Focerqc/testing-BMS-designs/docs/slave-18s-design-basis.md

# ADBMS1818 18S slave: design basis

Status: **schematic complete for a first bench board, PCB roughly grouped with the connector
row and holes placed, 2026-11-06.**
Every part is on the root sheet with Value, Footprint, LCSC and MPN filled in, grouped by
function, and connected with net labels (see "Schematic nets"). kicad-cli ERC: 0 errors, 0
warnings. Hot-plug protection, test points and mounting holes were added on 2026-11-06 (see
"Protection and test points"). Net classes and HV clearance rules are in the project (see
"Net classes and clearance rules"). Placement, outline and routing are not done. The JLC BOM
is `slave-18s/bom.csv`.

## Scope

- One ADBMS1818 monitoring up to 18 series Li-ion cells (4.2 V max each, 75.6 V stack).
- isoSPI daisy chain: port A in, port B out (ISOMD tied to VREG).
- Passive balancing through the internal S-pin switches.
- Thermistor inputs on GPIOs.
- No power switching and no charge control. Those live in the master, a bought ENNOID
  Master-XLITE-ISC (decision 2026-11-06, see `docs/master-ennoid-xlite.md`). No XT30s on
  the slave.

## Variants: 18S Guard and 18S Lean (split 2026-11-06)

| | **18S Guard** (`slave-18s/`) | **18S Lean** (`slave-18s-lean/`) |
|---|---|---|
| Use | Hot-plug harnesses, unknown packs, bench work | Known pack, harness plugged in once; closer to the Ennoid-style slaves |
| Tap fuses F100–F118, supply fuses F119/F120 | yes | no: trace fuses were deferred, so no fuse protection is designed in (clarified 2026-11-11). F120's place is taken by the net tie NT1 (CELL0 to V−, since 2026-11-06) |
| Zener clamps D101–D118 | yes | no |
| V+ TVS D301 | yes | no: with no F119 ahead of it, a shorted TVS would short the whole stack |
| C-pin filter caps C101–C118 | yes | no (Racc's board has none; the 10 ohm resistors stay) |
| Balance resistors R201–R218 | 33 Ω, 2512, 1 W | **120 Ω, 1206, 0.25 W** (since 2026-11-10, try 3; 33 Ω 2010 in tries 1–2) |
| Series resistors R100–R118 (10 Ω) | 1206 | **0402** (since 2026-11-11, try 4; 0603 in try 3) |
| Board outline | 120 × 70 mm | **70 × 32 mm** (since 2026-11-11, try 4) |
| isoSPI transformers T501/T601 | Pulse HM2113ZNL | Bourns SM91502AL (since 2026-11-08, shrink trial) |
| isoSPI PH alternates J6/J7 (DNP) | yes | no (since 2026-11-09, shrink trial): GH plugs J3/J4 only |
| Test points TP1–TP14 | 10 loops + 4 bare pads | none (since 2026-11-10, try 3) |
| Mounting holes H1–H4 | M3 (3.2 mm) | M2 (2.2 mm) (since 2026-11-10, try 3) |
| Collector resistor R302 | 100 Ω, 0805 | **1 kΩ, 2512, 1 W** (since 2026-11-10; deviation 14) |
| Copper layers | 2 | 4 (since 2026-11-10, try 3c) |
| Everything else | identical | identical |

- **Guard is the source.** `slave-18s-lean/*.kicad_sch` is generated by
  `_tools/kicad_sch/make_lean.py` and must not be edited by hand. After any Guard schematic edit:
  `make_lean.py` -> `kicad-cli sch upgrade --force` -> `check_slave18s.py --variant lean`.
- **Lean nets:** the connector pins land on CELLn directly (no TAPn nets), and VBAT_F is CELL18.
  **CELL0 stays its own net** (J1.1 and R100, the C0 sense). It meets V− only at the net tie
  **NT1** (`Device:NetTie_2`, footprint `NetTie:NetTie-2_SMD_Pad0.5mm`, not in the BOM), which
  `make_lean.py` puts where F120 was. On the PCB, NT1 goes right next to J1.1, and DRC then flags
  any other copper joining CELL0 and V− as a short. That keeps supply current (≤ 35 mA) off the
  C0 sense trace, where it would show up as cell 1 error (about 1.4 mV for 20 mm of 0.25 mm
  1 oz copper). This is the same split Guard makes at J1.1 with F100 and F120.
  (Changed 2026-11-06; before that, CELL0 was merged into V−, and DRC couldn't check the sense
  trace.)
- **Lean PCB:** started as a copy of the Guard board. It needs F8 (Update PCB) in KiCad to drop
  the 58 removed footprints and add NT1 (93 footprints), then its own placement. The libraries
  and 3D model are shared from `../slave-18s/`. After F8, run `make_rules.py --variant lean` to
  replace the `.kicad_dru` copied from Guard. Placement and routing plan:
  `docs/slave-18s-lean-layout-plan.md`.
- **Lean shrink trial (2026-11-08).** Lean is being shrunk toward one ~70 × 35 mm slave of the
  long-term XR slot (156.5 × 37 × 10 mm, two slaves on a carrier). First pass: 70 mm wide, 50 mm
  tall for room to try things. The 120 × 70 board is kept on branch `savepoint/lean-120x70`.
  `make_lean.py` swaps two part types for Lean only (its `SWAP` table; Guard keeps the originals):
  - **R201–R218: 2512 → 2010 (UNI-ROYAL 201007F330JT4E, 33 Ω 1 % 0.75 W, LCSC C421858).**
    Reason: the 18-channel row has to fit 70 mm. Stood vertical, a 2010 is 2.5 mm wide (pads
    2.65 mm), so the channel pitch drops from 4.2 to **3.3 mm** (one 0.25 mm trace with 0.2 mm
    each side between neighbouring pads) and the row from 77 to about 62 mm. Loading: 0.26 W of
    0.75 W (35 %, was 26 % of 1 W) at 33 Ω and 4.2 V. All 18 at once is still about 4.7 W in
    the resistors, now in a 62 × 6 mm strip, so alternate odd/even balancing matters more.
    A 1210 has the same width (same pitch) but only 0.5 W.
  - **T501/T601: Pulse HM2113ZNL → Bourns SM91502AL (SM91502ALE, LCSC C915690).** Reason: half
    the area (courtyard 10.2 × 8.2 mm vs 16.8 × 9.6 mm), 5.72 mm tall. Bourns datasheet (rev.
    07/25): one channel **with common mode choke**, 1CT:1CT, OCL 150–450 µH, leakage 0.5 µH max
    (ADI limits: > 60 µH, < 2.5 µH), hi-pot 4300 VDC, **1000 VDC working** (adjacent 18S modules
    sit about 76 V apart), −40 to +125 °C, AEC-Q200, made for isoSPI. Same pin functions as the
    HM2113ZNL (chip 1–2CT–3, line 6–5CT–4 through the choke), so the symbol and nets are
    unchanged. Footprint `slave18s:Bourns_SM91502AL` drawn from the datasheet's recommended
    layout (pads 0.76 × 1.27 mm, 2.54 mm pitch, rows 7.11/9.65 mm). Bourns marks it "not
    recommended for new designs" with **SM91502ALA** as the replacement; JLC stocks only the
    ALE today (1051 pcs, about $5). Rejected: 4.5 × 3.2 mm LAN transformers (TDK ALT4532 class,
    TAI-TECH TXF453229NF), which state 1.5 kV hi-pot but no working voltage, the same gap that
    ruled out HX1188FNL (about 60 V working, Table 74).
  - Placement is generated by `_tools/kicad_sch/lean_place.py` from a few knobs, so each try is
    one command. Try 1 (2026-11-08): everything fits at 70 × 50 except isoSPI port A (T501, J3,
    J6, R501/R502, C501/C502), which is parked beside the board.
  - **J6/J7 removed from Lean (2026-11-09).** `make_lean.py` drops the DNP PH alternates;
    Guard keeps them. Reason: both isoSPI ports only fit the 70 mm board without them. Lean's
    isoSPI cable is GH only (the ENNOID master uses GH anyway). Lean is now 91 footprints.
  - **TP1–TP10: Keystone 5015 loops → bare 1.5 mm pads, and every test point on the back
    (2026-11-09).** `make_lean.py` swaps TP1–TP10 to the same `TestPoint_Pad_D1.5mm` as TP11–TP14
    (no part, not in the BOM, no LCSC/MPN), so Lean has no test-point parts to order. Reason: the
    loops were never asked for (VESC-style BMS boards use bare pads), and the loops plus their
    ≥ 5 mm hook-clip spacing took about 23 × 6 mm of front copper on a board that has to shrink to
    35 mm. All 14 pads sit on B.Cu, so the front keeps its room for the circuit. Cost: probing is
    from the underside with a tip or spring pin, the back needs standoffs (TP11–TP14 carry
    25–75 V), and the pour on the back has small cut-outs round each pad. This is a deviation from
    the single-sided rule, limited to bare pads (no assembly step, no height): `check_pcb_parity.py`
    expects Lean's `TP<n>` on B.Cu and everything else on F.Cu. `lean_place.py` runs
    `flip_back.py --test-points` after placing. isoSPI pads TP7–TP10 hang a short stub on the chip
    side lines when routed; keep it under the pad (via-in-pad is not needed at 1.5 mm) or leave
    them off the final board. Guard keeps the loops on the front.
  - **Try 2 (2026-11-09): everything is on the 70 × 50 board, nothing parked.** Each port is one
    strip right of U1, left to right: R/C column (4 × 0603), transformer (chip side toward U1),
    GH plug at the right edge, courtyards 0.3 mm apart. Port B (T601, J4) on top, 1 mm under the
    R1 row; port A (T501, J3) 0.3 mm under it, ending just above H2. 0 courtyard overlaps, no
    clearance errors with the rules loaded (the 2 mm isoSPI barrier holds, also between the two
    ports), parity PASS. **Cost:** each transformer's courtyard is about 3.7 mm from U1's, and
    the datasheet (p. 86) wants U1 at least 1–2 cm from the transformers. Not solved at this
    width; open item on the placement checklist.
  - **Height:** 35 mm is not reachable with plugs on the top edge. Top to bottom, the cell plugs
    (5.6 mm), tap room (5), the two resistor rows (11.4), fan-in (6) and U1 (13.5) come to about
    41.5 mm before the supply and NTC parts. Without the plugs it is about 31 mm.
  - **Try 2 measured (2026-11-10): the parts are too big for 70 × 35.** Front courtyards add up
    to 1,764 mm²: 50 % of 70 × 50 and 72 % of 70 × 35 (2,450 mm²) before any trace. Largest
    groups: balance resistors 377, isoSPI ports 303, cell plugs 257, series resistors 208,
    M3 holes 196, U1 182 mm².
  - **Try 3 decisions (2026-11-10, by the user, with Racc's answers).** The schematic side is
    done (`make_lean.py`, 77 footprints); the board needs F8 and a new placement.
    - **Balance resistors: 120 Ω in 1206 (UNI-ROYAL 1206W4F1200T5E, LCSC C17909, Basic).** The
      user: low balance current is fine. About 31 mA and 0.12 W per cell, 48 % of the 0.25 W
      rating; all 18 at once is about 2.3 W on the board instead of 6.7 W. This is the value on
      Racc's 12S board. Not 0805: a standard 0805 is rated 0.125 W, no margin (Racc's are 0805
      and he calls that a slight sizing mistake). The 1206 leaves room to go down to about
      82–100 Ω later on the same footprint.
    - **Series resistors: 10 Ω in 0603 (UNI-ROYAL 0603WAF100JT5E, LCSC C22859, Basic).** They
      carry the balance current: about 10 mW at 31 mA, 10 % of the 0.1 W rating. Guard keeps
      1206 (79 mW at 33 Ω). Racc: on his board the 10 Ω could have been smaller.
    - **No test points on Lean.** They were never asked for, Racc's board has none, the same nets
      can be probed on a resistor or capacitor pad, and back-side pads can't be reached with the
      board flat on a carrier. This ends the back-side exception of 2026-11-09: every Lean
      footprint is on the front again.
    - **Mounting holes: M2** (`MountingHole_2.2mm_M2`). The copper keep-out in `make_rules.py`
      is still the M3 figure and has to follow for Lean.
    - **Four copper layers.** Not applied to the board yet; stack-up and the rules that assume
      JLC 2-layer (`make_rules.py`) are chosen when routing starts.
    - **Assembly stays front only, flat on a carrier.** One board has to work both ways: alone
      on a harness (plugs fitted) and on the XR carrier (soldered to it through the JST pin
      holes). So both cell plugs and both isoSPI ports stay on every slave.
    - **Transformer distance accepted: deviation from the datasheet's 1–2 cm (p. 86).** Racc's
      board has its transformers a few mm from the chip and he had no link trouble; he credits
      the split termination and centre-tap caps, which this design keeps (deviation 1).
    - **Q301 copper:** Racc: more is better, no figure. Give it what fits on several layers and
      measure the first board.
    - **Trace fuses:** deferred by the user.
    - **Open:** where the cell plugs go (top edge, a short edge, or fitted from the back as on
      Racc's board, where it was done for ENNOID pin compatibility, not space). Estimated, not
      built: rows 11.4 → about 7.9 mm and tap room 5 → about 2 mm bring the stack-up from 41.5
      to about 35 mm with the plugs on the top edge, with no margin for the supply parts.
    - **Not designed in:** solder jumpers for fewer than 18 cells (Racc's JP4–JP12). Lean is
      18S only; a smaller pack would need the unused inputs shorted in the harness.
  - **Try 3 placed (2026-11-10): 70 × 37 mm, 77 footprints, all on the front, nothing routed.**
    37 mm is the XR slot's own height; 35 mm is still not reached with the plugs on the top edge.
    From `lean_place.py`: cell plugs top-left, the 18-channel row under them at **2.4 mm pitch**
    (44.8 mm long, about as wide as the plugs, so the tap room is 2 mm), U1 under the row's right
    half, both isoSPI ports top-right (GH plug at the top edge, transformer under it with the chip
    side down, its four R/C parts under the transformer), supply column and Q301 right of U1,
    J2 and the NTC parts bottom-left. H3 is on the right edge, not in its corner. The F8 left the
    14 test pads (delete box not ticked) and the locked M3 holes; both were fixed in the board
    file. 0 courtyard overlaps, parity PASS, DRC: silkscreen items and 153 unconnected only.
    - Pad to U1 pin: C304/C305 (VREF) 2.2/2.3 mm, R401/R402 2.2 mm, C303 (VREG) 4.1 mm, C301
      (V+) 4.7 mm, Q301 6–8 mm (try 2: 7–10, 8–9, 10, 28 and 37 mm).
    - Transformer courtyard to U1's: T601 6.5 mm, T501 14.1 mm (try 2: 3.7 mm both).
    - The slot that blocked ch 14–18 on try 2 is gone: nothing sits between the row and U1.
    - **Not good yet:** the NTC filter parts are 34 mm from GPIO1–4 and their nets have to cross
      the ch 0–10 bus (needs an inner layer); Q301 has no reserved copper; the hole keep-out for
      M2 (2.75 mm from the centre, `make_rules.py`) is my figure for a 5 mm washer.
  - **Try 3b (2026-11-10): connectors where the user wants them, the rest placed for routing.**
    The user moved J2 to stand on the left edge (all plugs along or near the top edge) and asked
    that the connectors stay in their areas; everything else was free. From `lean_place.py`:
    - All four holes are in the corners again; the GH plugs sit 5 mm down from the top edge to
      clear H3 (they are top-entry, so they don't need the edge).
    - Tap room 1 mm (the taps also fan out under the plug bodies), row y 6.9–14.8, U1 centred
      under ch 11–18 (centre x 42.5) with 5.3 mm between the row's and U1's courtyards, and
      3.4 mm from U1's courtyard to the bottom edge for the S3…C0 wrap.
    - Right of U1 in its pin order: isoSPI pairs, R402/R401, C304/C305, DRIVE, with C303 under
      pin 48. The port A pair passes under port B's termination row. Q301 bottom-right.
    - Pad to U1 pin: C303 2.3, C304 2.8, C305 3.8, R401 3.6, R402 2.6, C301 4.5, Q301 6.0–8.4 mm.
      Transformer courtyards 6.5 and 15 mm from U1's.
    - **NTC filter parts sit under J2, 39 mm from GPIO1–4.** GPIO1–4 and VREF2 have to cross the
      ch 0–10 bus, so they need an inner layer. The right side of U1 has no room for them.
    - Estimates, to be proven by routing: the ch 11–18 fan-in (worst trace 4.9 mm sideways in
      about 5.6 mm) and the six-trace wrap under U1 in 3.4 mm.
  - **Try 3c (2026-11-10/11): four copper layers, 1 kΩ R302, VCOLL copper for Q301, U1 further
    left.** After the F8 for R302 the user sketched U1 near the middle of the board (centre x
    about 31.5) with Q301 and R302 right of it, and asked why the area left of U1 stays empty.
    From `lean_place.py`:
    - **U1 centre x 37.0** (was 42.5), 5.3 mm under the row as before. Not 31.5: the top side of
      U1 takes C18…C11 and S18…S12, and those come from the right half of the row. At 37 the
      worst trace (ch 18) runs 10.5 mm sideways in the 5.3 mm gap and about 10 traces cross the
      busiest line (about 4.5 mm of the 5.3 mm at 0.25/0.2 mm). At 31.5 it is 16 mm and 12
      traces (5.4 mm), which does not fit on one layer. At 42.5 it was 4.9 mm. **Calculated,
      not routed;** an inner layer can take half of them if it turns out too tight.
    - What the 5.5 mm buys: T601 is about 12 mm from U1 (6.5 in try 3b; the datasheet asks for
      1–2 cm), the VCOLL copper outline is about 40 % larger, and the ch 0–10 bus and the NTC
      nets are 5.5 mm shorter.
    - Right of U1, in its pin order: C301 and R301 lying at pin 1 (under the fan-in, VP_F pads
      toward the pin), the isoSPI pairs, R402, R401, C304, C305, DRIVE, C303 under pin 48.
      Then Q301 (pins toward U1, tab right), C302 above the tab, R302 right of Q301 with its
      VCOLL pad at the tab.
    - **VCOLL copper, reserved as zones (`VCOLL_Q301_front`, `VCOLL_Q301_inner_back`):** outline
      113 mm² on the front and 183 mm² each on In1, In2 and the back, joined by 43 vias
      (0.6/0.3 mm) under Q301's body and right of its tab; none in the tab pad (open vias in a
      pad wick solder). The zones are written unfilled; KiCad fills them (key B). They start
      0.7 mm right of Q301's DRIVE/VREG pads and 1.3 mm under the termination rows (room for the
      port A pair plus 0.6 mm). This is far less than the 25 × 25 mm that DS33175 rates at
      78 °C/W, so **Q301's temperature is still an estimate until a board is measured.**
    - Pad to U1 pin: C303 2.3, C304 2.8, C305 3.8, R401 3.6, R402 2.6, C301 4.1, Q301 6.0–8.4 mm.
    - Checks: 0 courtyard overlaps, parity PASS, `make_rules.py --variant lean --check` OK, DRC
      with the zones filled (`--refill-zones`): silkscreen items and 151 unconnected, no clearance
      errors. Without the fill, DRC reports the 43 vias as dangling.
    - **Stack-up not chosen.** The board file lists four copper layers and nothing more. JLC
      multilayer (capabilities page, 2026-11-10): outer 1 or 2 oz, inner 0.5 oz by default, 1 or
      2 oz on request. Thicker inner copper would spread Q301's heat better.
    - **Still open:** CELL18 has to reach R302's far pad round the isoSPI ports on an inner layer;
      the NTC parts are still under J2, about 33.5 mm from GPIO1–4.
    - **30 mm height (the user's wish, so connectors fit on the carrier above the slaves):** the
      37 mm is plugs 5.6 + tap room 1 + rows 7.9 + fan-in 5.3 + U1 13.5 + wrap 3.4. Taking the
      cell plugs off the slave removes 6.6 mm (about 30.4 mm left); nothing else in the stack
      gives that much. Not decided.
  - **Try 4 (2026-11-11): 70 × 32 mm, placed, nothing routed.** The user: the cell plugs stay
    on the slave, and 5 mm should come off the height so the carrier (37 mm) can hold connectors
    above the slaves. Try 3c (70 × 37) is commit `5306098`. From `lean_place.py`:
    - **Where the 5 mm came from.** With the try 3c parts only 3.7 mm was left for the fan-in
      above U1 plus the room below it (8.7 mm at 37 mm). So:
      R100–R118 **0603 standing → 0402 lying** (row 3.05 → 1.03 mm, 2 mm); tap room 1.0 → 0.5 mm;
      room under U1 3.4 → 1.3 mm. The fan-in gap is 4.9 mm (was 5.3).
    - **R100–R118: 10 Ω 1 % 0402, UNI-ROYAL 0402WGF100JTCE, LCSC C25077, Basic** (about 4 M in
      stock, local parts DB). They carry the balance current: about 10 mW at 31 mA, 16 % of the
      62.5 mW rating (about 20 mW if the balance resistors later go down to 82 Ω). Lying, a
      part is 1.95 mm wide at the 2.4 mm pitch; Sn comes down through the 0.9 mm between the
      pads of two neighbours. Lean has no C-pin caps, so no inrush runs through them.
      `make_lean.py` `SWAP`; Guard keeps 1206.
    - **U1 centre x 36.0**, courtyard 1.3 mm from the bottom edge. One trace fits under it, so
      only VREG (pin 48 to C303) runs there. **S3…C0 and GPIO1–4 have to leave the bottom pins
      through vias under the chip** (between the pad row and the EP) and continue on inner
      layers. GPIO5–9 go to the EP (V−).
    - Right of U1, a bottom-aligned column 0.6 mm from U1 in pin order: R402, R401, C304, C305,
      a 0.9 mm gap, C303. C301 and R301 lie at pin 1. The two isoSPI pairs leave through the
      2.8 mm between C301 and the column.
    - **Q301 stands right of the column: pins at the bottom edge, tab up.** The 6 mm under the
      termination rows is too low for it lying (7.3 mm). U1 sits at 36 and not 37 so Q301 ends
      just left of R601. Its pins run DRIVE, VCOLL, VREG from the left: VREG (22 mA) comes back
      under the body and through the column gap to C303; **DRIVE (1 mA) has to hop over it on an
      inner layer** (two vias). C302 stands right of Q301 with its VCOLL pad up at the tab; R302
      stays a 2512, lying right of C302 on the bottom edge.
    - **VCOLL copper: one zone `VCOLL_Q301` on all four layers,** outline 119 mm² each, round
      Q301 and under C302/R302, with 31 vias. Try 3c had 113 mm² on the front and 183 mm² on each
      of the other three layers, so Q301 will run hotter here. Still an estimate until measured.
    - **The port A pair has no path on the front** past Q301 and port B's termination row: inner
      layer from near U1 to port A's row.
    - Fan-in: ch 18 runs 11.2 mm sideways (R118 at x 50.4 to pin 2 at 39.25) in 4.9 mm. About
      ten traces cross the busiest line (4.5 mm at 0.25/0.2 mm), so part of it will probably
      need a second layer. Calculated, not routed.
    - Pad to U1 pin: C303 4.5, C304 2.4, C305 2.7, R401 2.6, R402 2.4, C301 4.1, Q301 DRIVE 6.9,
      Q301 VREG 12.9 mm. T601's courtyard is 10.1 mm from U1's; the NTC parts are about 32 mm
      from GPIO1.
    - Checks: 0 courtyard overlaps, parity PASS, `make_rules.py --variant lean --check` OK, DRC
      with the zones filled: silkscreen items and 150 unconnected, no clearance errors.
    - **What makes 32 mm harder than 37 mm:** five things need inner layers (U1's bottom pins,
      DRIVE, the port A pair, CELL18 to R302, the NTC nets), the VCOLL copper is smaller, and
      the fan-in has less room. The first two of these are routed (next bullet); if the rest
      fails, go back to `5306098`.
    - **Where the slave sits in the slot (the user, 2026-11-11):** on the slot's **bottom**
      edge. The 5 mm above it, next to the slave's own cell plugs, is for the connectors on the
      carrier. The "XR slot overlay" drawing on the board's Dwgs.User layer shows it that way
      (slot y −5…32 in board coordinates; it had the slave on the top edge before).
    - **Board Boxes shows the inner layers** since 2026-11-11: In1.Cu (green) and In2.Cu
      (orange) buttons beside F.Cu and B.Cu. The cell lines that look missing with only F.Cu
      on are either on an inner layer (S12–S18, ch 0–2) or not routed yet (ch 3–10).
  - **First routing on try 4 (2026-11-11): the two riskiest pieces, 29 nets, DRC clean.**
    `_tools/kicad_sch/lean_route.py` writes the tracks and vias from the pad positions, so it
    can be run again after `lean_place.py`. 221 segments (front 119, In1 35, In2 67), 30 vias
    of 0.5/0.2 mm. DRC with the zones filled: no clearance, short or hole errors; unconnected
    items 150 → 112.
    - **ch 11–18 fan-in.** C18_F…C11_F run on the front in eight lanes at 0.45 mm pitch
      (y 13.05–16.2), the lowest lane for ch 18. S18…S12 do not share that gap: each drops to a
      via 0.6 mm under the series row, crosses on **In1** (seven lanes at 0.6 mm) and comes up
      at a via just inside U1's top pad row (0.55 mm from the pads, 1.6 mm from the exposed
      pad). So the front carries 8 traces where 15 were counted, and the 4.9 mm gap is not
      tight any more.
    - **V+ filter.** U1 pin 1 straight to C301; C301 to R301 over the top of C301 at y 16.8,
      0.6 mm above C301's V− pad (VP_F is top of stack); CELL18 from R118 down to R301.
    - **U1's bottom pins.** S2, C1_F, S1, C0_F and GPIO1–4 (pins 35–42) fan out with 0.2 mm
      tracks to **one row of eight vias under the chip** (y 27.2, 0.75 mm pitch, between the
      pad row and the exposed pad) and leave on **In2** in eight lanes going left. The four
      cell nets turn up at x 12.5–13.9 and end in vias at R202, R101, R201 and R100; GPIO1–4
      end in vias at their NTC filter parts (GPIO1 also reaches J2 pin 1). All eight are
      bank 0, so they may run side by side.
    - **S3 and C2_F** (pins 33, 34) leave on the front along the strip under U1 (two lanes,
      y 30.8 and 31.26; copper may go to 31.5) and go up at x 20.9 and 20.4 to R203 and R102.
      That is the outside of the ch 3–10 bus: the 16 left-side pins still have to be routed
      inside it, nested the same way.
    - **VREG** runs along the same strip from pin 48 to C303 (0.3 mm at the pin, then 0.4 mm).
      **GPIO5–9** are joined across their pads and tied to the exposed pad from pin 45.
    - Longest nets: GPIO1 50 mm, C0_F 48 mm, S1 46 mm (inner layer, bank 0).
      Clarified 2026-11-11: C0_F carries cell 1 balancing return (~31 mA) while balancing,
      not only microamp sense current; DCP=0 pauses balancing during measurements.
      The C0 sense now runs 48 mm on In2 beside S1; cell 1's balance current returns through
      R100 and C0_F's pin only as far as the datasheet's Figure 99 intends, but the long
      parallel run should be looked at before ordering.
    - The rest was routed the same day (next bullet); only the V− pour is left.
  - **Routing on try 4 finished except V− (2026-11-11): 81 nets, DRC clean, 20 unconnected,
    all V−.** Five more functions in `lean_route.py`, one commit each: 652 segments (front 494,
    In1 69, In2 86, B.Cu 3), 52 vias of 0.5/0.2 mm. A second run changes nothing. Checks after
    each piece: `lean_route.py --drc` (zones filled), `check_pcb_parity.py --variant lean`,
    `make_rules.py --variant lean --check`, a picture. Nothing fell back to 37 mm.
    - **ch 3–10 bus (`bus_3_10`).** U1's left pins 32–18 on the front, inside S3 and C2_F.
      Pins 32–24 (C3_F…C7_F) take lanes 0.48 mm apart from x 21.4, each turning 0.5 mm
      higher than the one outside it, and go left to their resistors. S8 and C8_F go straight
      up. The resistors of pins 21–18 (S9…C10_F) are right of any lane, above U1's top-left
      corner, so those four turn right, and there the **outer** lane turns highest. Nothing
      crosses either way.
    - **S11 is on In1, not the front.** C10_F, S10 and C11_F close every front path from pin
      17 to R211. Like S12, it drops to a via just inside the pin row and crosses on In1 one
      lane above S12. Its via under R211 sits 0.33 mm below the series row, above C11_F's
      front lane, 0.225 mm from it.
    - **Taps (`taps`).** Each plug pin goes straight down and takes one 45° leg to its R2 top
      pad, so neighbours stay parallel. CELL9 comes from both plugs. From the R2 pad, CELLn
      runs right into the 0.65 mm gap to R2(n+1) as a **0.2 mm track** (0.225 mm each side;
      31 mA), down past the S pads and jogs into R1n's CELL pad. CELL0 squeezes between NT1
      and R201 (0.2 mm, 0.205 mm each side) to R100, with a branch to NT1.
    - **Supply (`supply`).** VREG leaves Q301 pin 3 upwards and runs left under the body at
      y 27.97, 0.6 mm below the lowest VCOLL via row (VCOLL can reach top of stack;
      its operating range was corrected on 2026-11-11). It goes down
      left of DRIVE's pad and through the C305–C303 gap to C303. Pin 55 (ISOMD) joins VREG
      through In1 from a via inside the pin row. VREG closes DRIVE's pad in, so DRIVE goes
      down the channel right of U1, crosses on In1 and comes up in the 1.25 mm pocket between
      VREG and its pad. The VREG track also cuts Q301 pin 2 off the tab on the front. A 0.5 mm
      via above pin 2 ties it to the inner VCOLL copper.
    - **CELL18 to R302 on In2.** It drops on its track from R118 to R301 (y 15.6). It passes
      under T601's courtyard at y 22.95, between the IPB vias, then goes down right of Q301's
      via grid (x 55) and along y 27.6 between the VCOLL via rows to a via above R302's
      CELL18 pad. **Correction 2026-11-11:** the shared bank-6 assumption was wrong for
      Lean's 1 kΩ R302. Its peak drop requires 0.6 mm clearance; the lower lane is now
      y 27.8 (review-fix entry below). The In2 VCOLL copper
      is cut along that line but stays joined round the right end.
    - **The VCOLL grid blocks inner tracks.** Its vias sit 1.15 mm apart, and a 0.25 mm
      track needs 0.65 mm between via edges. Anything crossing Q301 on an inner layer must go
      round the grid.
    - **isoSPI port B (`isospi`), front.** IPB goes into T601 pin 1 from the left. IMB runs
      under the transformer pins at y 22.37 (0.615 mm from Q301's tab, 0.455 mm from the
      termination pads) to R602 and up into pin 3. CT runs over the pins under the
      transformer body and down right of C602. CM runs between R601 and R602 and along the
      bottom pads. **IPB to R601's bottom pad would have to cross IMB whichever way IMB goes,
      so it hops on B.Cu** (two vias, 3.4 mm).
    - **isoSPI port A: In1, as planned.** Its pins sit below port B's, so IPA and IMA drop to
      In1 right of U1 and pass under T601's courtyard (the courtyard rules have no layer, so
      a foreign track may not cross under a transformer on any layer). IPA comes up left of
      R501. IMA comes up between T501's pins 1–2 and the row (for R502) and under the body
      (for pin 3). **CT_A has no front path to C502**: the board edge is right of it. It
      crosses on In2 from under the transformer body to below C502.
    - **Each port's two V− caps share a via** between them (C601/C602, C501/C502). The line
      side runs straight from transformer pins 6/4 to plug pins 1/2. DRC: the 2 mm barrier,
      the no-pour and the only-own-tracks rules are all clean.
    - **Chip-side isoSPI lengths:** IPB 17.7, IMB 20.4, IPA 26.3 and IMA 32.9 mm (branches to
      the termination included). **Correction 2026-11-11:** p. 86 limits the
      transformer-to-connector distance to <2 cm, not these chip-side runs. It asks U1
      to be close to, but at least 1–2 cm away from, the transformer; chip-to-transformer
      spacing is already an accepted deviation (try 3). Foreign crossings remain open.
    - **VREF/bias and NTC (`bias_ntc`).** VREF1, IBIAS and ICMP go straight across the
      channel to C304, R401 and R402; ICMP's second resistor joins between the R402 and R401
      rows. VREF2 runs down the channel beside DRIVE to C305, drops inside the pin row and
      crosses to the NTC parts on **In1** (30 mm along y 28.3, under the bottom-pin via row).
      On the front it feeds R701–R704 along the two 0.9 mm channels between the three part
      rows. GPIO2 reaches C702 from J2 pin 3 down the left board edge (x 0.9, 0.775 mm from
      the edge) and R702 on In1. GPIO3 comes from J2 pin 5 down the same edge on In2. GPIO4
      reaches TH701 under the bottom row.
    - **Layers used, as of now.** In1: S11–S18, VREG (pin 55), DRIVE, port A, VREF2,
      GPIO2. In2: U1's bottom pins, GPIO1–4, CELL18, CT_A. B.Cu: the IPB hop only. All
      four layers carry the VCOLL zone round Q301.
  - **V− pour on B.Cu, stack-up decided (the user, 2026-11-11): every net connected, DRC
    clean.** `lean_route.py` `v_minus()`; DRC with zones filled: 0 unconnected, no copper
    errors (silkscreen only). Board file has the zone unfilled; KiCad fills it on opening.
    - **Stack-up:** V− is a pour on **B.Cu**, which only had the IPB hop and the VCOLL zone.
      In1 and In2 carry signals. **Copper: JLC's standard 1 oz outer / 0.5 oz inner** (no
      2 oz outer under the 0.5 mm-pitch QFP). The board file has no stackup section; this is
      an order setting.
    - **The pour** covers the board 0.5 mm in from the edge, with a notch round the isoSPI
      ports (T501, T601, J3, J4 courtyards; no pour there). Priority 0, so Q301's VCOLL zone
      (priority 1, all four layers) wins. The stack-bank and barrier rules set its clearance
      to each net.
    - **Vias:** one 0.5 mm via with a short stub at each SMD V− pad: C301, R402,
      C304/C305 (one via between them), C303, C302, C701, C702, TH701 (C703 and C704 join it
      along the channel between rows 2 and 3), NT1. U1's pins 52/59/60 go straight in to the
      exposed pad; J2's V− pins and U1's exposed pad reach B.Cu through their own holes.
    - **Next to VCOLL:** the vias at R402 and C303 sit close to the VCOLL zone and get a
      B.Cu stub out into the pour. C302's V− pad is inside the VCOLL copper: its via has a
      B.Cu track up between Q301's via grid and the strip vias to the pour above.
    - **The termination-row strip** (port V− vias, C302, the H2 corner) is cut off from the
      rest of B.Cu by the VCOLL copper and the IPB hop. It joins on **In1**: a V− track from
      port B's cap via to the R402 via, between port A's IMA lane and the IPB via (0.21 mm
      each side).
  - **Review fixes (2026-11-11, branch `review-fixes-lean`).** No footprint, outline,
    schematic or layer-role change. Corrects the project rule at peak current; it does not
    establish a dielectric-breakdown risk at the normal 22–23 V collector drop.
    - **VCOLL range:** R302 is 1 kΩ ±1%, Ipeak = 35 mA: drop 0–35.35 V. The declared
      operating cell range is 2.5–4.2 V (45–75.6 V stack), not a hot-plug/fault model.
      Relative to the stack, VCOLL's equivalent level spans 18−35.35/2.5 = 3.86 to 18.
      For another net's tap envelope lo..hi, the signed difference is bounded by
      (18−hi)×2.5−35.35 and (18−lo)×4.2 V. Test both endpoints against 30 V.
      Cn_F may rise towards C(n+1) during balancing, Sn may fall towards C(n−1).
      Existing bank clearances remain a conservative floor; the later 2 mm isoSPI rule
      still wins. Guard's 100 Ω drops only 3.535 V; its generated content is unchanged.
    - **Copper:** CELL18's lower In2 lane/end via moved from y 27.6 to 27.8. Removed the
      three stitching vias at x 62.21 (y 28.4/29.55/30.7), and the remaining top body row
      at y 28.4 (x 58.76/59.91/61.06). Stitching vias 31 → 25; the separate 0.5 mm
      Q301 pin-2 via at (50.34,29.05) remains after placement then routing.
    - Nearest relevant clearances: R302 CELL18 pad-to-stitching-via 0.350 → at least
      1.200 mm (pad bounding-box lower bound); end via 0.559 → 0.750 mm; horizontal
      In2 CELL18 lane-to-stitching-via 0.375 → 0.825 mm. Filled-zone DRC passes.
    - Zone outline stays **118.6962 mm² per layer**. Filled VCOLL copper before → after:
      F.Cu 78.940 → 75.487; In1 98.040 → 96.402; In2 103.811 → 93.537;
      B.Cu 105.302 → 103.663 mm². Total loss 17.004 mm² summed across layers;
      that sum is not a thermal-equivalent exposed area. Thermal acceptance remains open.
    - **isoSPI remains unchanged on the real board.** Centreline checking finds 20
      foreign crossings: eight CELL18/port crossings and twelve port-A/port-B crossings.
      Same-port and V− crossings are excluded. Proposed option: A on B.Cu, B's short hop
      on In1, a connected V− shield on In2 outside the transformer courtyards, and CELL18
      routed west of the ports. This changes layer roles and requires the owner's choice;
      scratch feasibility is not authorization to change the real board.
      **Count (corrected 2026-11-13): 20 crossings, none covered: 12 port A against port B,
      8 CELL18 against either port.** `_tools/kicad_sch/isospi_shield_check.py` first reported
      6 (2026-11-11) and that figure replaced the 20 for two days. It was wrong: the check
      treated only the transformer centre-tap, termination and line nets as isoSPI lines, so
      the chip-side pairs IPA/IMA and IPB/IMB were never checked against the other port
      (commit `0f53001` groups each port's chip-side pair with its own nets). With that fixed
      it finds the same 20 as the first raw count. Rerouting alone cannot go below 10 (see
      "Lean cell plugs" for the plan). The Guard board was not counted with this script.
  - **isoSPI Option 1 applied (2026-11-14, `ffcbc22` schematic, `d139588` PCB): 0 foreign
    crossings.** The floorplan stays (U1, cell plugs, resistor rows, NTC block, T501/T601,
    J3/J4, holes, outline); a few small parts move.
    - **Why 0402:** port B's termination has to leave the strip under T601 for port A. Between
      U1's courtyard (x 42.74) and T601's (x 52.82) there are 10.08 mm, and the band between
      the stack-top V+ filter (C301/R301, 0.6 mm rule) and port A is 1.9–2.4 mm high. Four
      0603 parts (3.05 × 1.55 mm courtyards) need 13.1 mm lying and are too tall standing, so
      R601/R602 (51 Ω, 0402WGF510JTCE, C25125) and C601/C602 (10 nF 50 V X7R, CL05B103KB5NNNC,
      C15195) are 0402 on Lean (`make_lean.py` swap table). Guard keeps 0603.
    - **Port B (front):** IPB runs on a low lane (y 21.15) straight into T601 pin 1; IMB runs on
      a high lane (y 19.45) over pins 1–2 inside T601's body into pin 3. At T601's left edge the
      order has to be IMB, CT, IPB, while U1 has IPB above IMB, so IMB crosses IPB once, on In1,
      next to the chip (same port). R602 stands on the IMB lane, R601 on the IPB lane, C601 lies
      between them on the CM node with its V− via. C602 lies just left of T601 above the IMB
      lane; CT reaches it on In1 under IMB inside T601's own courtyard.
    - **Port A:** drops to In1 at its pins, runs under port B's lanes (y 21.8 / 22.3) and drops
      at 45° into the strip under T601 (y 22.65 / 23.25). On the front the pair cannot pass Q301's
      tab corner and T601's courtyard corner: the gap is 0.95 mm, the pair needs 1.3 mm with the
      0.6 mm VCOLL rule. The T501 end is unchanged.
    - **CELL18 to R302 (In2):** from a via at R301, down the 2.4 mm gap between U1's exposed pad
      and its right pad column (x 39.35), out under pins 51/52 (y 26.0), then between the V−,
      DRIVE and VCOLL vias along the bottom edge (y 28.6, 30.03, 31.0), at 0.6 mm or more from
      each. R302 is turned so its CELL18 pad is on the left. The VREF2 via did not have to move.
      CELL18 on the front now turns left at y 16.8 to R301, which frees the corner for C602.
    - **VCOLL:** zone top 23.05 over Q301 (0.6 mm below IMA) with a notch at T601's corner
      (x 51.2–53.98 down to y 24.0) on all four layers; R302's body vias moved with the turn
      (25 → 28 stitching vias). Filled copper: F.Cu 75.5 → 72.5, In1 96.4 → 105.6, In2 93.5 →
      95.1, B.Cu 103.7 → 103.3, total 369.1 → 376.5 mm². The B.Cu V− strip under the
      transformers now joins the pour through the notch; the In1 V− link and the IPB B.Cu hop
      are gone.
    - **Track lengths (mm, before → after):** IPA 26.3 → 25.7, IMA 32.9 → 32.3, IPB 17.7 → 12.7,
      IMB 20.4 → 20.4, CT A/B 11.4 / 10.2 → 11.4 / 7.5, CM A/B 5.0 / 5.0 → 5.0 / 2.1, line sides
      4.0, CELL18 43.7 → 60.0 (`lean_route.py --dry` prints them).
    - **Checks:** `isospi_shield_check.py` 0 crossings (was 20); no track of one port within
      0.25 mm of the other port's pads in projection, except U1's neighbouring pins; parity
      PASS; rules OK; checker 0 problems, ERC 0/0; zone-filled DRC 0 unconnected, no copper
      errors, silkscreen 88 / 78 / 3. A second place-then-route run changes nothing.
    - **Needs the reviewer's OK before ordering:** port B's termination now sits at the chip end
      of the pair instead of at the transformer. Datasheet p. 86 does not say where the
      termination goes. Port A's stays at its transformer.
  - **isoSPI Option 2 feasibility, a port at each end (2026-11-14, scratch only, branch
    `lean-split-ends`).** Courtyard placement on scratch copies, lanes counted at the as-built
    pitches (front 0.45, In1 0.6, bus 0.48 mm), no routing. The real board is unchanged.
    - **As first drawn (U1 turned 180°): does not fit.** Cells 3–10 face right and 11–18 face
      down, so 16 nets wrap three-quarters round the chip: 10 front + 9 In1 lanes above U1, 9 + 7
      under it, 17 + 15 right of it. Height 12.32 (rows) + 6.1 + 13.49 + 6.6 = **38.5 mm** (37.2
      at the tightest legal pitches), over the 37 mm slot. Port B's chip-side run would be 47–56 mm
      (67–70 mm on a 63 mm-wide version with J2 moved into the free area).
    - **U1 turned 90° clockwise from today (rotation 180): 70 × 34.2 mm, 0 courtyard overlaps.**
      Pin sides checked on the footprint: cells 0–2 on the left side, 3–10 on the top, 11–18 down
      the right side in the resistor row's order, so no cell lane passes under the chip. The bottom
      side carries DRIVE, VREF2/1, VREG, IBIAS/ICMP, then IMA/IPA (61/62) and IMB/IPB (63/64) at
      the right end: port A turns left along the bottom edge to T501 + J3 at the left end, port B
      right to T601 + J4 in the bottom-right corner. The pairs part at the pins and never meet.
    - Lanes: above U1 7 front + 6 In1 (today 8 + 7), plus 6 on In2 (GPIO1–4 and VREF2 to the NTC
      parts at the top right, CELL18 to R302 at the left end); right of U1 9 front + 7 In1 in a
      4.8 mm zone; left of U1 3 + 3; under U1 a 3.5 mm band for five reference/bias stubs from the
      corner column and then port A (today's strip is 1.3 mm). Height 12.32 + 4.9 + 13.49 + 3.5 =
      34.2 mm; 33.7 if the gap above U1 shrinks to its 7-lane need.
    - isoSPI in the sketch: 0 foreign crossings, 0 port A × port B. Chip-side tracks IMA 26,
      IPA 22, IMB 22, IPB 30 mm. Transformer to plug 3.3 mm on both (p. 86: < 2 cm). U1 to each
      transformer about 18 mm, which for the first time meets p. 86's "at least 1–2 cm".
    - Placement: J2 stands on the top edge right of the cell plugs, NTC parts beside it. Left end:
      R302, C302 and Q301 (lying, pins toward U1) over T501/J3, port A's termination column at
      T501's chip side, the reference column at U1's bottom-left corner. C301/R301 right of U1's
      bottom-right corner. H1 moves into the free area, H2 above J4. Port A's termination in 0402
      would give about 1 mm of width, not height.
    - Still open: 2.2 mm over 32 mm (it fits the slot, with less room for carrier connectors).
      Standing 0805 balance resistors would take about 1.6 mm off if a ≥ 0.25 W 0805 120 Ω part is
      in stock (a standard 0.125 W 0805 is too small at 0.12 W). A free area right of the lanes
      could make the board narrower. Rewrite cost: about 90 % of `lean_route.py`'s routing code
      (all but `taps()`) and a quarter of `lean_place.py` (`floorplan()`, `vcoll_area()`).
    - Reproduce: `split_ends_place.py` (KiCad's Python, scratch copy, `--fan 4.9 --band 3.5`) and
      `split_ends_render.py` (lane count, crossing check, picture).
- Balance resistor value: decided for Lean on 2026-11-10 (120 Ω, above). Still open for Guard
  (Racc: about 7 W board peak at 33 ohm with every cell balancing, a lot for a passively cooled
  board with no airflow).

## The chip (from the datasheet, Rev. B)

- **Package:** 64-lead LQFP with exposed pad, 10 × 10 mm, 0.5 mm pitch. Two outlines exist:
  05-08-1982 (EP 5.74 mm) and SW-64-2 (EP 5.50 mm). The stocked JLC part
  (ADBMS1818ASWAZ-RL) is SW-64-2. Footprint: stock KiCad
  `Package_QFP:LQFP-64-1EP_10x10mm_P0.5mm_EP5x5mm_ThermalVias`. Its 5 × 5 mm pad sits
  inside both EP sizes. The 6.5 mm variant would overhang the EP.
- **EP is pin 65 = V−.** It must be soldered, and it must join pins 59/60 (V−) outside the IC.
- **Cell pins run downward:** pin 2 = C18, pin 3 = S18, … pin 36 = C1, pin 37 = S1,
  pin 38 = C0. In general Cn = pin 38 − 2n and Sn = pin 39 − 2n.
- Right side: 39–47 GPIO1–9, 48 VREG, 49 DRIVE, 50 VREF2, 51 VREF1, 52 DTEN,
  53 SDI (NC in isoSPI mode), 54 SDO (NC), 55 ISOMD, 56 WDT, 57 IBIAS, 58 ICMP,
  59/60 V−, 61 IMA, 62 IPA, 63 IMB, 64 IPB.
- Symbol `slave-18s/symbols/ADBMS1818.kicad_sym` was built from Figure 2 and Table 14.
  The exported netlist was checked pin by pin against that map (65 pins, 0 mismatches).
  No eval board files were supplied, so there was no second source to cross-check.
- Discharge switch on-resistance: 4 Ω typ, 10 Ω max (V_CELL = 3.6 V). Thermal shutdown
  about 150 °C (it turns the discharge switches off).
- VREG current: 15 mA typ / 16.5 mA max in measure mode, plus 4.0–6.5 mA for isoSPI ready
  (ISOMD = VREG). The datasheet says the peak approaches 35 mA when converting and
  communicating at once.

## Baseline: datasheet Figure 112 (typical application)

| Block | Value | Note |
|---|---|---|
| C-pin series resistor | 10 Ω | Per input, C0–C18 (19) |
| C-pin filter cap | 100 nF **to V−** | Per Cn, C1–C18 (18), after the 10 Ω. Grounded-cap filter, so each cap sees up to the full stack: **100 V rated** |
| S-pin balance resistor | 33 Ω | From the cell node (before the 10 Ω) to Sn |
| V+ filter | 100 Ω + 100 nF (100 V) V+ to V− | The earlier note said 10 nF. Figure 112 shows 100 nF |
| DRIVE regulator | NPN, 100 Ω from top of stack to collector, **100 nF** (100 V) at the collector, 1 µF at VREG (emitter) | Figure 112 shows 10 nF. We use the datasheet text's 100 Ω / 100 nF RC (deviation 6) |
| VREF1 / VREF2 | 1 µF each | |
| isoSPI termination | 100 Ω | Split 2 × 51 Ω with centre-tap caps (below) |
| IBIAS / ICMP | IBIAS–1 kΩ–ICMP–1 kΩ–V− | |
| ISOMD | to VREG | isoSPI mode |

Correction: the earlier version of this note listed a "C-to-S filter cap". Figure 112 puts
the 100 nF from each Cn to **V−**, not to S. That changes the voltage rating from cell-level
to stack-level (100 V parts).

## Deviations from Figure 112

1. **isoSPI filtering (Racc's design):** termination split into 2 × 51 Ω with 10 nF from the
   centre point to V−, plus 10 nF on the transformer chip-side centre tap. Keeps isoSPI
   working while the motor runs. This is not really a deviation from the datasheet, only
   from the simplified Figure 112. The isoSPI text (p. 81) calls the plain 100 Ω of Figure 103
   "inadequate for most designs" and says RM must be split and bypassed. Figure 104(B) is
   exactly this circuit: 2 × 51 Ω, 10 nF midpoint to V−, 10 nF chip-side CT to V−, plus a
   100 µH CMC (HM2113ZNL has the choke built in). **Don't go above 10 nF:** the datasheet
   says larger CT caps can keep the isoSPI common mode from settling.
2. **Regulator NPN in a big package.** Dissipation ≈ (V_stack − I·100 Ω − 5 V) × I_reg. At
   75.6 V and 20–23 mA (measure + isoSPI) that's about 1.4–1.6 W, with peaks near 35 mA.
   FZT853 (SOT-223, 3 W on 52 × 52 mm of 2 oz copper) needs generous collector copper.
3. **Thermistors:** 100 kΩ pull-up to VREF2, 100 kΩ NTC, 100 nF on the GPIO (Racc's
   arrangement). Three cell NTC inputs on GPIO1–3 and one onboard 0603 NTC on GPIO4.
4. **Balance resistor 33 Ω in 2512 (1 W).** See sizing. Two 68 Ω 1206s were the
   alternative, but C17976 (68 Ω 1206) is an Extended part too, and each 1206 would run at
   about 82 % of its 0.25 W rating on a board that heats up while balancing.
5. **isoSPI transformer HM2113ZNL instead of HX1188FNL.** See the transformer section.
6. **Collector cap 100 nF instead of Figure 112's 10 nF.** The datasheet text (Simple Linear
   Regulator) recommends a 100 Ω, 100 nF RC on the collector to protect the NPN from transients.
   It's also the same Basic part as the filter caps (C28233), so there's one fewer Extended line.
7. **Tap fuses F100–F118 and split supply fuses F119/F120 (2026-11-06).** Figure 112 has none.
   Source: ADI AN-2093 (ADBMS1818 slave module) Fig. 11. See "Protection and test points".
8. **Zener clamps D101–D118 between neighbouring C pins (2026-11-06).** Figure 112 has none.
   Source: abs max Table 11 (p. 11, 8 V between C pins), AN-2093 Fig. 12.
9. **TVS D301 across the stack after F119 (2026-11-06).** Source: V+ abs max 112.5 V
   (Table 11), FZT853 VCEO 100 V, AN-2093 D1401.
10. **R100–R118 in 1206 instead of 0603 (2026-11-06).** Figure 99 (p. 75) shows the balance
    current of cell n returning through the C(n−1) series resistor, so each 10 Ω carries
    about 89 mA (≈ 79 mW, 79 % of an 0603's 0.1 W). The 1206 is rated 0.25 W.
11. **Test points and mounting holes (2026-11-06).** Not part of the circuit; bench access.
12. **isoSPI connectors J3/J4 = JST GH 2P vertical (BM02B-GHS-TBT), with JST PH 2P alternates
    J6/J7 (DNP) (2026-11-06; J6/J7 are Guard only since 2026-11-09).**
    Figure 112 shows no connector. The bought ENNOID master and ENNOID's slaves use GH 2P for
    isoSPI, so the master's cable plugs straight in. The top-entry (vertical) header replaced the
    side-entry SM02B-GHS-TB the same day, so the ports no longer have to sit on the board edge
    with their openings facing out. J6/J7 are PH footprints wired in parallel
    and left unfitted, so a PH header or two bare wires can be soldered instead. See
    "Connectors".
13. **GPIO5–GPIO9 tied to V− (2026-11-06).** Figure 112 leaves them open. The ENNOID firmware
    never turns their internal pull-downs on, so they would float. See "Configuration and unused
    pins".

14. **Lean only: collector resistor R302 = 1 kΩ in 2512 (1 W) instead of the datasheet's 100 Ω
    (2026-11-10). Claude's proposal, approved by the user; not from Racc and not from the
    datasheet.** The datasheet (p. 71) recommends a 100 Ω, 100 nF RC on the collector and
    requires the collector supply to be at least 6 V above V−. Reason for 1 kΩ: it moves heat
    out of Q301. At 75.6 V and about 22 mA (measure + isoSPI) R302 takes about 0.48 W, and Q301
    drops from about 1.5 W to about 1.07 W ((75.6 − 22 − 5) V × 22 mA).
    - Headroom: at 45 V (2.5 V per cell) and the 35 mA peak the collector is at 45 − 35 = 10 V,
      4 V above the limit (9.65 V with the resistor 1 % high). It reaches 6 V at a 41 V stack
      (2.28 V per cell) at 35 mA, or at 28 V at 22 mA.
    - R302 loading: 0.48 W of 1 W at 22 mA, 0.53 W at the 23 mA table maximum (16.5 + 6.5 mA).
      A **sustained** 35 mA would be 1.2 W, above the rating; the datasheet gives 35 mA as a
      peak while converting and communicating at once, so it is treated as a transient. The
      part is rated 200 V.
    - C302 (100 nF) stays; with 1 kΩ the RC corner drops from 16 kHz to 1.6 kHz.
    - Part: UNI-ROYAL 25121WF1001T4E, 1 kΩ 1 % 1 W 200 V, LCSC C54315, Extended, 83 k in stock
      (local parts DB, 2026-11-08). Same family as Guard's 2512 balance resistors.
    - Done in `make_lean.py`'s `SWAP` table. Guard keeps 100 Ω 0805.

## Balance resistor sizing

Uses the datasheet switch resistance (4 Ω typ, 10 Ω max). **Corrected 2026-11-06:** the first
table ignored the 10 Ω filter resistor. Figure 99 (p. 75) shows the discharge path as
CELLn → R2nn → Sn → internal switch → C(n−1) pin → R1(n−1) → CELL(n−1), so the loop is
R_S + R_switch + 10 Ω. The tap fuses add roughly 2 × 0.7 Ω more (cold resistance, not yet
checked against the Littelfuse sheet), which lowers the current slightly; it is left out here.

| R_S | I at 4.2 V (4 Ω switch) | I at 4.2 V (10 Ω switch) | P in R_S at 4.2 V |
|---|---|---|---|
| 120 Ω (Racc's board) | ~31 mA | ~30 mA | 0.12 W |
| 47 Ω | ~69 mA | ~63 mA | 0.22 W |
| **33 Ω (Fig. 112)** | **~89 mA** | **~79 mA** | **0.26 W** |

- 0.26 W in a 1 W 2512 is about 26 % loading.
- Each 10 Ω series resistor carries the same current: about 79 mW, hence 1206 (deviation 10).
- All 18 balancing at once is about 6.7 W on the board (18 × 4.2 V × 89 mA). Firmware should
  balance odd and even cells alternately, or the layout needs copper for heat spreading.
- Firmware: keep DCP = 0 so balancing pauses during conversions (otherwise C(n−1) reads about
  0.9 V off through the 10 Ω), and limit balancing to ≤ 80 mA per cell when the die is above
  85 °C (p. 75). Read the die temperature (ITMP) while balancing.
- The track widths (see "Track widths") were set with the old 114 mA figure, the safe side.
- **Lean since 2026-11-10: 120 Ω in 1206.** About 31 mA, 0.12 W per balance resistor (48 % of
  0.25 W), about 10 mW per 10 Ω resistor (0402 since try 4; corrected 2026-11-11), about 2.3 W with all 18 balancing
  (18 × 4.2 V × 31 mA). The numbers above this line are Guard's 33 Ω.

## isoSPI transformer

The datasheet (Table 74) rates HX1188FNL at **60 V working (estimate)**. Adjacent 18S
modules sit about 76 V apart, so that is not enough. Chosen part: **Pulse HM2113ZNL**
(one per port, T501 = port A, T601 = port B).

- From the Pulse datasheet (BM101.C, 11/22): 1:1, 150 µH min, 0.50 µH max leakage,
  choke fitted, 4300 Vrms / 60 s, **1000 VDC working**, −40 to +125 °C, AEC-Q200. Meets the
  ADI limits (> 60 µH primary, < 2.5 µH leakage).
- Pinout: chip (PHY) winding 1 – 2 (CT) – 3; line winding with CMC 6 – 5 (CT) – 4.
  The 10 nF chip-side CT cap goes on pin 2.
- JLC lists it as "SMD-12P". The Pulse drawing shows 6 pads, which is what the footprint
  uses.
- Footprint `slave-18s/footprints.pretty/Pulse_HM2113ZNL.kicad_mod` was drawn from the
  Pulse land pattern: 6 × 1.02 mm pads, 2.54 mm pitch, rows 12.40 mm inner / 16.18 mm outer.
  KiCad has no stock footprint for it.
- **Pad numbering checked 2026-11-05** against BM101.C p. 2 (mechanical drawing and HM2113ZNL
  schematic), with the drawing rendered next to the footprint. The drawing marks pin 1 with a
  dot and a chamfered body corner but prints no numbers. Turned 90° CW to match the
  footprint, the dot lands at pad 1 (top left, beside the silk dot). Numbering
  counter-clockwise from the dot gives 1-2-3 down the chip-side row and 4-5-6 up the line-side
  row, the same as the schematic page (1-2-3 on the PHY winding, 6-5-4 on the choked line
  winding). Pad size, pitch and row spans match the land pattern to 0.01 mm. Remaining
  assumption: counter-clockwise numbering is the industry convention, not printed on the
  drawing. Check one real part's marking against pad 1 at first assembly.

## Parts and JLC numbers

All picks were checked on jlcpcb.com/partdetail on 2026-11-05 (Basic/Extended flag and stock).

| Ref | Part | Footprint | LCSC | Type | Stock |
|---|---|---|---|---|---|
| U1 | ADBMS1818ASWAZ-RL | LQFP-64-1EP 10×10, EP5×5 | C5372802 | Extended | 12,496 |
| R100–R118 | 10 Ω 1 % 250 mW (1206W4F100JT5E) | 1206 | C17903 | Basic | 985,965 |
| C101–C118, C301, C302 | 100 nF 100 V X7R (filters, V+, collector) | 0805 | C28233 | Basic | 3.25 M |
| R201–R218 | 33 Ω 1 % 1 W | 2512 | C53728 | Extended | 49,062 |
| R301 | 100 Ω 1 % (V+) | 0603 | C22775 | Basic | 8.6 M |
| R302 | 100 Ω 1 % 150 V (collector). Lean: 1 kΩ 1 % 1 W, 2512, C54315, Extended (deviation 14) | 0805 | C17408 | Basic | 7.4 M |
| Q301 | FZT853TA, NPN 100 V 6 A 3 W | SOT-223 | C435890 | Extended | 264 |
| C303–C305 | 1 µF 50 V X5R (VREG, VREF1, VREF2) | 0603 | C15849 | Basic | 11.9 M |
| R401, R402 | 1 kΩ 1 % | 0603 | C21190 | Basic | 28 M |
| T501, T601 | Pulse HM2113ZNLT | Pulse_HM2113ZNL | C5730533 | Extended | 6,533 |
| R501, R502, R601, R602 | 51 Ω 1 % | 0603 | C23197 | Basic | 2.0 M |
| C501, C502, C601, C602 | 10 nF 50 V X7R | 0603 | C57112 | Basic | 5.3 M |
| R701–R704 | 100 kΩ 1 % (NTC pull-ups) | 0603 | C25803 | Basic | 16.6 M |
| C701–C704 | 100 nF 50 V X7R (GPIO) | 0603 | C14663 | Basic | 36.6 M |
| TH701 | Murata NCP18WF104F12RB, 100 k 1 % B 4250 K | 0603 | C71280 | Extended | 115 k |
| J1, J5 | JST B10B-PH-K-S(LF)(SN), 1×10 2 mm, 100 V 2 A (cell taps) | JST_PH_B10B-PH-K_1x10_P2.00mm_Vertical | C158038 | Extended | 25,205 |
| J2 | JST B6B-PH-K-S(LF)(SN), 1×6 (cell NTCs) | JST_PH_B6B-PH-K_1x06_P2.00mm_Vertical | C131342 | Extended | 32,477 |
| J3, J4 | JST BM02B-GHS-TBT(LF)(SN), GH 1×2 1.25 mm, SMD top entry (vertical), 50 V 1 A (isoSPI A / B) | JST_GH_BM02B-GHS-TBT_1x02-1MP_P1.25mm_Vertical | C161690 | Extended | **130 (LCSC), JLC pre-order ~13 days** |
| J6, J7 | JST B2B-PH-K-S(LF)(SN), PH 1×2, **DNP** (alternate to J3/J4) | JST_PH_B2B-PH-K_1x02_P2.00mm_Vertical | C131337 | Extended | not in the JLC BOM |
| F100–F120 | Littelfuse 0466.250NRHF, 250 mA 125 V DC, 50 A interrupt | Fuse_1206_3216Metric | C83557 | Extended | 50,048 |
| D101–D118 | BZT52C6V8 (CJ), 6.8 V zener 500 mW | D_SOD-123 | C2120 | Extended | 51,589 |
| D301 | SMAJ85A (Yangjie), 85 V TVS 400 W unidirectional | D_SMA | C698956 | Extended | 4,985 |
| TP1–TP10 | Keystone 5015 SMD test loop | TestPoint_Keystone_5015_Micro_Mini | C2906768 | Extended | 53,270 |
| TP11–TP14 | Bare 1.5 mm pad (no part, not in the BOM) | TestPoint_Pad_D1.5mm | — | — | — |
| H1–H4 | M3 hole, NPTH, no copper (not in the BOM) | MountingHole_3.2mm_M3 | — | — | — |

There are 12 Extended lines: U1, R201–R218, Q301, T501/T601, TH701, the two fitted JST PH
sizes (J1/J5, J2), the JST GH (J3/J4, since 2026-11-06), and (since 2026-11-06) the fuse, zener, TVS and test loop. Every capacitor is Basic.
The 2026-11-06 additions were checked on jlcpcb.com that day. The connectors are through-hole, so they need JLC's THT
assembly or hand soldering.

Why these values are safe at the voltages involved:

- The 0603 thick-film resistors are rated 75 V. Each one only sees cell-level or IR-drop
  voltages.
- The termination and CT caps (C5xx/C6xx) and the GPIO caps sit near V− (< 6 V), so
  50 V parts are fine there.

FZT853 lead order, checked 2026-11-05 against Diodes DS33175 Rev. 6-2: p. 1 "Top View
Pin-Out" shows the tab = C and the three leads E, C, B. Turned 180° to match the footprint,
the leads read B, C, E from pad 1, so KiCad `SOT-223-3_TabPin2` (pad 1 = B, pad 2 = C on the
middle lead and the tab, pad 3 = E) matches the symbol `Q_NPN_BCE` (1 = B, 2 = C, 3 = E). The
p. 6 outline gives the dimensions only, with no pin numbers.

Rejected NPN options: PBSS8110Z (0 stock), NSS1C201MZ4 (93 stock), FZT493TA (0 stock),
PZTA42 (300 V, but hFE min only 25–40; the datasheet asks for > 40 over temperature).

## Protection and test points (added 2026-11-06)

Figure 112 has no input protection, and the datasheet has no hot-plug section. It gives the
limits (Table 11, p. 11: 8 V between neighbouring C pins, 112.5 V V+ to V−) and the
internal clamps (Fig. 95, p. 72). The parts follow ADI AN-2093, the ADBMS1818 slave module
reference (read from a mirror copy; check it against analog.com before ordering).

| Item | Why | Value / part | First board? |
|---|---|---|---|
| F100–F118 | A cracked filter cap (up to 75.6 V to V−) or a slipped scope ground cannot pull pack current through the board (AN-2093 Fig. 11) | 250 mA 125 V DC 1206 | needed |
| F119, F120 | Separate supply branches, as AN-2093 does. With one fuse per tap, the chip's ≤ 35 mA × ~0.7 Ω (≈ 25 mV) would show as error on cells 1 and 18 | same fuse | needed |
| D101–D118 | J1/J5 pins mate in random order; the zener keeps each C pair under 8 V (AN-2093 Fig. 12 uses MMSZ4692T1G, C43431; BZT52C6V8 picked for stock) | 6.8 V SOD-123 | needed |
| D301 | Protects V+ (112.5 V) and the FZT853 (VCEO 100 V) from harness transients. After F119, so a shorted TVS opens the fuse | SMAJ85A: 85 V standoff, 94.4–104 V breakdown, 137 V clamp | needed |
| R100–R118 to 1206 | See deviation 10 | 10 Ω 250 mW | needed |
| TP1–TP10 | Probe loops on the low-voltage nets (AN-2093 TP1400–TP1409) | Keystone 5015 | needed |
| TP11–TP14 | Bare pads on VCOLL, C6_F, C12_F, C18_F: no exposed loop at 25–75 V | 1.5 mm pad | needed |
| H1–H4 | M3, no copper; positions set with the outline | 3.2 mm NPTH | needed |
| Reverse-polarity Schottky (AN-2093 D1400) | JST PH is keyed; only a miswired harness can reverse it | DFLS1100-7, C107674 | nice to have, not added |
| "Awake" LED on VREG (AN-2093 LD1400) | Adds about 0.1 W to Q301 | KT-0603R + 2.2 kΩ | nice to have, not added |
| isoSPI connector ESD | Not called for by the datasheet (Fig. 104, p. 81) or the HM2113ZNL sheet; termination, CT cap and choke are the protection | — | not needed |

Footprint pad numbers were checked against the KiCad 10 stock footprints and symbols:
D_SOD-123 and D_SMA pad 1 = cathode = `D_Zener` pin 1 (K); Fuse_1206 pads 1/2; both test-point
footprints pad 1 = `TestPoint` pin 1. D301 uses `D_Zener` because KiCad's `D_TVS` is
bidirectional.

Cost: four new Extended lines (about $3 setup each per order) and about $5.40 of parts per
board.

## Configuration and unused pins

Source: Fig. 2 and Table 14, plus the Watchdog and Discharge Timer section (Table 33).

| Pin | Net | Reason |
|---|---|---|
| 52 DTEN | **V−** | Disables the discharge timer. When the master or the isoSPI link is lost, the 2 s watchdog then resets the S control registers and turns every balance switch off. With DTEN = VREG the switches would keep running for up to 120 min with no host watching, which is a bad default while the 18 × ~110 mA thermal budget is still open. Revisit if unattended balancing is wanted; firmware can't override a pin tied to V−. |
| 53 SDI, 54 SDO | no-connect flag | Both are NC when ISOMD = VREG (Fig. 2 footnote: "IPA, IMA, NC, NC"). |
| 55 ISOMD | VREG | isoSPI mode (unchanged from Fig. 112). |
| 56 WDT | no-connect flag | Open-drain output; Table 14 allows it to be left disconnected. The slave has no local host to read it, and the master already sees a timeout through isoSPI. |
| 43–47 GPIO5–GPIO9 | **V−** (since 2026-11-06) | Spare. The plan was for firmware to turn on their internal pull-downs (GPIOx = 0, or DCC0 = 1 for GPIO9, Table 72). **Checked 2026-11-06: the ENNOID firmware writes GPIO1–9 = 1 (pull-down off) and DCC0 = 0** (`modPowerElectronicsCellMonitorsInit()`, see `docs/master-ennoid-xlite.md`), and a watchdog timeout would restore the same defaults anyway. With no-connect flags these five inputs would float, so they are **tied straight to V−** (deviation 13). No parts; a pull-down that ever turns on just pulls an already-low pin. Keep VESC Tool "NTC sensors per module" at 4 so GPIO5 (0 V) is never read as a thermistor. GPIO5 can't join GPIO4 as an I²C pair because GPIO4 carries the onboard NTC. |

## Connectors: JST PH for the cells, JST GH for isoSPI (decided 2026-11-05, isoSPI changed 2026-11-06)

The cell and NTC connectors are JST PH (2 mm pitch, top-entry through-hole, rated 100 V / 2 A). PH
stops at 16 circuits, so the 19 cell taps split across two 10-pin headers. C9 appears on
both, so each harness half carries its own reference.

| Ref | Pins | Pinout |
|---|---|---|
| J1 CELL_TAPS_C0-C9 | 10 | pin n = C(n−1): pin 1 = C0 (V−) … pin 10 = C9 |
| J5 CELL_TAPS_C9-C18 | 10 | pin n = C(n+8): pin 1 = C9 … pin 10 = C18 (top of stack) |
| J2 NTC_3x2 | 6 | 1–2 NTC1 (GPIO1, V−), 3–4 NTC2 (GPIO2, V−), 5–6 NTC3 (GPIO3, V−); odd pin = GPIO |
| J3 ISOSPI_A_IN, J4 ISOSPI_B_OUT | 2 | **JST GH vertical** (BM02B-GHS-TBT, since 2026-11-06). Pin 1 = +, pin 2 = − (transformer line side); twisted pair, wired pin-to-pin. Pad MP = metal hold-down tabs, no circuit |
| J6, J7 (DNP, Guard only since 2026-11-09) | 2 | JST PH: J6 = alternate to J3 (port A), J7 = alternate to J4 (port B), same nets (pin 1 = +). Named J6/J7 because KiCad treats a reference that does not end in a digit (J3B) as unannotated and blocks F8. Fit a PH header or solder two wires instead of using the GH |

Why these choices:

- **Voltage:** adjacent pins differ by one cell (≤ 4.2 V). The largest span across one header
  is 9 cells (37.8 V). The highest pin sits at 75.6 V to V−, under PH's 100 V rating. Keep
  J1 and J5 at least 1 mm apart on the PCB (IPC-2221 B2 asks 0.6 mm at 51–100 V).
- **Current:** balance current is about 110 mA per tap, well inside 2 A and PH's 24–32 AWG wire.
- **Shared C9:** it carries only C9's sense and balance current. If either plug is off,
  the other half still has its reference.
- **Rejected:** a single connector would mean Micro-Fit or XH 1×20 (bigger). GH is rated
  only 50 V, too little for the cell taps.
- **isoSPI is GH (2026-11-06):** the same series as the ENNOID master's isoSPI port, so its
  cable plugs in. Data from JST eGH.pdf: 1.0 A, 50 V AC/DC, 500 V AC withstand for 1 min,
  AWG 30–26. The 50 V only has to hold the isoSPI signal between its two pins; the up to 151 V
  between the line side and the module is held by the 2 mm barrier on the PCB.
- **Vertical GH, BM02B-GHS-TBT(LF)(SN) (changed 2026-11-06, was the side-entry SM02B-GHS-TB,
  C189893).** eGH.pdf p. 2 lists BM02B-GHS-TBT under "Top entry type". The plug comes in from
  above (7.3 mm mated height), so the connector can sit anywhere on the board instead of on the
  edge facing out, which frees the isoSPI ports to move next to U1 (Step 2 of the placement).
  JLC: C161690, Extended, checked on jlcpcb.com 2026-11-06. **Stock is thin:** LCSC 130, JLC
  shows 133 as a pre-order (about 13 days). Recheck before ordering; GH-compatible 1.25 mm
  vertical headers from HDGC, JUSHUO or BOOMELE are in stock at LCSC but their land patterns are
  not checked.
- **Footprint check (2026-11-06):** stock KiCad
  `Connector_JST:JST_GH_BM02B-GHS-TBT_1x02-1MP_P1.25mm_Vertical` against eGH.pdf p. 2 "Top entry
  type": signal pads 0.6 × 1.7 mm at 1.25 mm, tabs 1.0 × 2.8 mm with the inner edge 1.35 mm from
  the outer pin, 5.6 mm overall, 1.1 mm from signal pad to tab. All match. JST draws the pattern
  from the mounting side with No. 1 circuit on the right; KiCad's top view is that drawing turned
  180°, so pad 1 (left) is the same pin. Pad 1 = +, pad 2 = −, as before. KiCad ships the STEP model.
- **The GH tabs count as line side.** They sit about 1.1 mm from the signal pads, inside the 2 mm
  barrier, so the symbol has the MP pin (no-connect) and `make_rules.py` puts the resulting
  `unconnected-(J3-…)` net in port A's line side (port B the same), like T501's pad 5.
- **J6/J7** (Guard only since 2026-11-09) keep the PH option: DNP, same nets, also inside the barrier and the "only isoSPI
  inside the courtyard" rules.

Risks to watch:

- PH has only a friction lock, so it can back out under vibration. Use a dab of RTV or a
  retention clip if the motor shakes it loose.
- Hot-plug: if J5 mates before J1, C9–C18 float relative to V−. The plug order (J1 first)
  and the per-cell clamps are still open below.

## Schematic nets (wired 2026-11-05)

The sheet is wired with local net labels on pin ends: labels with the same name are one net.
There are no drawn wires.

| Net | What it is |
|---|---|
| V− | Chip ground, after F120: U1 59, 60, EP 65, DTEN (52), GPIO5–9 (43–47, since 2026-11-06), every filter/CT/GPIO cap, R402, J2 2/4/6, D301 anode, TP1/TP2. Since 2026-11-06 it is no longer the same net as CELL0 |
| TAP0 … TAP18 | Connector side of the fuses: J1.1–J1.10 = TAP0–TAP9, J5.1–J5.10 = TAP9–TAP18 (J1.10 and J5.1 both TAP9). TAP0 also feeds F120, TAP18 also feeds F119 |
| CELL0 … CELL18 | Fused cell nodes (F1nn pin 2): R1nn and R2nn harness side. CELL0 is the C0 sense tap only (R100) |
| VBAT_F | After F119: R301 (V+), R302 (Q301 collector), D301 cathode |
| C0_F … C18_F | Filtered node at U1 pin Cn (pin 38 − 2n): R1nn output, C1nn top (n ≥ 1) |
| S1 … S18 | R2nn output to U1 pin Sn (pin 39 − 2n) |
| VP_F | After R301, at U1 V+ (pin 1) and C301 |
| VCOLL | After R302, at the Q301 collector and C302 |
| DRIVE, VREG, VREF1, VREF2, IBIAS, ICMP | Named after the U1 pin. ISOMD (55) sits on VREG |
| IPA, IMA, IPB, IMB | U1 isoSPI pins, transformer PHY+/PHY− (pins 1/3) and the 51 Ω ends |
| ISOA_CM, ISOB_CM | Midpoint of the 2 × 51 Ω termination, 10 nF to V− (C501, C601) |
| ISOA_CT, ISOB_CT | Transformer chip-side centre tap (pin 2), 10 nF to V− (C502, C602) |
| ISOA_LP / ISOA_LN, ISOB_LP / ISOB_LN | Line side: LINE+ (pin 6) to J3.1/J4.1 and J6.1/J7.1, LINE− (pin 4) to J3.2/J4.2 and J6.2/J7.2. Same polarity on both ports |
| GPIO1 … GPIO4 | NTC inputs (U1 39–42) |
| Zeners | D1nn: cathode (pin 1) at Cn_F, anode (pin 2) at C(n−1)_F |
| Test points | TP1, TP2 V−; TP3 VREG; TP4 VREF1; TP5 VREF2; TP6 DRIVE; TP7–TP10 IPA, IMA, IPB, IMB; TP11 VCOLL; TP12–TP14 C6_F, C12_F, C18_F |

- **PWR_FLAGs:** one each on VP_F (the net at U1 V+), VREG and V−. Nothing else needs one:
  VREF1, VREF2 and DRIVE are chip outputs, and ERC accepts the C-pin inputs on nets of
  passives.
- **No-connect flags:** U1 53 (SDI), 54 (SDO), 56 (WDT), T501/T601 pin 5 (line-side centre
  tap) and J3/J4 pin MP (GH hold-down tabs). U1 43–47 (GPIO5–9) are on V− since 2026-11-06.
- **Check:** `check_slave18s.py` compares the kicad-cli netlist with the wiring table:
  372 of 372 pins (365 pin → net rows and 7 no-connects, block 6 = protection and test
  points), 0 mismatches, ERC 0/0 (2026-11-06, after the J3/J4 change). All 65 U1 pins are
  accounted for.
- **ERC pin map:** bidirectional vs power output is set to OK in the `.kicad_pro`, because
  GPIO5–9 (bidirectional) sit on V−, which carries a PWR_FLAG.
- **Sheet size:** 594 × 297 mm ("User"; A3 height, A2 width) since 2026-11-06, so the
  protection section sits beside the connectors.

## PCB (populated 2026-11-05, protection added 2026-11-06, connector row 2026-11-06)

- **Import:** KiCad 10 PCB Editor, Tools → Update PCB from Schematic (F8), default options.
  The MCP `sync_schematic_to_board` was tried first and rejected: its nets lacked the `/`
  prefix that KiCad gives local labels (`V-` instead of `/V-`), and it did not copy LCSC/MPN.
  That gave 289 parity errors, so the board was reverted and F8 used instead.
- **Check** (`python _tools/kicad_sch/check_pcb_parity.py`, 2026-11-06 after the second F8):
  148 of 148 footprints, each with the footprint named in the schematic; 366 numbered pads,
  0 net mismatches against the kicad-cli netlist (PWR_FLAGs have no footprint); 29 unnumbered
  pads (U1's thermal-via/paste pads and the four NPTH holes) carry no foreign net;
  `kicad-cli pcb drc --schematic-parity`: 0 parity items.
- **Rough grouping, not placement.** Parts were moved with `_tools/kicad_sch/pcb_move.py`
  (translation only, all at 0°) into blocks inside the 120 × 70 mm placeholder: J1/J5/J2/J3
  along the top edge, balance R201–R218 (3 × 6), cell filters R1xx/C1xx, thermistors under J2,
  U1 central, supply/VREF/bias (Q301, R301/R302, C301–C305, R401/R402) below U1, isoSPI A and B
  on the right (each transformer with its R/C), and J4 bottom right. J1's last pin and J5's
  first pin are 7 mm apart (≥ 1 mm required).
- **2026-11-06 additions, also rough grouping:** the R100–R118 rows were respaced to a 5 mm
  pitch for the 1206 footprints; C101–C118 and the zeners D101–D118 sit in the same columns
  under them (D1nn under C1nn); the fuses F100–F120 and D301 below that. TP1–TP10 run along
  the bottom edge, TP11–TP14 (HV bare pads) beside Q301, H1–H4 at the bottom-left,
  bottom-right and top-right corners and the middle of the right edge (the top-left corner
  is taken by J1). 0 courtyard overlaps (pcbnew courtyard boxes), all parts inside the outline.
- **Remaining DRC items** (2026-11-06, after the protection parts; expected before placement
  and routing, not fixed):
  - 0 errors: no clearance, creepage, hole-clearance, courtyard or shorting items;
  - 256 unconnected (no routing);
  - 61 silk_overlap and 80 silk_over_copper warnings (reference text on tight groups);
  - the 16 drill_out_of_range errors on U1's 0.2 mm thermal vias are gone since the net
    classes went in: the board minimum hole is now 0.2 mm (see "U1 thermal vias").
- **isoSPI connectors J3/J4 → GH, J6/J7 added (2026-11-06, third F8).** `check_pcb_parity.py`:
  150 of 150 footprints, 372 numbered pads, 0 mismatches, 0 parity items. A no-connect pin
  with two pads (the GH tabs) gets one net per pad, `unconnected-(J3-MountPin-PadMP)` and
  `…_1`; the parity check treats them as one net, and `make_rules.py` puts both in the line side.
- **Connector row and holes (2026-11-06, `pcb_move.py`).** Placement of these parts is
  deliberate; the rest is still rough grouping.

  | Ref | Position (mm) | Rotation | Why |
  |---|---|---|---|
  | J3 (GH, IN) | 16.0, 3.5 | 180° | Opening toward the top edge (checked in a 3D render from beyond the edge) |
  | J6 (PH alt. for J3) | 22.5, 5.0 | 0° | Next to J3 |
  | J1 | 31.0, 5.0 | 0° | |
  | J5 | 54.5, 5.0 | 0° | J1 pin 10 (TAP9) to J5 pin 1 (TAP9): 5.5 mm |
  | J2 | 79.0, 5.0 | 0° | |
  | J7 (PH alt. for J4) | 95.5, 5.0 | 0° | Next to J4 |
  | J4 (GH, OUT) | 104.0, 3.5 | 180° | Opening toward the top edge |
  | T501 / T601 | 20.3, 17.0 / 100.3, 17.0 | 90° | Line side (pads 4–6) up, toward the connector |
  | H1–H4 | (3.5, 66.5), (116.5, 66.5), (116.5, 3.5), (3.5, 3.5) | — | One per corner, 3.5 mm from both edges |

  - The row's courtyards span x = 12.5–107.5, so it is centred on the board centre (x = 60),
    with silk "IN" left of J3 and "OUT" right of J4. 0.5 mm between J3/J6 and J7/J4 courtyards,
    1.5 mm between the isoSPI pairs and the cell connectors, 0.5 mm between J1 and J5.
  - Transformer to connector: T501 line pads to J3 pads about 4.6 mm, T601 to J7 about 5.4 mm
    (datasheet limit 2 cm). R501/R502/C501/C502 and R601/R602/C601/C602 sit under the chip side.
  - To make room, R201–R218 (still 3 × 6) moved right to x = 29.5–74.5, and the NTC parts
    (R701–R704, C701–C704, TH701) moved to the right of U1, away from the balance resistors.
  - The right edge is empty (no XT30s on the slave).
  - Checks: 0 courtyard overlaps, all courtyards inside the outline, `check_pcb_parity.py` PASS,
    `make_rules.py --check` OK, DRC 0 errors (64 silk_overlap and 81 silk_over_copper warnings,
    265 unconnected).
  - **Not solved by this placement:** the datasheet also wants U1 close to each transformer
    (but ≥ 1–2 cm away) and no traces crossing the isoSPI lines. U1 stays at (75, 40), so the
    chip-side run is about 5 cm for port A and about 3 cm for port B, and port A's pair has to
    get past the J1/J5 tap traces. Deal with it at routing (or move U1 / put both ports at one
    end).
- **isoSPI ports moved next to U1 (2026-11-06, after J3/J4 became vertical GH).** This replaces the
  J3/J6, J7/J4 and T501/T601 rows of the table above.

  | Ref | Position (mm) | Rotation | Why |
  |---|---|---|---|
  | U1 | 75, 40 | 270° | Pins 61–64 (IMA, IPA, IMB, IPB) now face the empty right side |
  | T601 / J4 / J7 (port B, OUT) | (103, 24) / (115.5, 24) / (112.5, 13.5) | 0 / 270 / 0 | Upper: U1's port B pins sit above port A's, so the pairs don't cross |
  | T501 / J3 / J6 (port A, IN) | (103, 46) / (115.5, 46) / (112.5, 55.5) | 0 / 270 / 0 | Lower |
  | R5xx/C5xx, R6xx/C6xx | column at x = 90 | 0 | Between U1 and each transformer's chip side |
  | R701–R704, C701–C704, TH701 | y = 55–58, x = 86–104 | 0 | Moved below U1 to make room |

  - Distances: connector pads to transformer line pads about 3.4 mm (limit 2 cm); transformer chip
    pads to U1 pins 61–64 about 1.5 cm across, about 2 cm along the run (p. 86: close, but ≥ 1–2 cm).
  - Nothing sits between U1 and the transformers or between the transformers and connectors;
    each line pair runs straight with no crossing (LP above LN on both). Silk "OUT" at (115.5, 30),
    "IN" at (115.5, 40). The vertical GH and PH plugs enter from above.
  - Checks: 0 courtyard overlaps, all inside the outline, `check_pcb_parity.py` PASS,
    `make_rules.py --check` OK, DRC 0 errors (265 unconnected, silk warnings only).
  - U1's 3D model now points at KiCad's `LQFP-64-1EP_10x10mm_P0.5mm_EP6.5x6.5mm.step` (same body;
    the 5 × 5 EP model isn't shipped). T501/T601 and TP1–TP10 still have no 3D model.
  - Turning U1 moves its cell pins to the top and left; the cell filter/zener rows follow in the
    Step 3 placement pass.
- `pcb_move.py` now also turns pad and text angles when it changes a footprint's rotation
  (the file stores those angles including the footprint's own). Before the fix, a rotated
  footprint kept its pads at 0°.
- 3D: U1, T501 and T601 render without bodies because no 3D model is linked. This is cosmetic.

## Net classes and clearance rules (2026-11-06)

`python _tools/kicad_sch/make_rules.py` writes both: the net classes and board minimums into
`slave-18s/adbms1818-slave-18s.kicad_pro` (JSON read-modify-write, not pcbnew), and the
custom rules into `slave-18s/adbms1818-slave-18s.kicad_dru`, generated from the nets on the
board. `make_rules.py --check` passes only if both files are current **and** kicad-cli really
loads the rules. That second part matters: kicad-cli silently ignores the whole `.kicad_dru`
if one rule has a syntax error, so the check appends a canary rule to a temp copy and fails
unless it fires. Run it after any schematic change that adds or renames nets; it stops on a
net it can't place in the stack.

### Track widths

Heating doesn't set any width here. IPC-2221 (external, 10 °C rise) needs about 0.015 mm
for 114 mA and 0.003 mm for 35 mA on 1 oz copper. The widths come from U1's pin pitch (0.3 mm
pads at 0.5 mm, 0.2 mm gaps), JLC's 2 oz minimum (0.16 mm trace and space, capabilities
page, 2026-11-06), voltage drop, and robustness. 1 oz copper is 0.49 mΩ per square.

| Class | Nets | Track | Based on |
|---|---|---|---|
| HV_CELL | CELL1–18, C0_F–C18_F (and TAPn if added) | 0.25 mm | C-pin current is µA during measurement; C(n−1)_F carries cell n balancing return while its switch is on (clarified 2026-11-11). The harness-side CELLn also carries balance current. 0.25 mm runs between U1's pads at 0.5 mm pitch with 0.25 mm gaps |
| BALANCE | S1–S18 | 0.30 mm | ≤ 114 mA (sizing table below). Same as U1's pad width. 1.6 mΩ/mm on 1 oz, so 30 mm drops about 6 mV next to 3.8 V across 33 Ω |
| SUPPLY | VP_F, VCOLL, DRIVE, VREG | 0.40 mm | Q301 carries ≤ 35 mA peak (datasheet p. 71); DRIVE sources ≤ 1 mA. Wider for a short, low-inductance VREG decoupling loop. Neck down to 0.3 mm at U1 pins 1, 48 and 49. VCOLL's real job is the collector pour (placement checklist) |
| ISOSPI_PHY | IPA, IMA, IPB, IMB, ISO*_CM, ISO*_CT | 0.25 mm, pair 0.25 / 0.25 | ≤ 30 mA per pin (abs max, p. 11). Not impedance-controlled. Correction 2026-11-11: p. 86's <2 cm is transformer-to-connector, not chip-side trace length; crossings need review |
| ISOSPI_LINE | ISOA_LP/LN, ISOB_LP/LN | 0.25 mm, pair 0.25 / 0.25 | Same currents, cable side of the transformers |
| Default | V−, VREF1/2, IBIAS, ICMP, GPIO1–4 | 0.25 mm | V− carries chip supply/decoupling current (≤35 mA peak); cell 1's intended balancing return is C0_F–R100–CELL0 (corrected 2026-11-11) |

Lean is four copper layers since 2026-11-10 (`COPPER_LAYERS` in `make_rules.py`; `--check`
fails if the board's layer count differs). JLC multilayer limits (capabilities page,
2026-11-10: 0.09 mm trace/space at 1 oz, 0.15 mm at 2 oz, via hole 0.15 mm minimum, 0.2 mm
preferred) are no tighter than the 2-layer ones, so the board minimums are the same. No rule
names a layer, so the 0.6 mm stack clearance also holds on the inner layers and for zone
fills. IPC-2221B column B1 (internal) would allow 0.1 mm there for 31–100 V; not used.

Every class keeps 0.2 mm clearance and the 0.6/0.3 mm via. Board minimums (Board Setup >
Constraints): clearance 0.16 mm (JLC 2 oz), track 0.2 mm, hole 0.2 mm (JLC's preferred
minimum, see "U1 thermal vias"), via 0.5 mm.

### Clearance: IPC-2221B Table 6-1, column B2

B2 is external conductors, uncoated, sea level to 3050 m. IPC-2221B is paywalled; the rows
were checked against two reproductions of the table on 2026-11-06 (they agree).

| Table row | B2 | Where it applies here | Set to |
|---|---|---|---|
| 0–15 V | 0.10 mm | Neighbouring cells (≤ 4.2 V), neighbouring U1 pins | 0.2 mm, net class |
| 16–30 V | 0.10 mm | Nets up to 6 cells apart (25.2 V) | 0.2 mm, net class |
| 31–50 V, 51–100 V | 0.60 mm | Nets far apart in the stack, up to 75.6 V | 0.6 mm, `.kicad_dru` |
| 151–170 V | 1.25 mm | isoSPI line side vs this module, up to 151.2 V | 2.0 mm, `.kicad_dru` |

**Why a rules file:** KiCad uses the larger of the two net classes' clearances. It can't make
the clearance depend on how far apart two nets sit in the stack, and CELL3 vs CELL4 (4.2 V)
must stay at 0.2 mm or U1's 0.5 mm-pitch pins could never be routed. So the rules file gives
each net a level (its tap number: V− = 0, top of stack = 18; VREG, VREF, GPIO and the isoSPI
chip side are level 0) and a bank = level ÷ 3, rounded down:

| Bank | 0 | 1 | 2 | 3 | 4 | 5 | 6 |
|---|---|---|---|---|---|---|---|
| Taps | 0–2 + low-voltage nets | 3–5 | 6–8 | 9–11 | 12–14 | 15–17 | 18, VP_F; Guard VCOLL. Lean VCOLL additionally has the range rule below |

**Lean correction, 2026-11-11:** VCOLL's original bank-6 clearances are retained only as a
conservative floor. The additional range rule uses stack minus 0–35.35 V and requires
0.6 mm whenever either voltage-difference endpoint exceeds 30 V (arithmetic in the dated
review-fix entry above). It includes the upper taps previously missed by the bank model.

- Same or neighbouring bank: at most 6 levels apart, 6 × 4.2 = 25.2 V. That's the 16–30 V row,
  so the net class's 0.2 mm applies. The 6 includes an S pin, which sits up to one level
  below its tap while its switch is on.
- Two or more banks apart: up to 75.6 V, so 0.6 mm. Five rules, one per bank 0–4. Some pairs
  only 12.6–30 V apart also get 0.6 mm; that costs a little space and is on the safe side.
- Items with no net (copper text, later mounting holes) count as bank 0.

**isoSPI barrier: 2.0 mm clearance and 2.0 mm creepage** between each port's line side
(ISOA_LP/LN and T501's unconnected pad 5; the same for port B) and everything else,
including the other port's line side. The line side floats between this module and its
neighbour, so with two 18S slaves stacked (the Funwheel plan) it can sit up to 2 × 75.6 =
151.2 V from our nets: B2 row 151–170 V = 1.25 mm. 2.0 mm adds margin for motor
common-mode transients and ESD on the connector, and it costs nothing: the transformer's own
rows are 12.4 mm apart and the connector sits next to it. On a flat board without slots,
creepage equals the clearance; both constraints are in the rule so a later slot or cut-out
can't hide a short surface path.

**Mounting holes** (added 2026-11-06): `hole_clearance` 2.9 mm from the hole edge for
anything near H1–H4, which keeps copper 4.5 mm from the centre of a 3.2 mm hole, clear of an
M3 screw head or nylon washer (about 7 mm across). A copy with H4 dropped on U1 flagged it.

**Datasheet layout rules** (Rev. B p. 86, isoSPI layout guidelines), also in the rules file:
no copper pour inside T501/J3 or T601/J4 courtyards (item 2: no V− plane under the
transformer or the connector), and only that port's isoSPI tracks and vias inside them
(item 3: no traces across the isoSPI lines). Checked on a scratch copy: a V− zone under T501
is flagged, a keepout area there is not. The "nothing between transformer and connector"
part needs the placement, so it's on the checklist.

### U1 thermal vias: keep the ThermalVias footprint, board minimum hole 0.2 mm

- JLC capabilities page (2026-11-06): 2-layer minimum via hole 0.15 mm, preferred minimum
  0.2 mm. A 0.2 mm hole costs extra only when the via is under 0.45 mm across. U1's 16 vias
  are 0.2 mm holes in 0.5 mm pads (0.15 mm ring; JLC asks the via to be ≥ 0.1 mm larger than
  the hole), so they're standard price.
- The EP is U1's heat path: Table 12 gives θJA = 17 °C/W only with the EP soldered to the V−
  plane, and the 18 balance switches put their heat into the die. The vias carry it to the
  bottom-side V− copper. Dropping them to save nothing would be a bad trade.
- The vias stay open (JLC doesn't fill vias on 2-layer boards by default), so a little solder
  wicks into them. The stock footprint's 25 paste windows already allow for that. Check
  JLC's DFM report when ordering; it may flag the vias as PTH holes with a thin ring.

### DRC before and after (`kicad-cli pcb drc --severity-all`, no parts moved)

| Item | Before | After |
|---|---|---|
| drill_out_of_range (error) | 16 | 0 |
| clearance / creepage (error) | 0 | 0 |
| items_not_allowed (error) | 0 | 0 |
| silk_overlap (warning) | 22 | 22 |
| silk_over_copper (warning) | 15 | 15 |
| unconnected | 183 | 183 |
| schematic parity | 0 | 0 |

The rough grouping has no clearance problem yet: the closest pair two banks apart is 1.65 mm
(R207 CELL7 vs R213 CELL13). To prove the rules are live, a copy with the 0.6 mm raised to
3 mm flagged 266 pairs across all five stack rules.

## Placement checklist (for the Board Boxes placement pass)

Not done yet. Each item says what to check and where it comes from. Tick them in this file
when the placement is reviewed.

- [ ] **Q301 collector copper.** The SOT-223 tab (collector, VCOLL) needs a large copper
      area on both layers, stitched with vias: DS33175 gives RθJA 42 °C/W on 52 × 52 mm 2 oz
      (Tj ≈ 92 °C at 1.6 W) but 78 °C/W on 25 × 25 mm 1 oz (Tj ≈ 150 °C). Keep R302/C302
      next to the collector and C303 (VREG) next to the emitter and U1 pin 48. VCOLL sits at
      the top of the stack, so this copper is bank 6: 0.6 mm from banks 0–4.
      **Lean (try 3c, 2026-11-10):** zones reserved on all four layers with 43 vias, and R302
      takes about 0.5 W of the heat (deviation 14); far smaller than 25 × 25 mm, so measure.
- [ ] **isoSPI barrier.** 2.0 mm clearance and creepage from each line side (T501/T601 pins
      4–6, J3/J4 including the GH tabs, J6/J7, ISO*_LP/LN) to everything else; no copper pour
      and no foreign tracks under T501/J3/J6 or T601/J4/J7 (rules file). Datasheet p. 86:
      transformer within 2 cm of its connector (**done 2026-11-06**, about 3.4 mm), U1 close to
      but at least 1–2 cm from each transformer (**done 2026-11-06**: about 1.5–2 cm, ports on the right edge), no traces
      crossing the isoSPI lines, line-side pairs short and side by side. J3 and J6 have their
      pins in opposite order, so one line net needs a via inside the port's own area.
      **Lean (try 2, 2026-11-09):** no J6/J7, so no via is needed; barrier clean in DRC; connector
      next to its transformer. **Accepted on Lean (2026-11-10):** the transformers are about 3.7 mm
      from U1, not 1–2 cm; Racc's board runs that way without link errors (see "Variants", try 3).
- [x] **Connector row (2026-11-06).** J3 + J6 (IN), J1, J5, J2, J7 + J4 (OUT) along the top
      edge, centred on x = 60; GH openings face the edge; silk "IN" / "OUT". See "PCB".
- [x] **J1/J5 spacing (2026-11-06: 5.5 mm pin to pin, DRC clean).** J1's last pin (TAP9) and J5's first pin (TAP9) are the same net, but
      J1 pin 1 (TAP0) and J5 pin 10 (TAP18) are 75.6 V apart: keep the two headers' far ends
      ≥ 0.6 mm apart in copper (rules file) and leave room for the plugs and the harness. Print
      "PLUG J1 FIRST" on the silk only if the zeners are left off a build.
- [ ] **Tap fuses.** F100–F120 close to J1/J5, so as little copper as possible sits before
      the fuse. Keep them away from the hot R2xx: the 0466 fuse is rated to 90 °C and derates
      with temperature.
- [ ] **Zeners.** D1nn next to U1's C pins (on the Cn_F side of R1nn), short return to the
      neighbouring Cn−1_F; they only work if they are closer to the chip than the 10 Ω.
- [ ] **TVS D301** close to F119 and R301/R302, with a short return to V−.
- [ ] **U1 EP and the V− star point.** The EP (pin 65) is soldered to a V− area with the
      ThermalVias pattern (Table 12, the EP is V−). Run V− as a star from there: the filter
      caps C1xx, VREF/VREG caps, the isoSPI caps C5xx/C6xx and F120 return to it; don't
      route the balance current through it.
- [ ] **Balance-resistor heat.** R201–R218: 0.26 W each, about 6.7 W if all 18 balance at
      once (see "Balance resistor sizing"). Spread them, give them copper, keep them away
      from U1 (die limit 80 mA above 85 °C), TH701 (it would read board heat, not cell heat),
      the fuses and the zeners.
- [ ] **Test-point reachability.** Guard: TP1–TP10 loops on the edge, on the top side, with room
      for a hook clip (≥ 5 mm between loops), labels on the silk. Lean has no test points since
      2026-11-10 (try 3).
- [x] **Mounting holes (2026-11-06).** Four, one per corner, 3.5 mm from each edge; the 4.5 mm
      keep-out rule passes. Recheck when the final outline is drawn, and keep the screws away
      from HV copper and the isoSPI barrier during routing. Lean: M2 since 2026-11-10, keep-out
      rule not yet resized.
- [x] **No XT30s.** The right edge is left empty (the master carries the power path).

## Open items

- [ ] **Lean regulator thermal acceptance (review, 2026-11-11).** At 75.6 V and 22 mA:
      R302 ~0.48 W, Q301 ~1.07 W. At 35 mA: R302 ~1.23 W, Q301 ~1.25 W (nominal
      resistance, 5 V emitter). Obtain the actual master's worst-case duty cycle and
      resistor derating/pulse allowance, or measurements on the first boards. A "peak"
      label does not establish a safe repetitive load. No thermal redesign in this pass.
- [ ] **Lean U1 exposed-pad assembly (review, 2026-11-11).** Its 16 open 0.2 mm plated
      holes need the assembler's acceptance of paste volume/voiding, or an explicit
      paste/via-fill decision. The old two-layer/open-via note is not Lean assembly approval.
- [x] **Lean isoSPI foreign crossings (review, 2026-11-11; closed 2026-11-14).** Rerouted,
      not shielded (Option 1, see "Variants"): `isospi_shield_check.py` finds 0 crossings.
      Bench noise testing remains necessary.
- [ ] **Reviewer's OK for port B's termination at the chip end (2026-11-14).** Option 1 moved
      R601/R602/C601 next to U1 pins 63/64; the datasheet does not rule on it.
- [ ] **Floorplan choice (2026-11-14).** Option 1 (70 × 32, routed, ports side by side) or the
      split-ends layout with U1 turned 90° clockwise (70 × 34.2 on a scratch copy, a port at each
      end, 22–30 mm chip-side pairs). See "Variants", Option 2 feasibility. Silkscreen cleanup and
      the manufacturing dry run wait for this choice.

- [x] Build the ADBMS1818 symbol from the datasheet pin table (64-LQFP_EP). Done; netlist
      checked.
- [x] Confirm internal switch on-resistance (4 Ω typ, 10 Ω max) and the thermal limit
      (~150 °C shutdown).
- [x] Confirm VREG current (15 mA measure + 4–6.5 mA isoSPI, peaks near 35 mA).
- [x] Choose the NPN: FZT853TA. **Stock is thin (264).** Recheck before ordering.
      Collector copper must carry about 1.6 W.
- [x] Choose the isoSPI transformer: HM2113ZNL.
- [ ] Maximum balance current per S switch and the die thermal budget at 18 × ~89 mA
      (corrected 2026-11-06; 80 mA limit above 85 °C die, p. 75). If
      it's too hot, add external balance MOSFETs (datasheet Figure 99).
- [x] Collector cap C302: 100 nF 100 V (Basic C28233), per the datasheet text.
- [x] HM2113ZNL footprint: checked against Pulse BM101.C p. 2. Pin-1 dot at pad 1,
      numbered counter-clockwise, 1-2-3 on the chip side. No change needed. See "isoSPI
      transformer".
- [x] FZT853 numbering: Diodes DS33175 p. 1 pin-out (tab C; E-C-B) matches
      SOT-223-3_TabPin2 (1 = B, 2 = C/tab, 3 = E). No change needed. See "Parts".
- [x] Q301 package: **keep FZT853 (SOT-223). Decision by Racc, 2026-11-06.** He first
      read it as a 1 W part, then confirmed the 3 W rating is enough. Condition from
      DS33175: RθJA 42 °C/W on 52 × 52 mm 2 oz collector copper (Tj ≈ 92 °C at 1.6 W,
      25 °C air; ≈ 107 °C at 40 °C air), but 78 °C/W on 25 × 25 mm 1 oz (Tj ≈ 150 °C, the
      limit). So placement must give the collector tab a large copper area (both layers,
      stitched). The datasheet (Simple Linear Regulator, p. 71) sets no power figure, only
      Beta > 40 over temperature at up to 35 mA, collector ≥ 6 V above V−, 100 Ω/100 nF on
      the collector, and "attention" to heating. DPAK fallback if the copper won't fit:
      ZXTN4004K (Diodes DS35458: 150 V, hFE ≥ 60 at 85 mA, 33 °C/W on 50 × 50 mm 2 oz,
      JLC C460146/C157603, Extended), not yet fully checked.
- [x] DTEN (pin 52) to V− (discharge timer off). See "Configuration and unused pins".
- [x] WDT (pin 56) and SDI/SDO (53/54): no-connect flags.
- [x] GPIO5–GPIO9: the ENNOID firmware leaves the pull-downs off, so they are tied to V−
      (2026-11-06). The ERC pin map treats bidirectional vs power output as OK for this.
- [x] Wire the schematic. Done 2026-11-05: ERC 0 errors, 0 warnings, with PWR_FLAGs on
      VP_F, VREG and V−. See "Schematic nets".
- [x] Hot-plug protection for the plug-and-play harness. Done 2026-11-06: tap fuses,
      per-pair zener clamps and a TVS, so plug order no longer matters for the C pins. See
      "Protection and test points".
- [x] Test points and mounting holes. Done 2026-11-06 (hole positions open).
- [x] Connectors: JST PH. Guard: J1 + J5 cell taps (10 + 10, C9 shared). Lean since
      2026-11-13: J1 10 pins (C0–C9) + J5 9 pins (C10–C18), C9 on one wire (see "Lean cell
      plugs"). J2 NTCs; J3/J4 isoSPI (JST GH on both since 2026-11-06).
- [ ] Harness: match J1/J5/J2 pin order to the Funwheel pack's tap and NTC wiring.
- [ ] ENNOID master fit (`docs/master-ennoid-xlite.md`): J3/J4 are JST GH 2P now (done
      2026-11-06); isoSPI polarity still to confirm. Firmware: the public source's LTC6813-1 driver sends only commands that
      match ADBMS1818 Table 52 (checked 2026-11-06); pick LTC6813-1 in VESC Tool. Remaining
      proof: bench test with one slave.
- [ ] Board outline (the current 120 × 70 mm rectangle is a placeholder).
- [x] Import the schematic into the PCB. Done 2026-11-05 with F8: 90 footprints, parity 0.
      See "PCB".
- [x] Net classes and HV clearance rules. Done 2026-11-06 with `make_rules.py`. See "Net
      classes and clearance rules".
- [ ] Final placement (Board Boxes), then routing.
- [x] U1 thermal vias: keep them, board minimum hole 0.2 mm (JLC preferred minimum, standard
      price at 0.5 mm diameter). See "U1 thermal vias".
- [ ] EVAL-ADBMS1818Z schematic not reviewed (not supplied). Cross-check pins and the
      transformer against it if it turns up.

## Lean cell plugs: PH 10 + PH 9, CELL9 on one wire (decided 2026-11-13)

Done on `reference-ideas`: schematic `a164eb4`, **PCB placed and routed `7cea3ca`** (F8 in the
Lean project, then `lean_place.py` and `lean_route.py`; checker 0 problems, parity pass, rules
OK, zone-filled DRC with 0 unconnected items and silkscreen warnings only).

Owner decisions (2026-11-13):

- **Keep JST PH for the cell plugs.** A 1.25 mm GH header would reject a wrong 9-pin
  housing better, but PH stays by choice. The two plugs having different contact counts
  is accepted as identification only. A 9-pin housing can still be forced into the 10-pin
  header, and that risk is accepted rather than designed out.
- **CELL9 is a single wire, on J1 pin 10.** Lean serves one monolithic 18S pack, not two
  split or removable halves, so the harness never brings C9 in twice.
- **isoSPI crossings get rerouted, not shielded.** Datasheet p. 86 bans any V− plane under
  or between the transformer and plug, and any trace crossing an isoSPI line unless an
  inner ground plane separates them. A reviewer advised against ground or foreign copper
  under isoSPI. Removing the crossings meets both without adding copper there. (Done
  2026-11-14, `d139588`: 0 crossings.)
- **The reroute is "Option 1" (owner, 2026-11-13):** keep the floorplan (U1, cell plugs,
  resistor rows, NTC block, transformers, isoSPI plugs, holes and outline stay) and move a few
  small parts. Port B's split termination and its midpoint cap go to the chip end by pins
  63/64, its centre-tap cap goes beside T601, port A runs through the strip that frees under
  T601, and CELL18 reaches R302 under U1 on an inner layer. A port at each end of the board
  ("Option 2") is studied afterwards, on its own branch, as a feasibility question only.
Lean's generator changes J5 to a nine-contact JST PH header while J1 keeps ten.
J1 pins 1-10 carry CELL0-CELL9; J5 pins 1-9 carry CELL10-CELL18. Guard keeps its
existing two ten-contact headers. This is a Lean/Guard deviation; Figure 112 does
not specify harness connector allocation.

Reason: identical headers accept the wrong harness half, and the nineteen distinct
taps do not require twenty contacts. Removing J5's duplicate CELL9 contact removes
one harness contact/crimp and the parallel CELL9 board branch. Different contact
counts improve identification, but do not reject partial, forced or offset mating
(accepted above). Both harness halves belong to one contiguous 18S stack. Hot-plug
tolerance and connection sequence remain unqualified.

Part: B9B-PH-K-S(LF)(SN), local catalog C157968 (stock is a cached observation,
not an ordering guarantee); mating housing PHR-9. JST's official
[ePH drawing](https://www.jst-mfg.com/product/pdf/eng/ePH.pdf), pp. 1 and 3,
establishes pin-1 orientation, 2 mm pitch, 100 V rating and the header body width
19.9 mm versus 21.9 mm for ten contacts. Stock KiCad footprint
`Connector_JST:JST_PH_B9B-PH-K_1x09_P2.00mm_Vertical` uses the corresponding
mounting-side pin order, with its drawing rotated 180 degrees from JST's layout
view. The nine pads span 16 mm. The 0.75 mm footprint holes exceed the drawing's
0.7 mm reference holes; JST explicitly allows larger holes for glass-fibre boards.

Scratch placement keeps C10-C18 at their existing physical positions: J5 pin 1
moves 2 mm right into the former pin-2 location. The gap between header courtyards
grows from 0.51 mm to 2.51 mm; no outline shrink is claimed. The board remains
70 x 32 mm, four layers, with all isoSPI split termination and CT capacitors.
Scratch routing had zero copper errors and zero unconnected items after zone fill, and
the real board matches it since `7cea3ca` (153 silkscreen warnings, as before). Do not
use the old ten-contact J5 harness with the new nine-contact pin numbering.
