Focerqc/testing-BMS-designs/docs/slave-18s-lean-layout-plan.md

# 18S Lean: PCB layout plan

Status (2026-11-10): **placed by script, not routed.** Lean is at shrink try 2: 70 × 50 mm,
91 footprints, every part on the board, 0 courtyard overlaps, no tracks. The placement comes
from `_tools/kicad_sch/lean_place.py`, not from the hand steps below. Read this file in two
layers: the "Changed" notes here and "Where try 2 stands" are current; steps 0–9 were written
on 2026-11-06 for the 120 × 70 board and still say what each part of the layout has to
achieve, but their coordinates and part counts are from that board. Routing (step 8) and the
checks (step 9) apply as written.

**Changed 2026-11-07:** the 18 channels go in **one straight, staggered row** under J1/J5
(steps 3–4), not the earlier L around U1's corner. The L only came from fitting 4.5 mm pitch into
the placeholder outline; the row at 4.2 mm fits, reads like every other BMS, and copies the
half-step stagger of Racc's 12S board.

**Changed 2026-11-08: shrink trial.** Lean is being shrunk toward a ~70 mm wide slave (the XR
slot), starting at 70 × 50 mm, with 2010 balance resistors (pitch 3.3 mm) and Bourns SM91502AL
transformers (design basis, "Variants"). The 120 × 70 version of this plan is on branch
`savepoint/lean-120x70`. Placement is now generated by `_tools/kicad_sch/lean_place.py`: change a
knob at the top (outline, pitch, row shift, U1 x, isoSPI port spots), run it with KiCad closed, look
in the dashboard. The steps below still describe what each part of the layout has to achieve; their
120 × 70 coordinates are out of date.

**Changed 2026-11-09: try 2.** Lean has no J6/J7 any more (`make_lean.py` drops them), so it is
**91 footprints**. `lean_place.py` now puts both isoSPI ports on the board as strips right of U1
(R/C column, transformer, GH plug; port B above port A), with nothing parked. Where the steps
below mention J6/J7, 93 footprints or port A being parked, that is the older state.

**Changed 2026-11-10:** the dashboard's Layout practice card is gone (see "Board Boxes and the
variants"). What it measured on try 2 is kept under "Where try 2 stands".

Read with: `AGENTS.md`, `docs/slave-18s-design-basis.md` ("Variants", "Balance resistor
sizing", "Net classes and clearance rules", "Placement checklist").

## What the Lean board is (facts this plan relies on)

- **91 footprints** (since 2026-11-09; 93 before J6/J7 were dropped): the circuit parts plus the
  net tie NT1 (step 5). 77 are on the front; the 14 test pads TP1–TP14 are on the back.
- **One cell channel is just two resistors:** R1nn (10 Ω 1206, CELLn → Cn_F → U1 C pin) and
  R2nn (balance, CELLn → Sn → U1 S pin). There are no C1xx caps, zeners or fuses. Tap traces run
  straight from J1/J5 to the channel.
- **C0 is special:** J1.1 and R100 pin 1 are on **CELL0**, a net of their own. CELL0 meets V−
  (the chip ground: EP, cap returns, the pour) at exactly one point, the **net tie NT1** right
  next to J1.1. Because they are two nets, KiCad's DRC flags any other copper joining them as a
  short. So the rule "C0 sense on its own trace" is enforced by DRC while you route (step 5).
  (Until 2026-11-06, `make_lean.py` merged CELL0 into V−, and DRC couldn't see the difference.)
- *(120 × 70 board; on try 2 U1's centre is at x = 42, courtyard y 30.7–44.2, same rotation,
  so the pin order below still holds but the coordinates don't.)*
  **U1 stays where it is** (75, 40), rotated 270°. The isoSPI ports on the right were placed on
  purpose (design basis, "isoSPI ports moved next to U1"). With that rotation U1's cell pins sit
  like this (pad centres, mm):

  | U1 side | Pins | Nets, in pin order | Span |
  |---|---|---|---|
  | Top (y = 34.3) | 1 to 16, right to left | V+, C18, S18, C17 … S12, C11 | x 78.8 → 71.3 |
  | Left (x = 69.3) | 17 to 32, top to bottom | S11, C10, S10 … S4, C3 | y 36.3 → 43.8 |
  | Bottom (y = 45.7) | 33 to 38, left to right | S3, C2, S2, C1, S1, C0 | x 71.3 → 73.8 |
  | Bottom, then right | 39 to 64 | GPIO1–9, VREG, DRIVE … V−, isoSPI | |

- **The connector row is fixed** (top edge): J1 (C0 at x = 31 … C9 at x = 49), J5 (C9 at 54.5 …
  C18 at 72.5), J2 at 79. Cell numbers rise left to right.

**The key insight for placement:** start at C0 on U1's bottom side and walk **clockwise**: S1, C1
… S3 along the bottom, C3 … S11 up the left side, C11 … C18 along the top to V+ at the top-right
corner. (Pin numbers count the other way, anticlockwise from pin 1.) That is the **same order** as
the connector pins left to right. So if the 18 channels sit in **one straight row** under J1/J5,
in order, with their harness ends up, every tap trace nests inside the next and **no ratsnest
line has to cross another**. Ch 11–18 drop onto U1's top pins; ch 0–10 run as a bus down U1's
left side to its left and bottom pins, with C0 outermost.

```
 y=0 ┌──────────────────────────────────────────────────────────────────────┐
     │ H4     [J1  C0 ……… C9][J5  C9 ……… C18]  [J2 NTC]                 H3  │ connectors (fixed)
     │   taps fan out from the plugs: C0 outermost, C18 innermost           │
 ~13 │   R2 row (balance, hot), harness end UP:  ch 1 ………………………… ch 18      │
     │   R1 row (10 Ω), half a pitch right:     ch 0 ………………………… ch 18       │
     │                          ch 11–18 drop onto U1's top pins  T601 J4   │ port B, OUT
     │   ch 0–10: bus down U1's left side ─┐  ┌───────────┐                 │
     │                                     └> │ U1 (75,40)│        T501 J3  │ port A, IN
     │   (ch 0–2 and S3 wrap to the bottom)   └───────────┘                 │
     │   bottom: GPIO caps, VREG/VREF caps, R401/R402                       │
     │             Q301 + VCOLL copper (clear of the ch 0–3 bus)   NTC parts│
 70  │ H1                   TP1…TP10 along the bottom edge               H2 │
     └──────────────────────────────────────────────────────────────────────┘
```

### Where try 2 stands (70 × 50, 2026-11-09)

```
 y=0 ┌────────────────────────────────────────────────────┐ x=70
     │ H4    [J1 C0 … C9][J5 C9 … C18]                 H3 │ plugs, pin row at y = 5
     │                                              [J2]  │ J2 stands on the right edge
  13 │ R2 row (2010, hot):  ch 1 ……………………… ch 18    [J2]  │ row x 2.1–63.9, pitch 3.3
  25 │ R1 row (1206), half a pitch right: ch 0 … ch 18    │
     │                               R/C [T601] [J4]      │ port B (OUT)
  31 │  (free: the test loops        ┌────┐                │
     │   left the front)             │ U1 │ R/C [T501] [J3]│ port A (IN)
  44 │                               └────┘                │
     │ H1  Q301 R30x C30x     C30x R40x R70x C70x TH701 H2│ supply and NTC parts, packed
  50 └────────────────────────────────────────────────────┘
 back: TP1–TP10 in two rows under the free band (bottom left), TP11–TP14 right of Q301
```

Measured on this try (2026-11-10, pad centre to the U1 pin on the same net):

- **Fine:** ch 14 stagger, the 18-channel row (in order, 3.3 mm pitch, on the board), both
  isoSPI ports on the board.
- **Not fine: supply parts at their pins.** `lean_place.py` packs them in rows along the bottom
  edge. C303 (VREG) is 10.0 mm from pin 48, C304 (VREF1) 9.8 mm, C305 (VREF2) 6.9 mm; these
  want about 3 mm. R401/R402 are 8.4/8.9 mm from IBIAS/ICMP, R301/C301 (V+ filter) 28 mm from
  pin 1, and Q301 37 mm from the VREG pin.
- **Not fine: height.** 50 mm, 15 over the 35 mm goal. The stack-up (plugs 5.6, tap room 5, two
  resistor rows 11.4, fan-in 6, U1 13.5) is about 41.5 mm before the supply parts, so 35 mm
  needs the cell plugs off the top edge, not tighter knobs.
- **Not routable as placed: ch 14–18 to U1 (found 2026-11-10).** Port B's parts (R601 first)
  start at y = 25.99 from x = 49.3 to the right edge; the R1 row's chip pads end at y = 24.39.
  Nine traces start right of x = 49.3 (C14_F–C18_F, S15–S18) and have to pass left through
  that 1.6 mm slot to U1's top pins. They need about 4.5 mm (5 × 0.25 + 4 × 0.30 + 0.2 gaps),
  and the 0.6 mm stack rule to port B's chip-side pads leaves room for two. `lean_place.py`
  only checks courtyards, so it reports this try as clean. The next try needs about 5.5 mm
  between the R1 row and port B (`ISO_Y`), which pushes port A down toward H2.
- **No room at U1's right side.** The isoSPI R/C columns sit 0.9 mm from U1's pins 49–64, where
  C304/C305 (pins 51/50) and R401/R402 (pins 57/58) also have to go. Left of U1, about
  35 × 17 mm of the front is free (it carries the ch 0–10 bus, about 10 mm wide).
- **Also open:** each transformer is about 3.7 mm from U1 (datasheet: 1–2 cm); Q301's collector
  copper has no reserved area; nothing is routed (0 tracks, 0 zones, 167 unconnected).
- **Left over from the 120 × 70 board:** the silk texts "IN" (115.5, 40), "OUT" (115.5, 30)
  and the board name (30.3, 62.1) are outside the 70 × 50 outline, so the board carries no
  silk text of its own yet. `lean_place.py` doesn't move them.

The floorplan above the try 2 one is the 120 × 70 starting point, not a rule. You'll move it around in step 3. What has to stay
true: the channels follow the pin order, and the row's chip-end pads alternate S and C the same
way U1's pins do (the half-step stagger in step 3).

## Step 0: prerequisites

### 0a. Tooling (done 2026-11-06, not yet committed)

| Script | Today | Change |
|---|---|---|
| `make_lean.py` | Merges CELL0 into V− | Keeps CELL0 and puts a net tie **NT1** (CELL0 to V−) where F120 was, so DRC can enforce the C0 sense (step 5). This is a schematic change: its own commit, and the Lean wiring table in `check_slave18s.py` follows |
| `check_pcb_parity.py` | Works on Lean already with `--sch …lean.kicad_sch --pcb …lean.kicad_pcb` | Add `--variant guard\|lean` (same as `check_slave18s.py`). Add one layout check: **every footprint on F.Cu** (the single-sided rule) |
| `make_rules.py` | Hard-wired to Guard's `.kicad_pro`/`.kicad_pcb`/`.kicad_dru` | Add `--variant`. The net classifier already handles Lean's nets (no TAPn or VBAT_F; CELL0 lands in bank 0, CELL18 in bank 6). Lean's `.kicad_dru` is currently a stale copy of Guard's, so regenerate it after F8 |
| `pcb_move.py` | Has `--pcb` | Add `--variant` as a shortcut |
| `export_site.py`, dashboard | Already find every `.kicad_pcb` | No change needed (see "Board Boxes and the variants" below) |

### 0b. Clean starting point (done 2026-11-06, commit `PCB (Lean): F8 drops …`)

**Lesson from doing it:** F8's option **"Delete footprints with no symbols"** is off by
default. Without it, F8 updates nets and adds new parts but leaves removed parts on the board.
Tick it whenever the schematic lost parts. (This time the 58 leftovers were removed from the
file afterwards, and the parity check proved the result: 93/93.)

1. Commit the step 0a work first, as three commits (tools, Lean schematic, docs), so the Lean
   PCB commits contain only the PCB.
2. Open `slave-18s-lean/adbms1818-slave-18s-lean.kicad_pro` → PCB Editor → **F8**, default
   options. The dialog lists 58 deletions (F100–F120, D101–D118, D301, C101–C118), one
   addition (NT1) and the net renames. Press **Update PCB** → Close → click once to drop NT1
   → **Ctrl+S** → close KiCad.
3. Tell me it's closed. I run `check_pcb_parity.py --variant lean` (expect 93 footprints,
   0 mismatches, 0 parity) and `make_rules.py --variant lean`, then `--check`.
4. **Commit:** `PCB (Lean): F8 drops the protection parts`.

**Why the order matters:** `make_rules.py` builds the rules from the nets on the board, so it has
to run after F8. Otherwise it would write rules for nets Lean doesn't have.

## Step 1: fixed parts (connectors, holes, isoSPI, U1)

These keep their Guard positions. The job here is to **lock** them, not to move them.

- In KiCad: select J1, J5, J2, J3, J4, J6, J7, T501, T601, U1, H1–H4 → right-click → **Lock**
  (or press L). Locked parts can't be dragged by accident while you work around them.
- **What to look for:** nothing new. Open the 3D viewer (Alt+3) once to get your bearings:
  where each connector's plug goes and which way U1 pin 1 faces (the dot is top right).
- **Check:** DRC (Inspect → Design Rules Checker, "Refill all zones" ticked). Expect 0 errors,
  plus unconnected items and silk warnings, which are fine at this stage.

## Step 2: clear the deck

F8 leaves the old Guard grouping with gaps where the 58 parts were. Rather than nudging that,
start clean: **I generate a `pcb_move.py` JSON that parks every unlocked part in a staging grid
below the board** (y ≈ 80–120), sorted by group (R1xx, R2xx, supply, isoSPI passives, NTC, TPs).
You then pull parts onto the board one group at a time. With nothing else on the board, the
ratsnest of the group you're working on is easy to read.

- **Check:** `check_pcb_parity.py --variant lean` (moves never change nets, but it's cheap
  and confirms the file loads).
- **Done 2026-11-06.** Staging rows start at y = 78 mm, top to bottom: balance R201–R218
  (2 × 9), cell series R100–R118 (2 rows), supply (Q301 first), isoSPI A then B, NTC pairs
  + TH701, TP1–TP10 then TP11–TP14. 0 courtyard overlaps, parity PASS, DRC 0 errors.
  **In KiCad:** hover a part and press **M** to move it. To bring a whole row, drag a
  selection box over it on empty board (left to right selects only parts fully inside),
  then press **M**.

## Step 3: one cell channel, done properly

Pick **channel 14** (under J5, right of the row's middle).

1. Drag R214 and R114 onto the board, a little left of J5 pin 6 (C14, x ≈ 64.5). With 4.2 mm
   pitch R214 lands at x ≈ 59.4 and R114 at x ≈ 61.5.
2. **Orientation:** both resistors vertical (rotate 90°), harness pad (CELL14) **up** toward
   the connector, chip pad **down** toward U1.
3. **Position:** R214 (balance, hot) in the **outer row**, its body about 5 mm under the connector
   courtyards (y ≈ 13–19). R114 (10 Ω) in the **inner row** about 1.6 mm below it (y ≈ 21–24, so
   the courtyards just clear), and **half a pitch to the right** of R214.
4. **Why half a pitch:** read left to right, U1's top pins go … S13, C13, S14, C14, S15 … With R114
   offset to the right, the row's chip-end pads go S14 (R214), C14 (R114), S15 (R215) … in the
   same order. The tap reaches R114 through the gap right of R214, and S14 leaves R214 straight
   down through the gap left of R114: **one trace per gap**. Racc's 12S board staggers its two
   resistor columns the same way. Get this right once and the 17 copies inherit it.
5. **Pitch:** the channel's width along the row sets the pitch for all 18. Design it around the
   **2512 envelope** (6.3 × 3.2 mm body, pads 3.35 mm wide, courtyard 7.7 × 3.9 mm), even if you
   later fit a 1210 or 2010. One 0.25 mm trace between neighbouring 2512 pads with 0.2 mm each
   side needs at least **4.0 mm**. **4.2 mm** fits this outline: ch 0 to ch 18 is then 77 mm
   (x ≈ 1.9–79), with R118 over the C18 pin and about 10 mm left above U1 for the fan-in.
   4.3 mm would run off the left edge. Write the pitch down: step 4 uses it.
6. **Route this one channel** (front layer): tap trace J5.6 → R214 harness pad → down through
   the gap to R114's harness pad (both CELL14, HV_CELL 0.25 mm). Then R114 → C14_F pin (0.25 mm)
   and R214 → S14 (BALANCE 0.30 mm, neck to 0.3 at the pin, which is already the pad width).
   Ratsnest for this channel: zero lines left.

**Why this shape:**
- One straight row reads like every BMS you've seen, and every channel is the same cell with
  the same orientation.
- Balance row outer: 0.22–0.26 W each at 33–47 Ω. The heat should spread into the board, not
  into U1 (balancing is derated to 80 mA once the die is above 85 °C).
- Racc's 12S board does the opposite: 10 Ω on the plug side, balance resistor next to the chip.
  At his 120 Ω (0.12 W) the heat hardly matters, and on Lean (no C-pin caps) the R1 position
  doesn't change the circuit. (Until 2026-11-07
  this plan called "R1 next to the C pin" Racc's method; his board shows otherwise.)

**What to look for:** press **`** (backtick, highlight net) on CELL14 and S14 in turn: each should
be one clean path. Check the courtyards in 3D: the 2512 is visibly the big part.

**Check:** DRC. Expect no clearance errors around channel 14.

## Step 4: repeat the channel 18 times

Three ways to do it:

| Method | How | Verdict |
|---|---|---|
| Manual | Move each part with **M**, or use Edit → Move Exactly (Shift+M) with the offset typed in | Fine for 3 parts, error-prone for 36, and has to be redone when the package changes |
| KiCad's own tools | "Create array" makes **new** copies (unannotated, no nets): wrong for parts that already exist. Multichannel / "Repeat layout" needs one hierarchical sheet per channel, and our schematic is flat | Not usable here |
| **Script → `pcb_move.py` JSON** | I read the position and rotation of R114/R214 from the board, then generate positions for all 37 resistors: the R2 row ch 18…1 and the R1 row ch 18…0 at your pitch along x, keeping the half-pitch offset | **Recommended** |

**Why the script:** it is exact and repeatable. It also lives in the repo as one function of
(pitch, row y, row x), so when the balance package or pitch changes in the shrink pass you
change one number and re-run it, rather than re-placing 37 parts. That's the whole reason to plan
for a package change now.

Workflow: close KiCad → I run it with `--dry` and show you the list → `pcb_move.py` → you
reopen and look. **Placement repeats; routing doesn't.** Every channel's fan-in to U1 has a
different length and angle, so you route those by hand. Only the short in-cell link
(R2 harness pad → R1 harness pad) repeats exactly.

**Channel 0 (R100 only)** is the left end of the R1 row, half a pitch left of R201. There is no
R2 for channel 0. Its tap from J1.1 is the outermost, and its C0_F trace is the outermost of the
bus that wraps under U1 to pin 38. NT1 goes beside J1.1 (step 5).

**What to look for:**
- Ratsnest: the tap lines from J1/J5 fan out to the row **without crossing**. A crossing means two
  channels are swapped or one is flipped (rotate it 180°).
- Fan-in: ch 11–18 drop onto U1's top pins; ch 0–10 leave the row as one bus down U1's left side,
  ch 0–2 wrapping round to the bottom pins. The bus is in pin order, so nothing crosses.
- Banks: every neighbour in the row and in the bus is the adjacent cell (≤ 25 V, 0.2 mm). The
  far-apart nets to watch are below U1: keep Q301's VCOLL copper (bank 6) clear of the ch 0–3
  bus (bank 0), or the 0.6 mm rule will push the pour back.
- Length: at 4.2 mm the row is 77 mm (x ≈ 1.9–79).

**Check:** `check_pcb_parity.py --variant lean`, then DRC. Expect 0 clearance/courtyard
errors. **Commit:** `PCB (Lean): cell channels placed`.

## Step 5: the C0 sense (R100 to J1.1)

The rule: **CELL0 copper (J1.1 → R100 pin 1) is one dedicated trace, and V− touches it
only at the net tie NT1.**

**What a net tie is:** a footprint with two pads (one per net) joined by a small copper
bridge. It's the only place KiCad allows two different nets to touch. It goes in the BOM as
nothing: it is just copper on the board. Anywhere else, CELL0 copper touching V− copper is a
DRC **short** error.

1. Place **NT1** right beside J1.1, its CELL0 pad toward the J1.1 pad and its V− pad toward
   the board. Join the CELL0 pad to J1.1 with the shortest, widest trace you can (about
   1–2 mm).
2. Route **R100 pad 1 → J1.1** on its own 0.25 mm trace on the front. It ends at the J1.1
   pad, not at NT1.
3. The V− pour (step 8) connects to NT1's V− pad. It stays away from the CELL0 trace by
   itself: different net, so the zone fill keeps clearance.

**Why:** Figure 99 of the datasheet. While measuring, R100 carries no current (DCP = 0 pauses
balancing), so any voltage on its trace is error on cell 1. If supply current (up to 35 mA) shared
even 20 mm of 0.25 mm 1 oz copper (about 40 mΩ), cell 1 would read about 1.4 mV off. With the
tie at J1.1, the only shared copper is the 1–2 mm from the J1.1 pad to NT1: a few µV. While
cell 1 balances, its current returns through R100 and this trace (≤ 89 mA), which is fine for
0.25 mm. This is the same split Guard makes at J1.1 (fuse F100 to the sense, F120 to V−); Lean
replaces F120 with the tie.

**Check:** DRC. A `shorting_items` error means V− copper touches CELL0 somewhere other than
NT1. An unconnected item on CELL0 or V− means the trace or the tie isn't joined yet.

## Step 6: supply (Q301, R301/R302, C301–C305) and U1's bottom side

1. **C303 (VREG 1 µF)** first: on the U1 pin 48 corner, the shortest loop to V−. Then
   C304/C305 (VREF1/2) at pins 51/50 on the right side, and R401/R402 at IBIAS/ICMP (57/58).
2. **R301 + C301** (V+ filter) at pin 1, the top-right corner. Its feed comes from CELL18:
   take it off the ch 18 tap trace or J5.10 directly.
3. **Q301** below U1 (as in Guard, around (60, 58)), with R302/C302 at the collector and the
   emitter (VREG) trace to C303.
4. **VCOLL copper:** reserve a rectangle around Q301's tab, about **25 × 25 mm on both layers**.
   The tab is the heat path: 52 × 52 mm 2 oz gives Tj ≈ 92 °C at 1.6 W, and 25 × 25 mm 1 oz gives
   about 150 °C (the limit). This copper is bank 6 (top of stack), so the rules keep 0.6 mm to
   banks 0–4 and nothing low-voltage may sit inside it.

**What to look for:** VREG and VREF caps within about 2 mm of their pins, with a direct via to
the back V− pour beside each cap's V− pad.

**Check:** DRC. **Commit** (or batch with step 7).

## Step 7: isoSPI passives, NTC, test points

- **isoSPI:** R501/R502/C501/C502 and R601/R602/C601/C602 in the column at x ≈ 90, between U1
  and each transformer's chip side, as in Guard. Keep both 51 Ω resistors of a port in line
  with the pair, and the CM/CT caps right at their node. **Nothing else** in the U1 →
  transformer → connector corridor.
- **NTC:** R701–R704 and C701–C704 next to GPIO1–4 (pins 39–42, U1's bottom side). J2's traces
  run down from the top edge. **TH701** (onboard NTC) somewhere representative of board
  temperature, but **not** in the R2 band: next to it, it reads balance heat, not cell heat.
- **Test points (changed 2026-11-09):** Lean's TP1–TP14 are all bare 1.5 mm pads on the **back**
  (`make_lean.py` swaps the loops, `lean_place.py` places them and runs `flip_back.py`), so
  none of the front is used. Keep them ≥ 3 mm apart with labels on the back silk and run their
  nets with a via from the front. The rest of this bullet is the Guard plan: TP1–TP10 along the
  bottom edge, ≥ 5 mm apart (hook clips), silk labels.
  Lean keeps TP11–TP14 (bare HV pads on VCOLL, C6_F, C12_F, C18_F): put them by their nets,
  in the channel row and in the Q301 copper, away from the low-voltage loops.

**Check:** `check_pcb_parity.py --variant lean`, DRC, then a **3D render** (dashboard button,
or I run `render_board_3d()` in the background). Look for: TP loops reachable, plugs not
blocked, nothing tall between the GH connectors and the board edge. **Commit:** `PCB (Lean):
placement complete`. Tick the matching boxes in the design basis placement checklist (doc
commit, separate).

## Step 8: routing

### Order (most constrained first)

1. **isoSPI pairs**: chip side (IPA/IMA, IPB/IMB) and line side. Short, side by side, front
   layer, no vias except the one J3/J6 needs on Guard (Lean has no J6/J7, so none) (their pins are in opposite order, so one line net
   has to change layer **inside** the port's own area). Use the differential-pair router (6).
2. **U1 fan-out**: 0.5 mm pitch. One trace leaves each pad straight out about 1 mm before it
   turns. The router follows the net class: HV_CELL 0.25 and BALANCE 0.30 at the pads. A 0.30
   track between neighbouring 0.30 pads doesn't fit, which is why each pin gets its own short
   escape straight out.
3. **Cell fan-in** (Sn and Cn_F from each channel to its pin): in order, channel by channel,
   front layer. This is where the "no crossings" placement pays off. If you need a via, the
   placement is wrong.
4. **Tap traces** (J1/J5 → channels), front, nested, C0 outermost.
5. **C0 sense trace and NT1** (step 5).
6. **Supply** (V+, VCOLL, DRIVE, VREG), then **NTC/GPIO**, last the **test points**.
7. **Pours** last (below), then refill (B).

### Rules of thumb for this 2-layer board

- **Front = signals. Back = V− pour**, as unbroken as possible. That makes the back a heat
  spreader and a low-impedance return. Short back-side jumps are fine (two vias, a few mm) where
  something must cross, but every back-side trace cuts the pour. Keep jumps short and run them
  in the same direction.
- **No pour, no foreign tracks** under T501/J3 or T601/J4 (the rules file flags it; on Guard also J6/J7).
  Draw a **keepout area** (no copper pour, no tracks) on both layers over each port's line side.
  DRC then shows the barrier as a shape, and the pour won't creep in.
- **The V− pour** must keep 0.6 mm from banks 2+ and 2.0 mm from the isoSPI line side. The custom
  rules do this automatically when the zone fills; you don't set it on the zone. Leave the zone's
  own clearance at the default.
- **U1 EP:** the footprint's 16 thermal vias take heat to the back pour. Make sure the back pour
  covers the area under U1 solidly (no traces under the EP on the back).
- **Balance resistor heat:** each R2 pad is its own net (CELLn / Sn), so they can't share a
  pour. Use (a) the back V− pour under the whole R2 band (heat crosses the 1.6 mm FR4 and spreads)
  and (b) fat pads: a small front-layer zone per pad, same net, about 2 × the pad area. Don't
  add V− vias inside the R2 band, where they would only make clearance problems.
- **Q301:** VCOLL zones on both layers with 10–20 stitching vias (0.6/0.3 mm) through the tab
  area. The back VCOLL zone needs a **higher priority** than the V− pour, so the pour flows
  around it.
- **Tap traces as the fuse:** the design basis says Lean's thin traces act as the fuse
  (Racc). Open question: should each tap get a deliberate neck (for example 0.2 mm × 5 mm near
  the connector) so the fusing point is known and is not under U1? Decide before routing the
  taps; it's a design-basis entry, not a layout whim.
- **Angles and stubs:** 45° only, no acute corners, no stubs. The router's walkaround mode
  (not shove) is easier while learning.

### KiCad keys you'll use most

**X** route, **6** diff-pair route, **V** via while routing, **/** flip posture, **W/Shift+W**
cycle track widths (leave on "use net class"), **`** highlight net, **B** refill zones,
**D** drag a track keeping 45°, **E** properties, **L** lock.

## Step 9: checkpoints and commits

| When | Run | Pass means |
|---|---|---|
| After every session in KiCad (KiCad closed, saved) | `check_pcb_parity.py --variant lean` | PASS: footprints, pad nets, parity, all on F.Cu (Lean: except TP1–TP14, which must be on B.Cu) |
| After F8 or any net change | `make_rules.py --variant lean` then `--check` | rules: OK (canary fired) |
| After each placement step | DRC in KiCad, or `kicad-cli pcb drc --severity-all` | 0 errors. Unconnected and silk warnings allowed until the end |
| After placement, and at the end of routing | 3D render (top + iso) | Eyeballed: plugs, TPs, clearances, labels |
| End of routing | DRC with zones refilled, `--schematic-parity` | 0 errors, 0 unconnected, silk triaged |

**Commits:** one PCB commit per finished step (`PCB (Lean): …`) holding only
`slave-18s-lean/*.kicad_pcb` (plus the `.kicad_pro`/`.kicad_dru` when `make_rules.py` changed them).
Script changes go in their own `Tools:` commits. Design-basis updates (positions, checklist
ticks, decisions) go in separate `Docs:` commits. Re-export the site after the placement
commit, not before (next section).

## Board Boxes and the variants

- **Local dashboard:** already shows both. `/api/boards` walks the repo for every
  `.kicad_pcb`, so `slave-18s-lean/adbms1818-slave-18s-lean.kicad_pcb` is in the board dropdown
  next to Guard. Boxes (`<board>.boxes.json`), 3D renders (`<board>_3d_top/iso.png`) and the
  schematic PDF are all stored per board, so Lean gets its own annotations and renders without
  touching Guard's.
- **Hosted site:** published with Lean on 2026-11-06 (step 2 state: staged parts below the
  outline, top render made without them so it matches the outline). Re-export after each
  placement commit: `export_site.py` → `node check_hosted.cjs` → push `site/`.
- **Layout practice card: removed 2026-11-10.** It was a step list with checks measured from
  the board, plus a button that drew the 18-channel row as boxes for another pitch or package.
  It never hid or moved a part, so there was nothing to practise on. Placement is tried with
  `lean_place.py` (knobs at its top; it reports parked parts and courtyard overlaps) and looked
  at in the dashboard. Boxes the row preview drew stay in a saved boxes file as ordinary boxes;
  delete their colors to remove them.
- **Top render with parked parts:** the dashboard finds the board itself in the render (the
  long unbroken opaque runs), puts that on the outline and draws the rest around it at the same
  scale. Parked parts then show where they are. Until 2026-11-08 it stretched the whole opaque
  area onto the outline, which squashed try 1's render sideways.
- **XR slot overlay (long-term goal):** the Lean PCB has a group on Dwgs.User, "XR slot overlay
  (long-term)": the 156.5 × 37 mm XR BMS slot drawn from the board's top-left corner, two
  ~70 × 35 mm slaves and the plug strip at the right end. Drawing only, no copper; DRC and the
  parity check ignore it. The dashboard draws Dwgs.User lines dashed. Select the group in KiCad
  and delete it if it gets in the way.
- **Saving boxes on the hosted site:** there they save in the browser only, so use **Save .txt**
  to keep work and **Open .txt** to load it back (locally too, before Copy Prompt).

## Step 10: the shrink pass (started early, 2026-11-08)

This step was written as "after the first Lean board has been on the bench, not before". On
2026-11-08 the shrink was started anyway, as quick trial and error with `lean_place.py`, to
find out what fits before any board is ordered. None of the measurements at the end of this
step exist yet, so every heat answer here (balance resistors, Q301) is still a guess until a
board is on the bench.

**Done:** item 1 (2010 at 3.3 mm pitch, row about 62 mm), smaller isoSPI transformers
(SM91502AL), J6/J7 dropped, test points off the front. Width is at the 70 mm goal.
**Not done:** item 2 (the cell plugs set the height), item 3 (Q301 copper), item 4 (outline
and holes for the carrier), and the balance resistor value.

**What shrinks the board most, roughly in order:**

1. **Balance package and channel pitch.** The row of 18 channels is the largest block on the
   board. Going from 2512 (4.2 mm pitch, 77 mm) to a 1210 or 2010 (3.3 mm pitch, about 61 mm)
   shortens it by about a fifth, short enough to run along one ~70 mm XR slave. With 47 Ω the
   per-resistor power is 0.22 W: that's 90 % of a 1206 (no), 45 % of a 1210 (0.5 W), about 30 %
   of a 2010 (0.75 W). A wide-terminal 1218/0612
   (1 W, heat goes out through the long side) is worth a look for heat per mm². Changing the
   package is a Guard schematic edit → `make_lean.py` → F8. KiCad footprints are centred, so
   the parts stay put and only the pitch number in the step-4 script changes.
2. **Connectors.** J1 + J5 side by side take about 45 mm of edge. Options: put them on two
   edges (J5 on the right edge), or a 2-row header (check its voltage
   rating against 75.6 V and the 1 mm J1/J5 rule). The DNP PH alternates J6/J7
   are gone since 2026-11-09.
3. **Q301 copper.** This one sets a floor: the copper can only shrink as far as the measured
   Q301 temperature allows (or use the DPAK fallback ZXTN4004K, 33 °C/W on 50 × 50 mm).
4. **Outline and holes.** Fit to the carrier and the ENNOID master's mounting, then re-place
   H1–H4 (the 4.5 mm keep-out rule still applies).

**Measure before shrinking:**

- Balance heat: all 18 cells balancing at the chosen R2 for 30 min on the bench, no airflow.
  Log the R2 band temperature (thermocouple or IR camera), U1 die temperature (ITMP) and TH701.
  That says whether the R2 band can get denser and whether odd/even balancing is mandatory.
- Q301 temperature at full stack voltage (75.6 V) with isoSPI active.
- Whether 47 Ω's balance current is enough for the pack (the R2 value decision itself).
- Actual area used: I can print each group's courtyard bounding box from the board, so you
  can see where the space goes.
- Carrier constraints: slave pitch on the carrier, connector access from above, screw
  positions.
