Focerqc/testing-BMS-designs/_reference/dashboard-qfbms-board-boxes.png

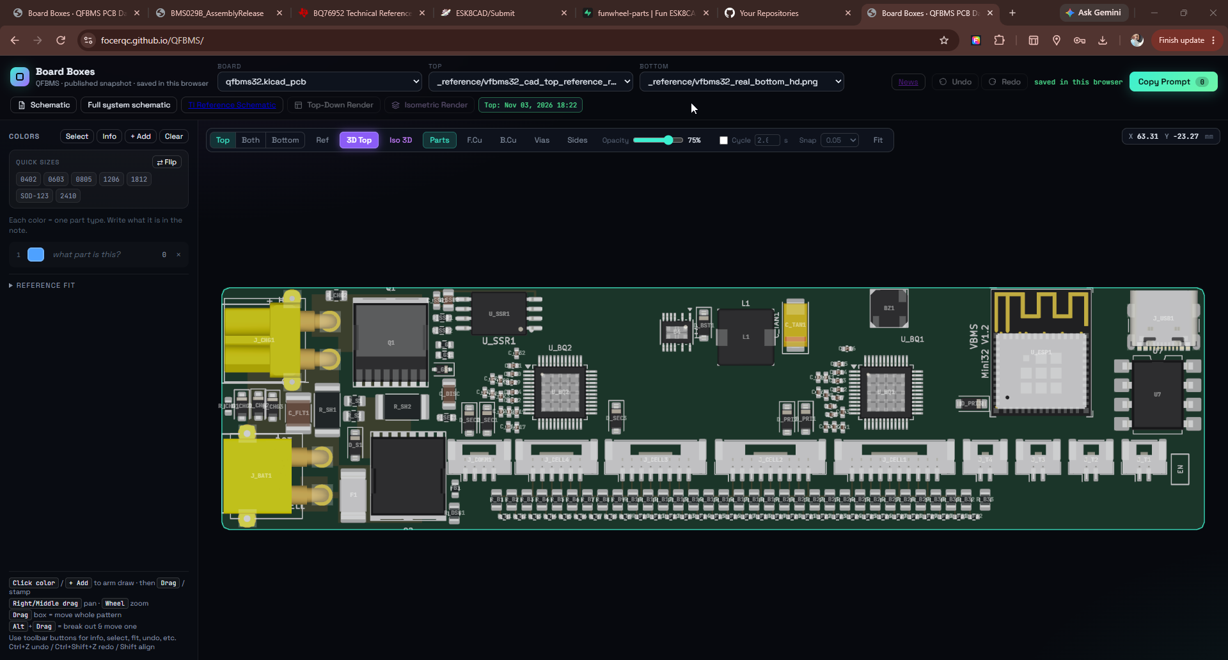
_reference/dashboard-qfbms-board-boxes.png
