Focerqc/testing-BMS-designs/site/data/c861f838c948.png

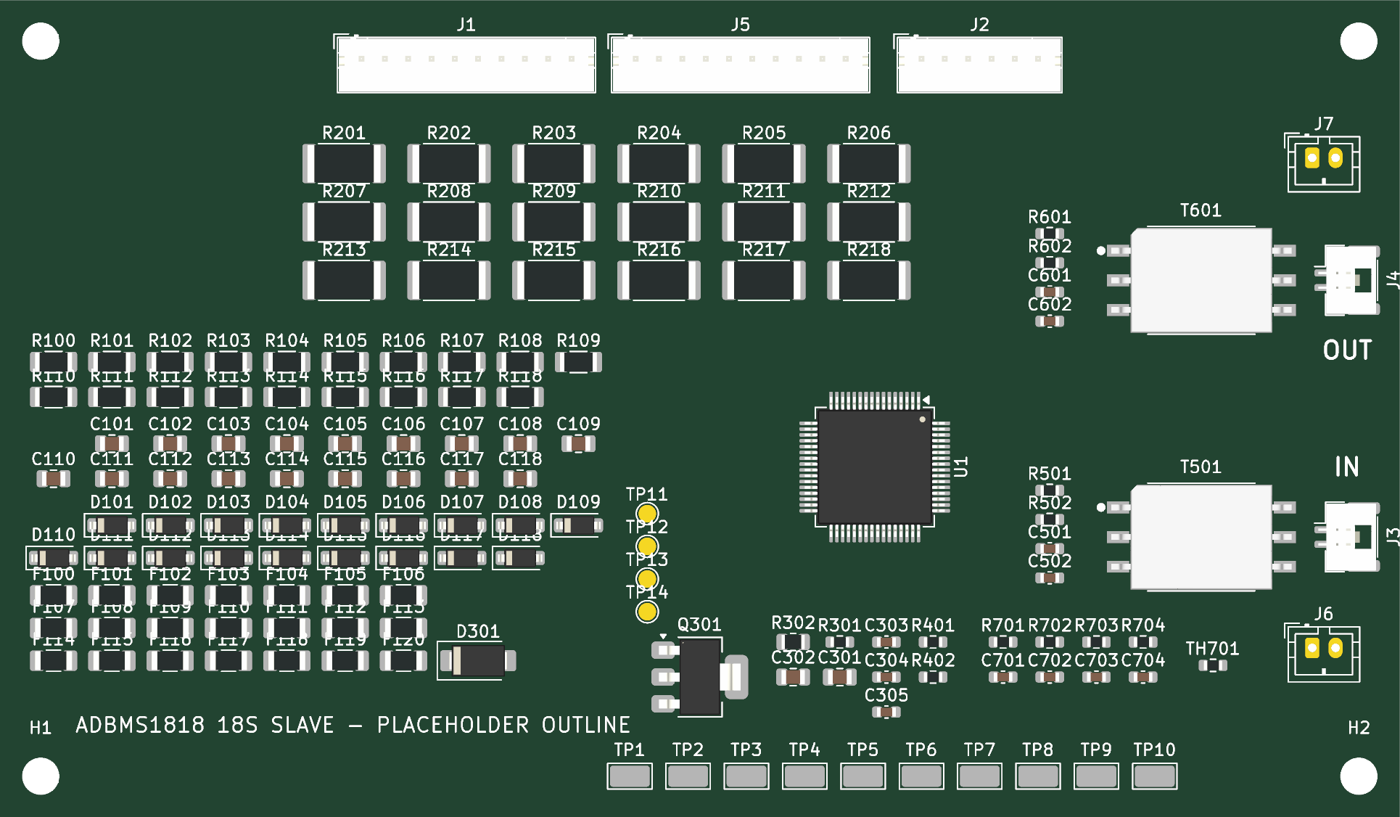
site/data/c861f838c948.png
