Focerqc/testing-BMS-designs/site/data/cec605c0f557.png

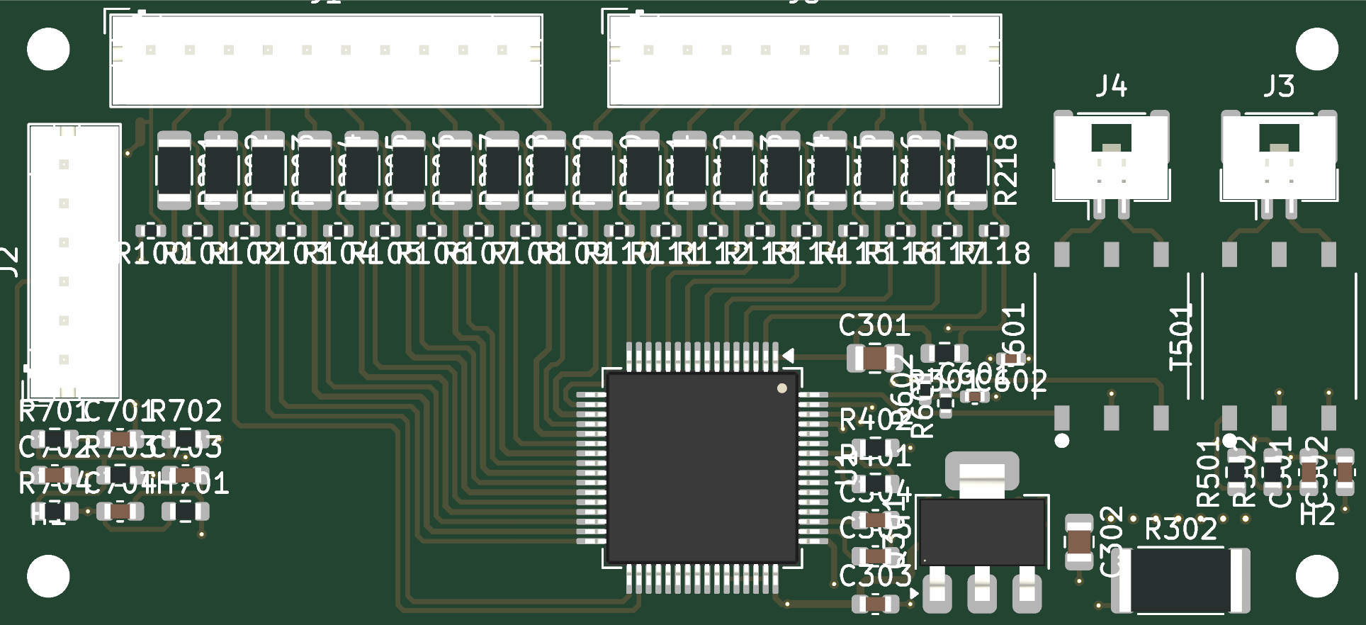
site/data/cec605c0f557.png
