Focerqc/testing-BMS-designs/site/data/da739b91c0f8.png

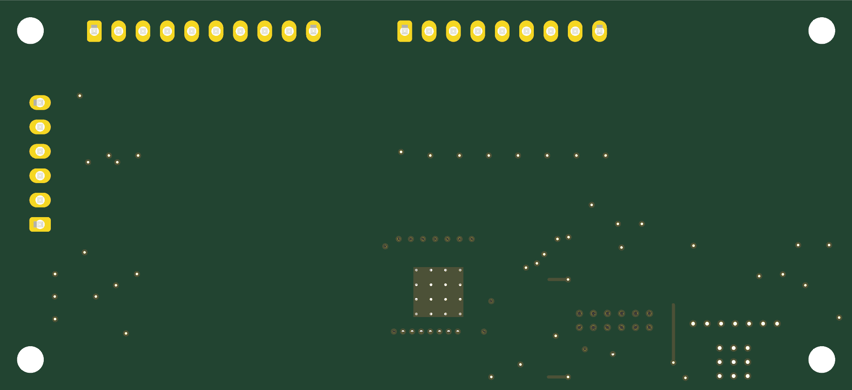
site/data/da739b91c0f8.png
