Focerqc/testing-BMS-designs/site/data/f104cd7f6bea.png

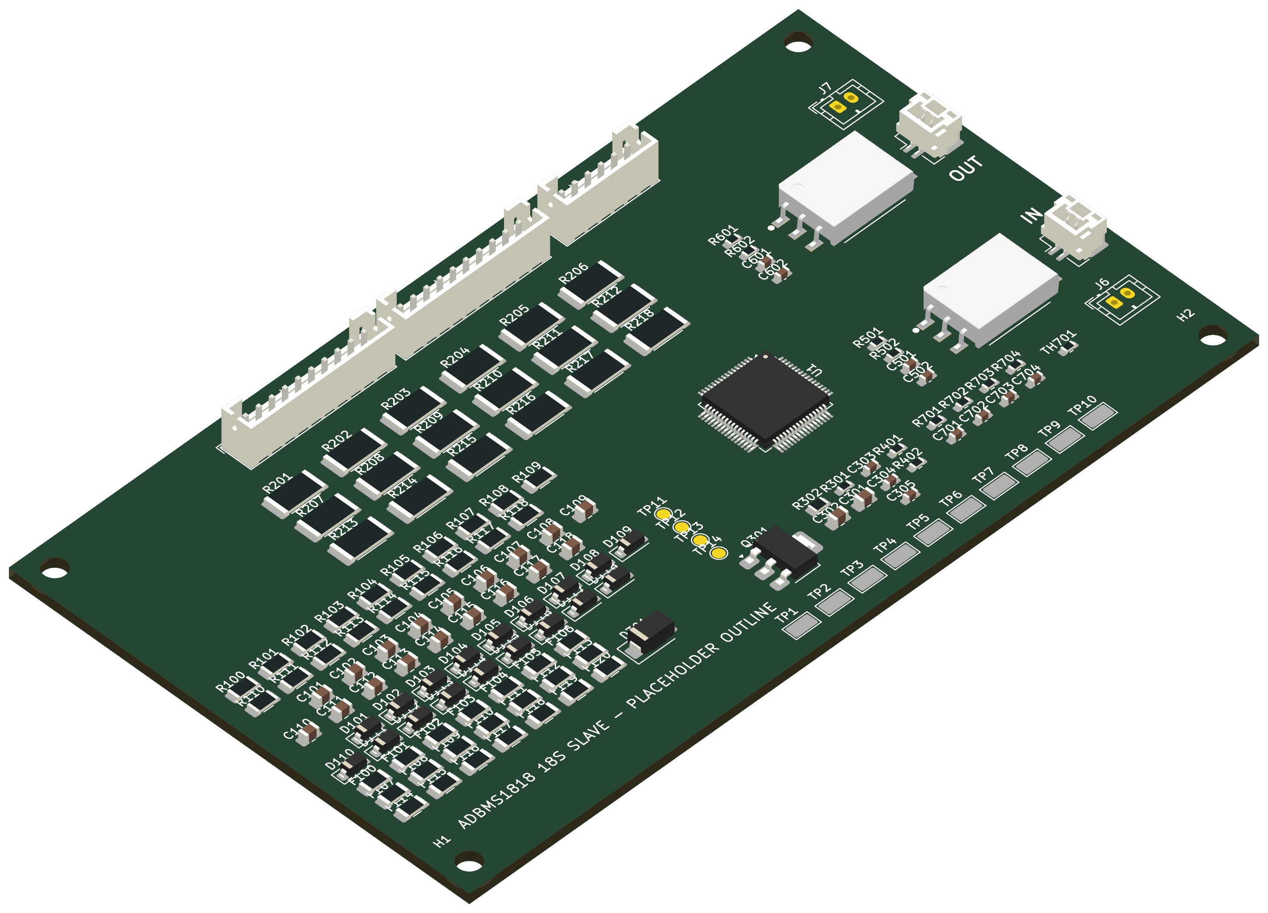
site/data/f104cd7f6bea.png
