Focerqc/testing-BMS-designs/site/files/lean-option1-70x32-route.png

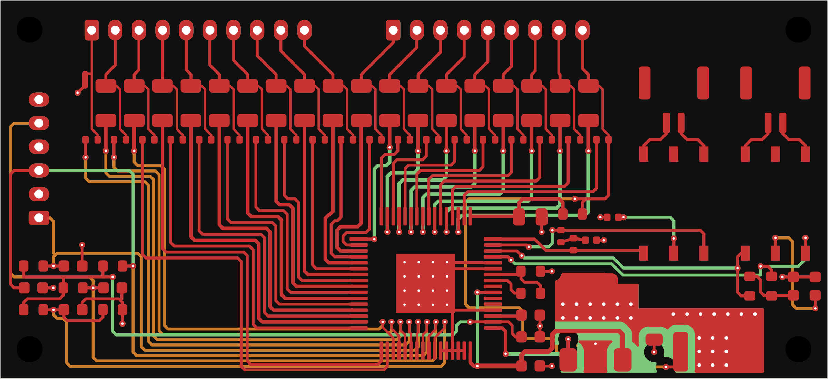
site/files/lean-option1-70x32-route.png
