Focerqc/testing-BMS-designs/site/files/lean-option2-turned-70x34-study.png

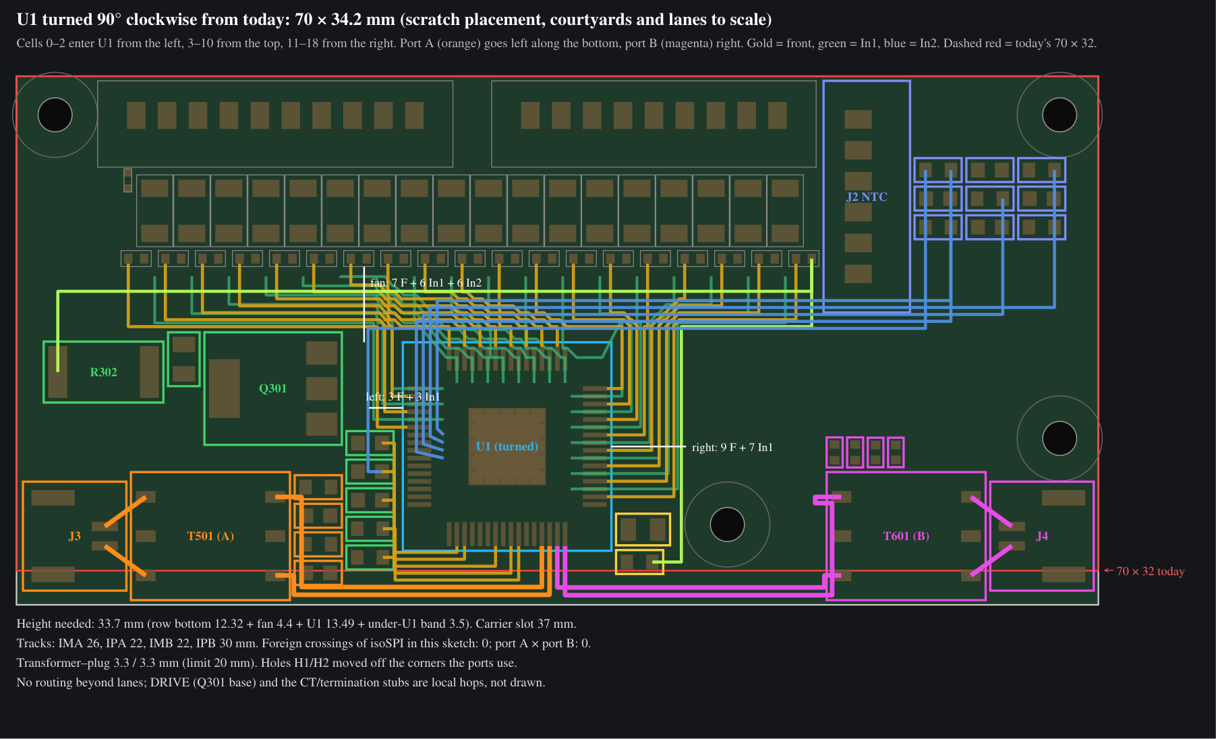
site/files/lean-option2-turned-70x34-study.png
