Focerqc/testing-BMS-designs/site/files/lean-try2-70x50-back.jpg

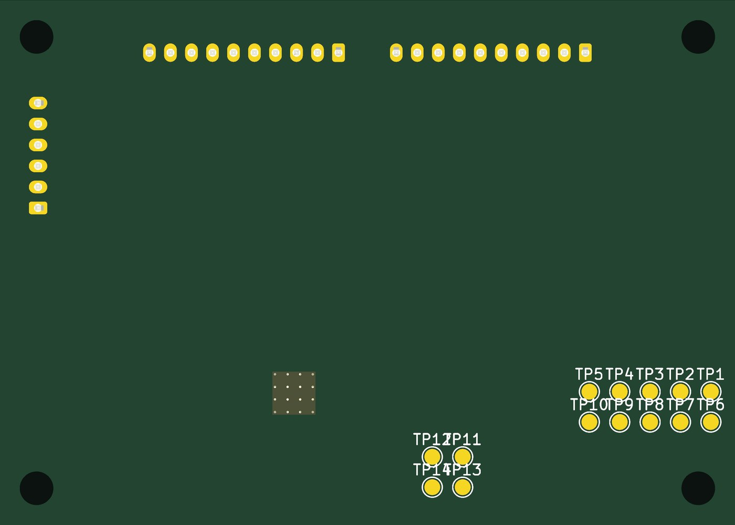
site/files/lean-try2-70x50-back.jpg
