Focerqc/testing-BMS-designs/slave-18s/bom.csv

Comment | Designator | Footprint | LCSC
100n 100V | C101,C102,C103,C104,C105,C106,C107,C108,C109,C110,C111,C112,C113,C114,C115,C116,C117,C118,C301,C302 | C_0805_2012Metric | C28233
1u | C303,C304,C305 | C_0603_1608Metric | C15849
10n | C501,C502,C601,C602 | C_0603_1608Metric | C57112
100n | C701,C702,C703,C704 | C_0603_1608Metric | C14663
B10B-PH-K-S | J1,J5 | JST_PH_B10B-PH-K_1x10_P2.00mm_Vertical | C158038
B6B-PH-K-S | J2 | JST_PH_B6B-PH-K_1x06_P2.00mm_Vertical | C131342
BM02B-GHS-TBT | J3,J4 | JST_GH_BM02B-GHS-TBT_1x02-1MP_P1.25mm_Vertical | C161690
FZT853 | Q301 | SOT-223-3_TabPin2 | C435890
10 | R100,R101,R102,R103,R104,R105,R106,R107,R108,R109,R110,R111,R112,R113,R114,R115,R116,R117,R118 | R_1206_3216Metric | C17903
33 1W | R201,R202,R203,R204,R205,R206,R207,R208,R209,R210,R211,R212,R213,R214,R215,R216,R217,R218 | R_2512_6332Metric | C53728
100 | R301 | R_0603_1608Metric | C22775
100 | R302 | R_0805_2012Metric | C17408
1k | R401,R402 | R_0603_1608Metric | C21190
51 | R501,R502,R601,R602 | R_0603_1608Metric | C23197
100k | R701,R702,R703,R704 | R_0603_1608Metric | C25803
HM2113ZNL | T501,T601 | Pulse_HM2113ZNL | C5730533
100k NTC | TH701 | R_0603_1608Metric | C71280
ADBMS1818 | U1 | LQFP-64-1EP_10x10mm_P0.5mm_EP5x5mm_ThermalVias | C5372802
250mA | F100,F101,F102,F103,F104,F105,F106,F107,F108,F109,F110,F111,F112,F113,F114,F115,F116,F117,F118,F119,F120 | Fuse_1206_3216Metric | C83557
6.8V | D101,D102,D103,D104,D105,D106,D107,D108,D109,D110,D111,D112,D113,D114,D115,D116,D117,D118 | D_SOD-123 | C2120
SMAJ85A | D301 | D_SMA | C698956
5015 | TP1,TP2,TP3,TP4,TP5,TP6,TP7,TP8,TP9,TP10 | TestPoint_Keystone_5015_Micro_Mini | C2906768
