Focerqc/testing-BMS-designs/slave-18s/3dmodels/HM2113ZNL_3D.STEP

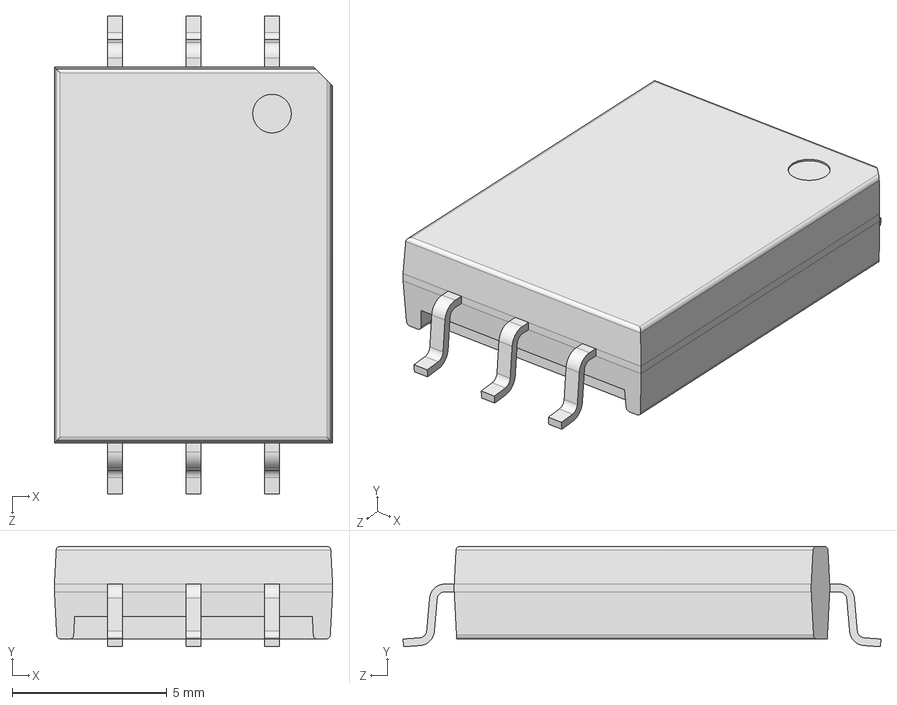
[picture p10: CAD file, 2026-11-07]
slave-18s/3dmodels/HM2113ZNL_3D.STEP
9.00 x 3.25 x 15.5 mm
