Focerqc/testing-BMS-designs/site/files/adbms1818-slave-18s-lean-schematic.pdf

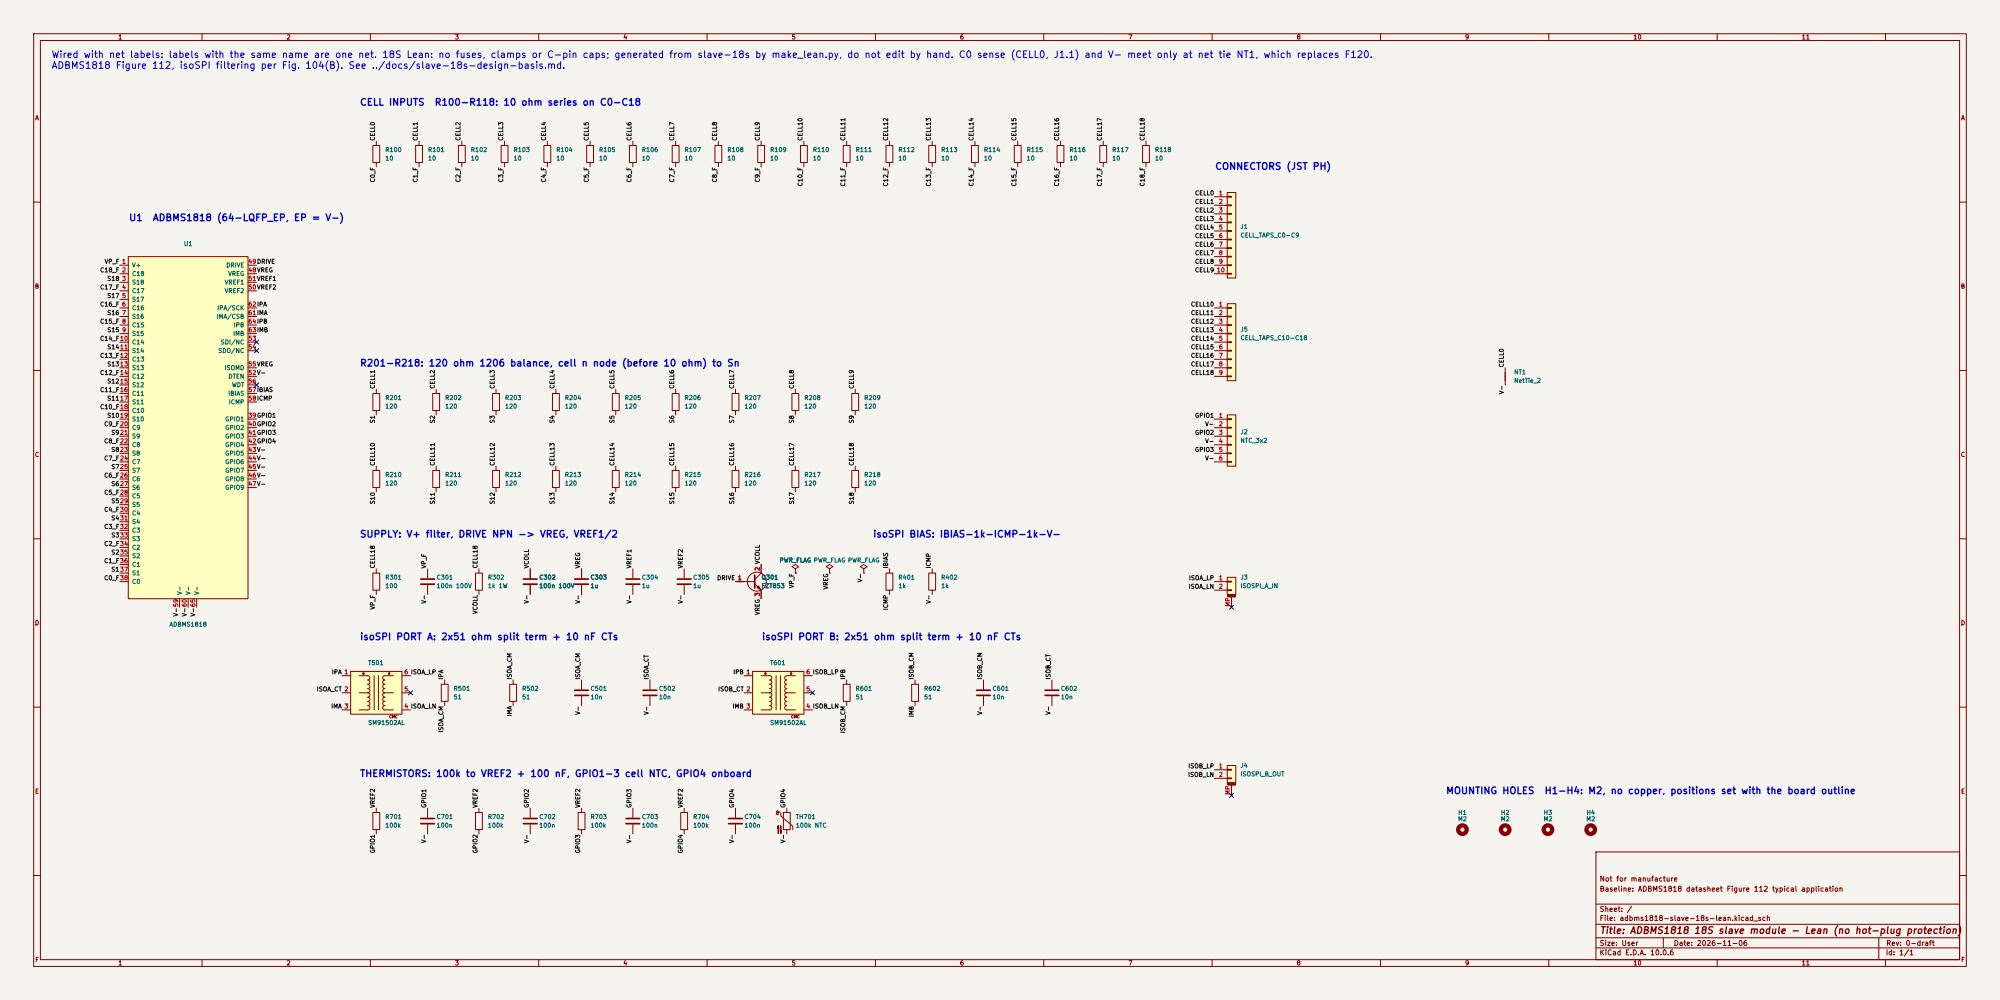
[picture p11: page 1]

Wired with net labels: labels with the same name are one net. 18S Lean: no fuses, clamps or C-pin caps; generated from slave-18s by make_lean.py, do not edit by hand. C0 sense (CELL0, J1.1) and V- meet only at net tie NT1, which replaces F120.
ADBMS1818 Figure 112, isoSPI filtering per Fig. 104(B). See ../docs/slave-18s-design-basis.md.

R201-R218: 120 ohm 1206 balance, cell n node (before 10 ohm) to Sn

SUPPLY: V+ filter, DRIVE NPN -> VREG, VREF1/2

isoSPI BIAS: IBIAS-1k-ICMP-1k-V-

isoSPI PORT A: 2x51 ohm split term + 10 nF CTs

isoSPI PORT B: 2x51 ohm split term + 10 nF CTs

THERMISTORS: 100k to VREF2 + 100 nF, GPIO1-3 cell NTC, GPIO4 onboard

MOUNTING HOLES H1-H4: M2, no copper, positions set with the board outline

Not for manufacture
Baseline: ADBMS1818 datasheet Figure 112 typical application

Sheet: /
File: adbms1818-slave-18s-lean.kicad_sch
Title: ADBMS1818 18S slave module - Lean (no hot-plug protection)

Size: User | Rev: 0-draft | F Date: 2026-11-06
KiCad E.D.A. 10.0.6 | Id: 1/1
