Focerqc/testing-BMS-designs/slave-18s-lean/adbms1818-slave-18s-lean.kicad_pcb

## KiCad design slave-18s-lean/adbms1818-slave-18s-lean.kicad_pcb (2026-11-14)

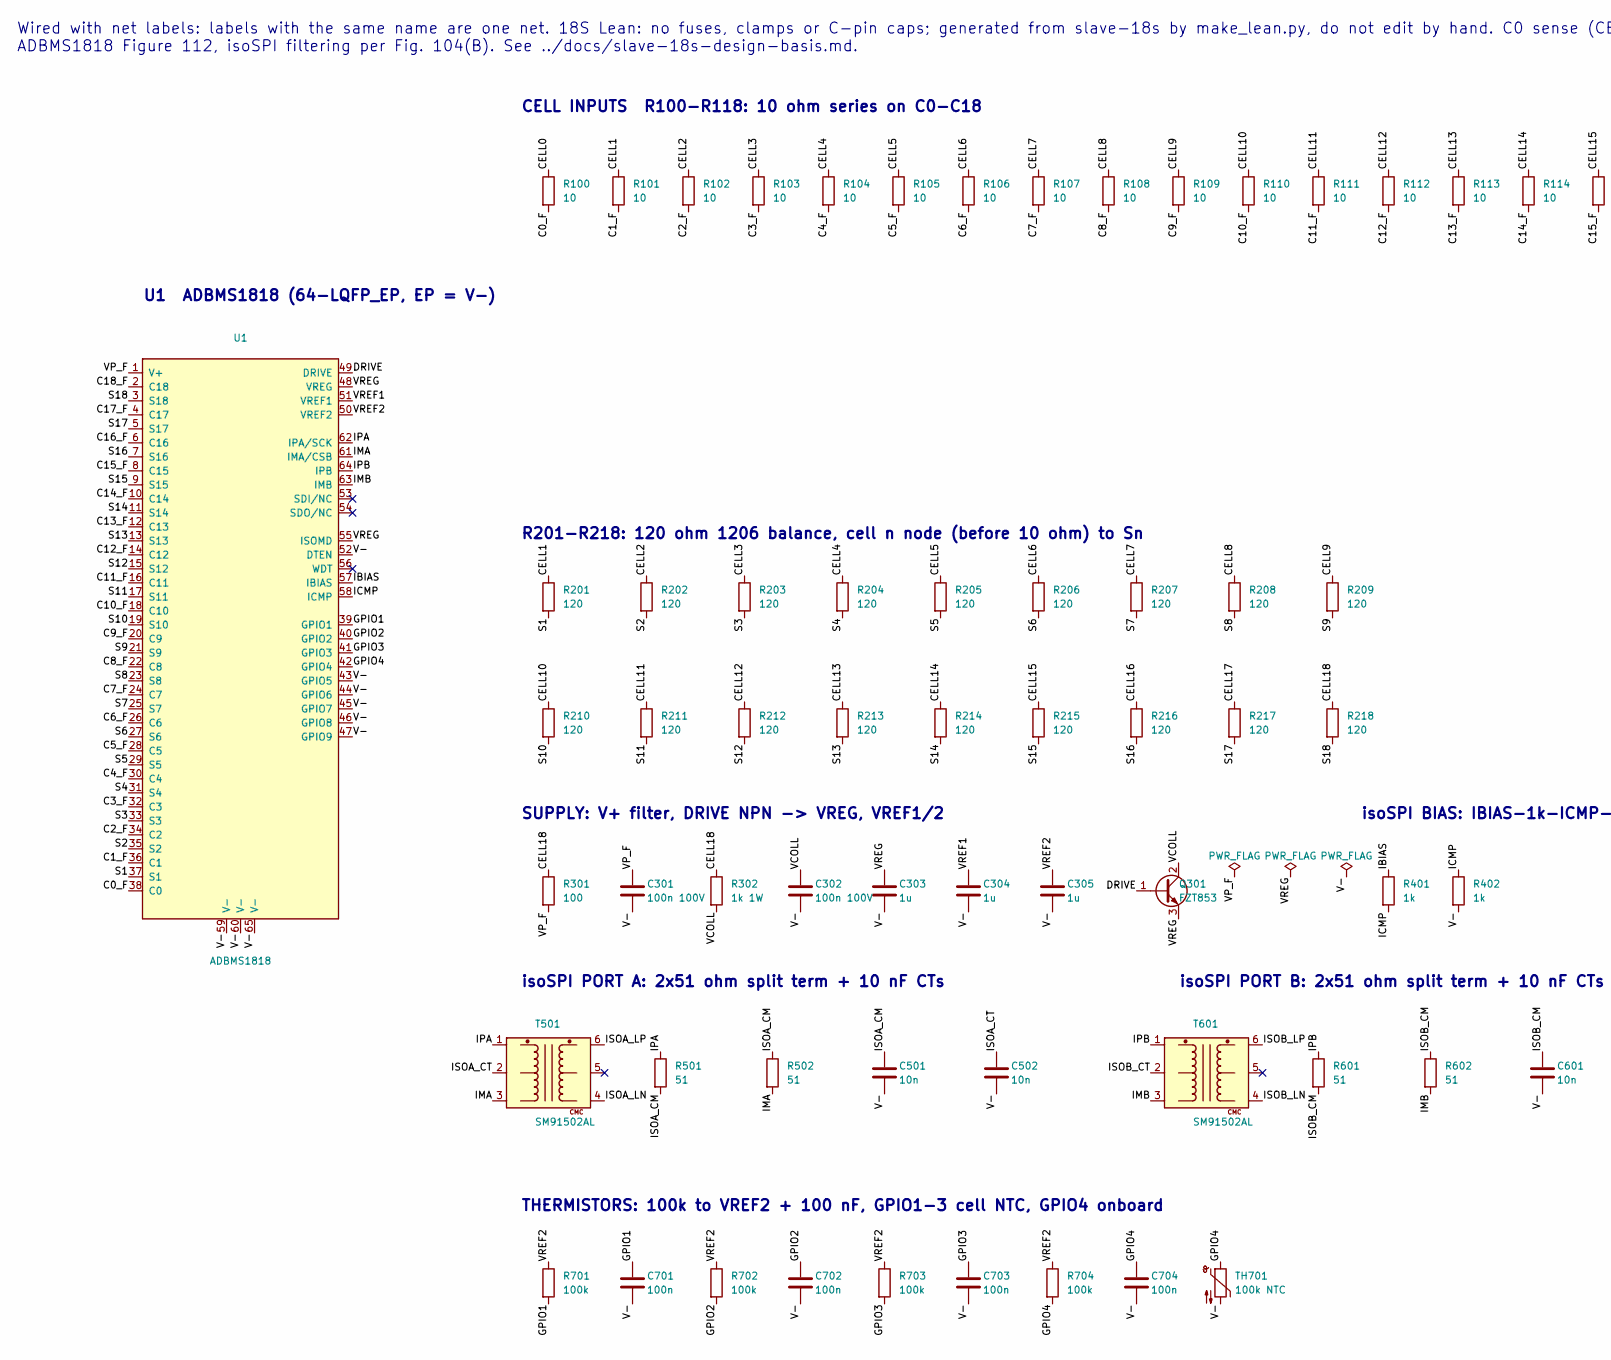
[picture p13: schematic adbms1818-slave-18s-lean.kicad_sch, ADBMS1818 18S slave module - Lean (no hot-plug protection), part in row 1, column 1]

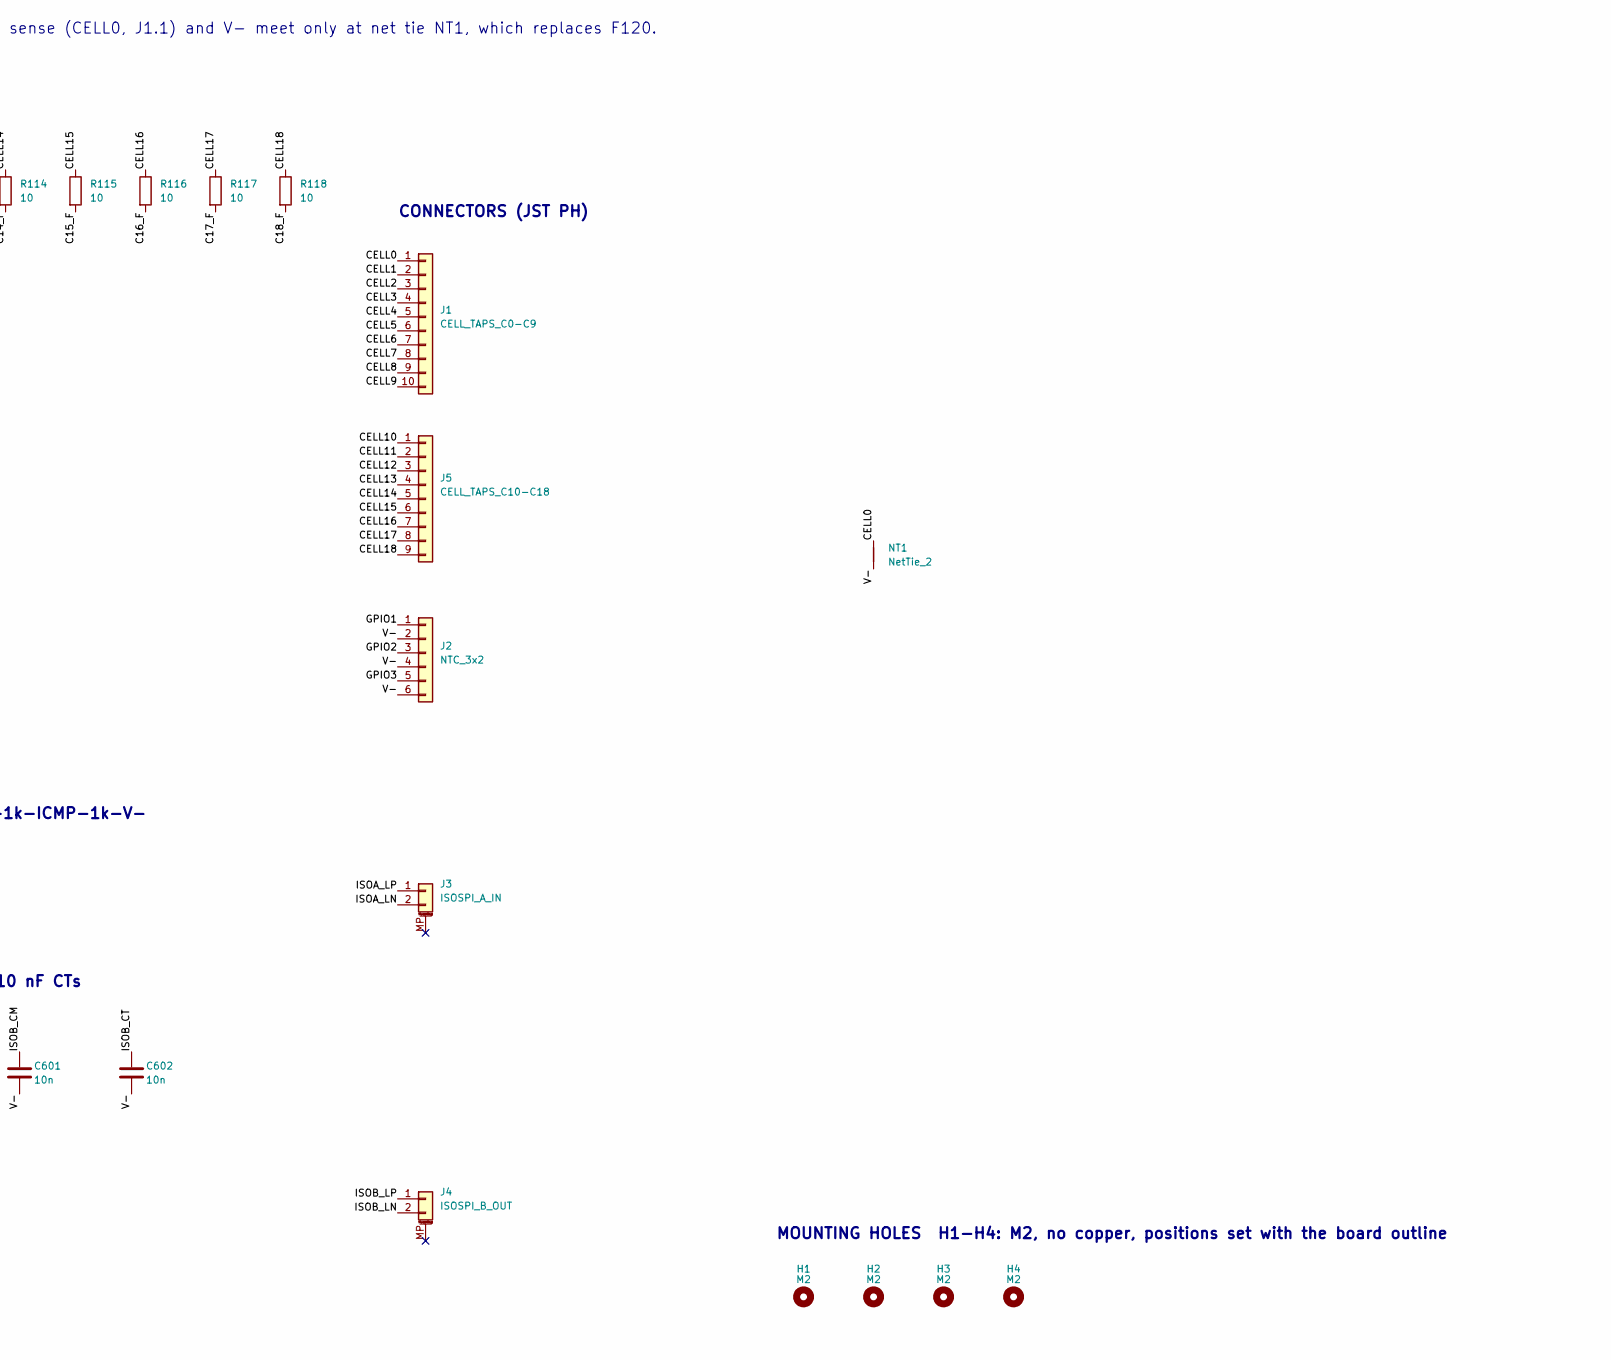
[picture p14: schematic adbms1818-slave-18s-lean.kicad_sch, ADBMS1818 18S slave module - Lean (no hot-plug protection), part in row 1, column 2]

Parts:
C301, C302: 100n 100V; C_0805_2012Metric; MPN CL21B104KCFNNNE; LCSC C28233
C303, C304, C305: 1u; C_0603_1608Metric; MPN CL10A105KB8NNNC; LCSC C15849
C501, C502: 10n; C_0603_1608Metric; MPN 0603B103K500NT; LCSC C57112
C601, C602: 10n; C_0402_1005Metric; MPN CL05B103KB5NNNC; LCSC C15195
C701, C702, C703, C704: 100n; C_0603_1608Metric; MPN CC0603KRX7R9BB104; LCSC C14663
H1, H2, H3, H4: M2; MountingHole_2.2mm_M2
J1: CELL_TAPS_C0-C9; JST_PH_B10B-PH-K_1x10_P2.00mm_Vertical; MPN B10B-PH-K-S(LF)(SN); LCSC C158038
J2: NTC_3x2; JST_PH_B6B-PH-K_1x06_P2.00mm_Vertical; MPN B6B-PH-K-S(LF)(SN); LCSC C131342
J3: ISOSPI_A_IN; JST_GH_BM02B-GHS-TBT_1x02-1MP_P1.25mm_Vertical; MPN BM02B-GHS-TBT(LF)(SN); LCSC C161690
J4: ISOSPI_B_OUT; JST_GH_BM02B-GHS-TBT_1x02-1MP_P1.25mm_Vertical; MPN BM02B-GHS-TBT(LF)(SN); LCSC C161690
J5: CELL_TAPS_C10-C18; JST_PH_B9B-PH-K_1x09_P2.00mm_Vertical; MPN B9B-PH-K-S(LF)(SN); LCSC C157968
NT1: NetTie_2; NetTie-2_SMD_Pad0.5mm
Q301: FZT853; SOT-223-3_TabPin2; MPN FZT853TA; LCSC C435890
R100, R101, R102, R103, R104, R105, R106, R107, R108, R109, R110, R111, R112, R113, R114, R115, R116, R117, R118: 10; R_0402_1005Metric; MPN 0402WGF100JTCE; LCSC C25077
R201, R202, R203, R204, R205, R206, R207, R208, R209, R210, R211, R212, R213, R214, R215, R216, R217, R218: 120; R_1206_3216Metric; MPN 1206W4F1200T5E; LCSC C17909
R301: 100; R_0603_1608Metric; MPN 0603WAF1000T5E; LCSC C22775
R302: 1k 1W; R_2512_6332Metric; MPN 25121WF1001T4E; LCSC C54315
R401, R402: 1k; R_0603_1608Metric; MPN 0603WAF1001T5E; LCSC C21190
R501, R502: 51; R_0603_1608Metric; MPN 0603WAF510JT5E; LCSC C23197
R601, R602: 51; R_0402_1005Metric; MPN 0402WGF510JTCE; LCSC C25125
R701, R702, R703, R704: 100k; R_0603_1608Metric; MPN 0603WAF1003T5E; LCSC C25803
T501, T601: SM91502AL; Bourns_SM91502AL; MPN SM91502ALE; LCSC C915690
TH701: 100k NTC; R_0603_1608Metric; MPN NCP18WF104F12RB; LCSC C71280
U1: ADBMS1818; LQFP-64-1EP_10x10mm_P0.5mm_EP5x5mm_ThermalVias; MPN ADBMS1818ASWAZ-RL; LCSC C5372802

Connections:
/C0_F: R100.2, U1.38 (C0)
/C1_F: R101.2, U1.36 (C1)
/C2_F: R102.2, U1.34 (C2)
/C3_F: R103.2, U1.32 (C3)
/C4_F: R104.2, U1.30 (C4)
/C5_F: R105.2, U1.28 (C5)
/C6_F: R106.2, U1.26 (C6)
/C7_F: R107.2, U1.24 (C7)
/C8_F: R108.2, U1.22 (C8)
/C9_F: R109.2, U1.20 (C9)
/C10_F: R110.2, U1.18 (C10)
/C11_F: R111.2, U1.16 (C11)
/C12_F: R112.2, U1.14 (C12)
/C13_F: R113.2, U1.12 (C13)
/C14_F: R114.2, U1.10 (C14)
/C15_F: R115.2, U1.8 (C15)
/C16_F: R116.2, U1.6 (C16)
/C17_F: R117.2, U1.4 (C17)
/C18_F: R118.2, U1.2 (C18)
/CELL0: J1.1, NT1.1, R100.1
/CELL1: J1.2, R101.1, R201.1
/CELL2: J1.3, R102.1, R202.1
/CELL3: J1.4, R103.1, R203.1
/CELL4: J1.5, R104.1, R204.1
/CELL5: J1.6, R105.1, R205.1
/CELL6: J1.7, R106.1, R206.1
/CELL7: J1.8, R107.1, R207.1
/CELL8: J1.9, R108.1, R208.1
/CELL9: J1.10, R109.1, R209.1
/CELL10: J5.1, R110.1, R210.1
/CELL11: J5.2, R111.1, R211.1
/CELL12: J5.3, R112.1, R212.1
/CELL13: J5.4, R113.1, R213.1
/CELL14: J5.5, R114.1, R214.1
/CELL15: J5.6, R115.1, R215.1
/CELL16: J5.7, R116.1, R216.1
/CELL17: J5.8, R117.1, R217.1
/CELL18: J5.9, R118.1, R218.1, R301.1, R302.1
/DRIVE: Q301.1 (B), U1.49 (DRIVE)
/GPIO1: C701.1, J2.1, R701.2, U1.39 (GPIO1)
/GPIO2: C702.1, J2.3, R702.2, U1.40 (GPIO2)
/GPIO3: C703.1, J2.5, R703.2, U1.41 (GPIO3)
/GPIO4: C704.1, R704.2, TH701.1, U1.42 (GPIO4)
/IBIAS: R401.1, U1.57 (IBIAS)
/ICMP: R401.2, R402.1, U1.58 (ICMP)
/IMA: R502.2, T501.3 (PHY-), U1.61 (IMA/CSB)
/IMB: R602.2, T601.3 (PHY-), U1.63 (IMB)
/IPA: R501.1, T501.1 (PHY+), U1.62 (IPA/SCK)
/IPB: R601.1, T601.1 (PHY+), U1.64 (IPB)
/ISOA_CM: C501.1, R501.2, R502.1
/ISOA_CT: C502.1, T501.2 (PHY_CT)
/ISOA_LN: J3.2, T501.4 (LINE-)
/ISOA_LP: J3.1, T501.6 (LINE+)
/ISOB_CM: C601.1, R601.2, R602.1
/ISOB_CT: C602.1, T601.2 (PHY_CT)
/ISOB_LN: J4.2, T601.4 (LINE-)
/ISOB_LP: J4.1, T601.6 (LINE+)
/S1: R201.2, U1.37 (S1)
/S2: R202.2, U1.35 (S2)
/S3: R203.2, U1.33 (S3)
/S4: R204.2, U1.31 (S4)
/S5: R205.2, U1.29 (S5)
/S6: R206.2, U1.27 (S6)
/S7: R207.2, U1.25 (S7)
/S8: R208.2, U1.23 (S8)
/S9: R209.2, U1.21 (S9)
/S10: R210.2, U1.19 (S10)
/S11: R211.2, U1.17 (S11)
/S12: R212.2, U1.15 (S12)
/S13: R213.2, U1.13 (S13)
/S14: R214.2, U1.11 (S14)
/S15: R215.2, U1.9 (S15)
/S16: R216.2, U1.7 (S16)
/S17: R217.2, U1.5 (S17)
/S18: R218.2, U1.3 (S18)
/V-: C301.2, C302.2, C303.2, C304.2, C305.2, C501.2, C502.2, C601.2, C602.2, C701.2, C702.2, C703.2, C704.2, J2.2, J2.4, J2.6, NT1.2, R402.2, TH701.2, U1.43 (GPIO5), U1.44 (GPIO6), U1.45 (GPIO7), U1.46 (GPIO8), U1.47 (GPIO9), U1.52 (DTEN), U1.59 (V-), U1.60 (V-), U1.65 (V-)
/VCOLL: C302.1, Q301.2 (C), R302.2
/VP_F: C301.1, R301.2, U1.1 (V+)
/VREF1: C304.1, U1.51 (VREF1)
/VREF2: C305.1, R701.1, R702.1, R703.1, R704.1, U1.50 (VREF2)
/VREG: C303.1, Q301.3 (E), U1.48 (VREG), U1.55 (ISOMD)

Notes on the sheet:
R201-R218: 120 ohm 1206 balance, cell n node (before 10 ohm) to Sn
CONNECTORS (JST PH)
CELL INPUTS R100-R118: 10 ohm series on C0-C18
Wired with net labels: labels with the same name are one net. 18S Lean: no fuses, clamps or C-pin caps; generated from slave-18s by make_lean.py, do not edit by hand. C0 sense (CELL0, J1.1) and V- meet only at net tie NT1, which replaces F120. ADBMS1818 Figure 112, isoSPI filtering per Fig. 104(B).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
THERMISTORS: 100k to VREF2 + 100 nF, GPIO1-3 cell NTC, GPIO4 onboard
isoSPI BIAS: IBIAS-1k-ICMP-1k-V-
U1 ADBMS1818 (64-LQFP_EP, EP = V-)
MOUNTING HOLES H1-H4: M2, no copper, positions set with the board outline
isoSPI PORT A: 2x51 ohm split term + 10 nF CTs
isoSPI PORT B: 2x51 ohm split term + 10 nF CTs
SUPPLY: V+ filter, DRIVE NPN -> VREG, VREF1/2

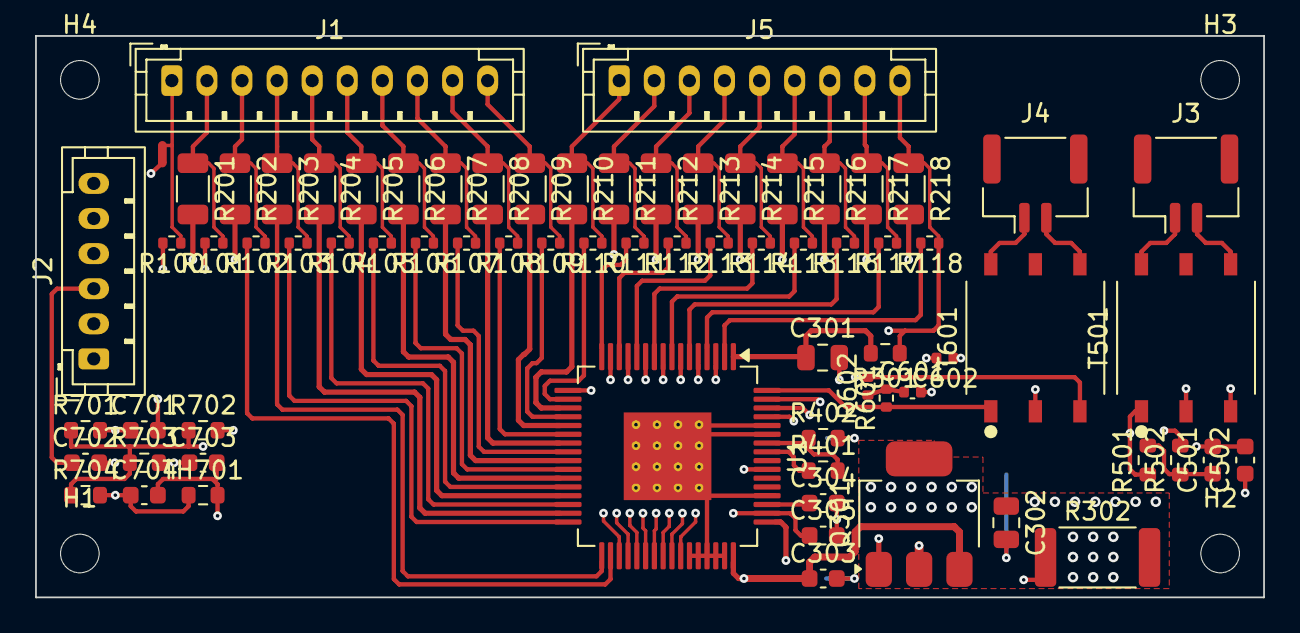
[picture p15: board adbms1818-slave-18s-lean.kicad_pcb from above]

Board: 4 copper layers, 70.0 x 32.0 mm, 77 parts (0 on the bottom side), 81 nets.
