Focerqc/testing-BMS-designs/slave-18s/adbms1818-slave-18s.kicad_pcb

## KiCad design slave-18s/adbms1818-slave-18s.kicad_pcb (2026-11-07)

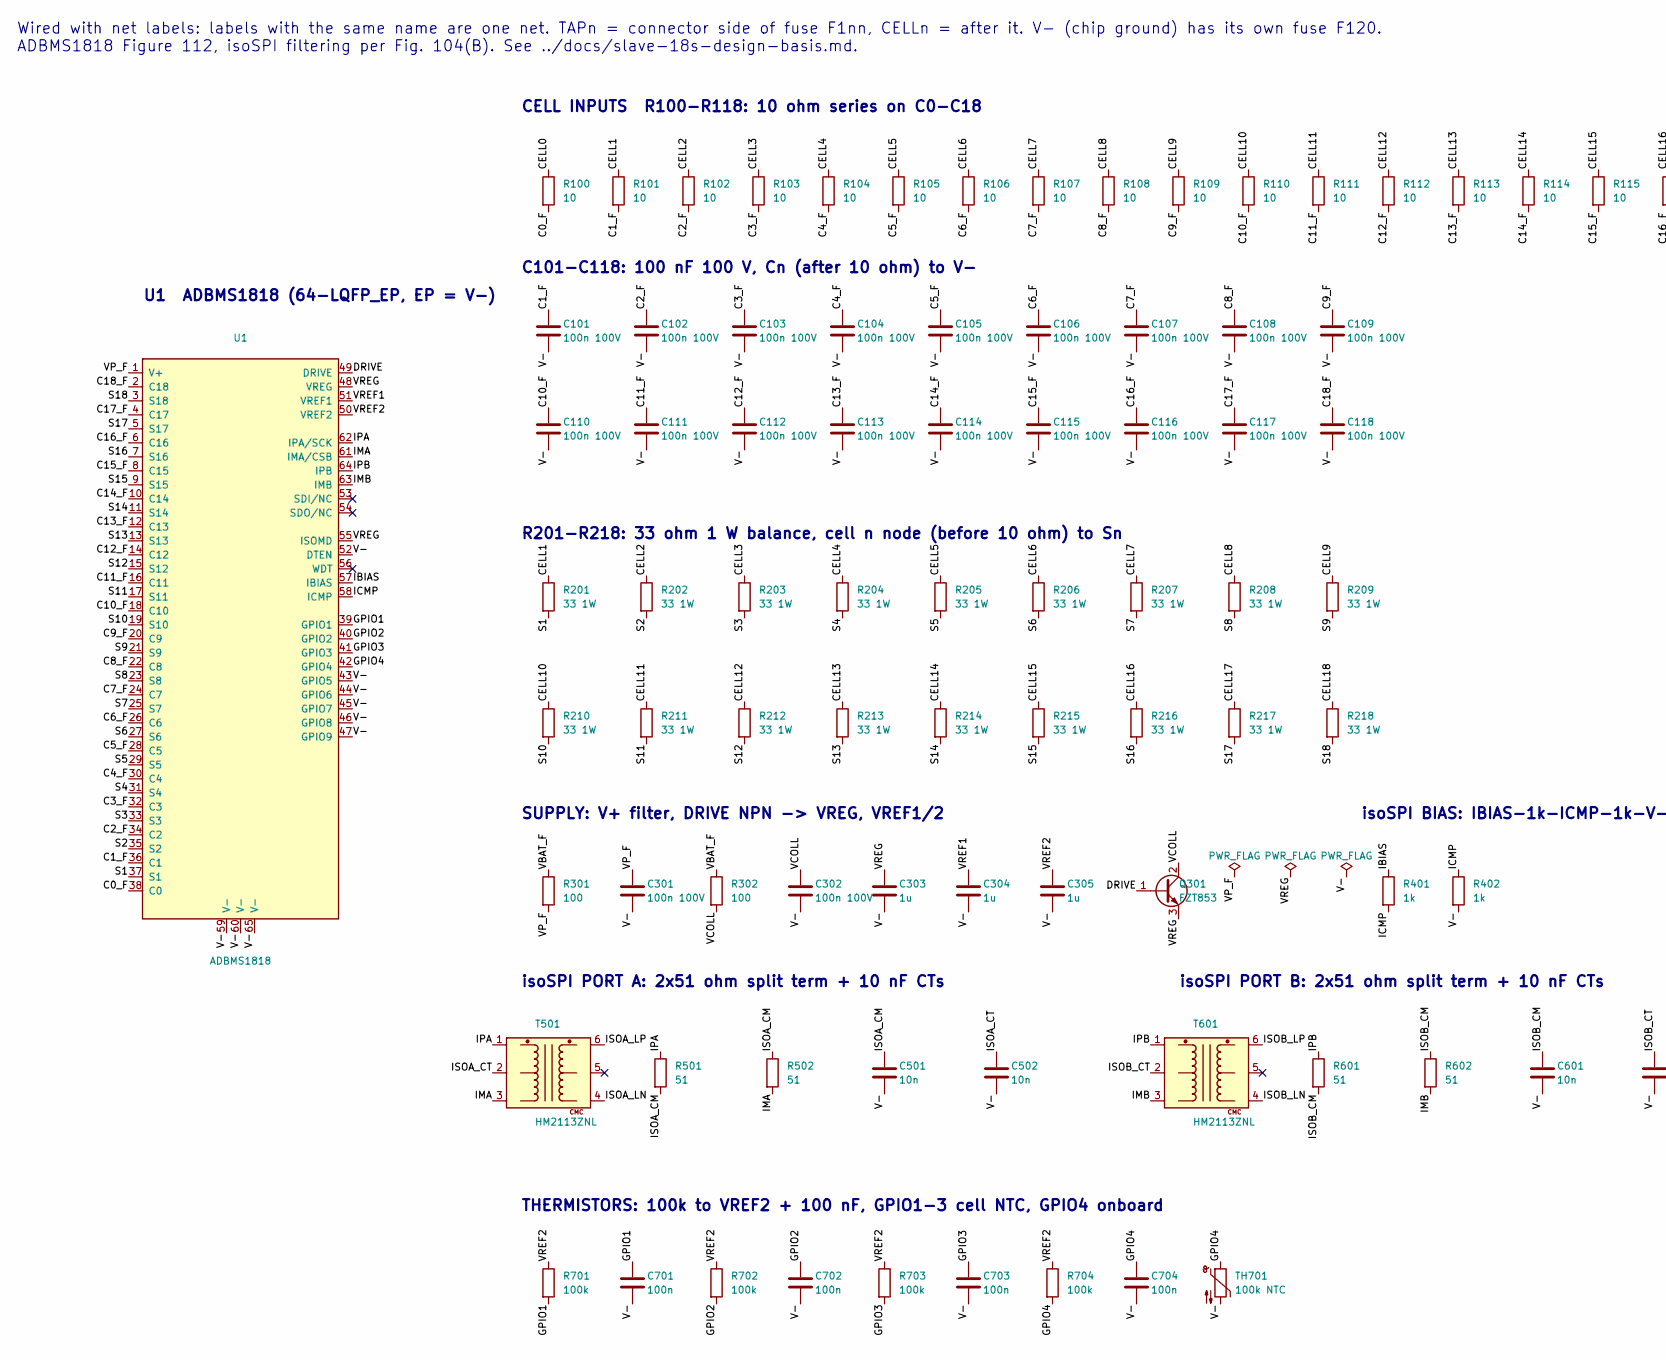
[picture p16: schematic adbms1818-slave-18s.kicad_sch, ADBMS1818 18S slave module, part in row 1, column 1]

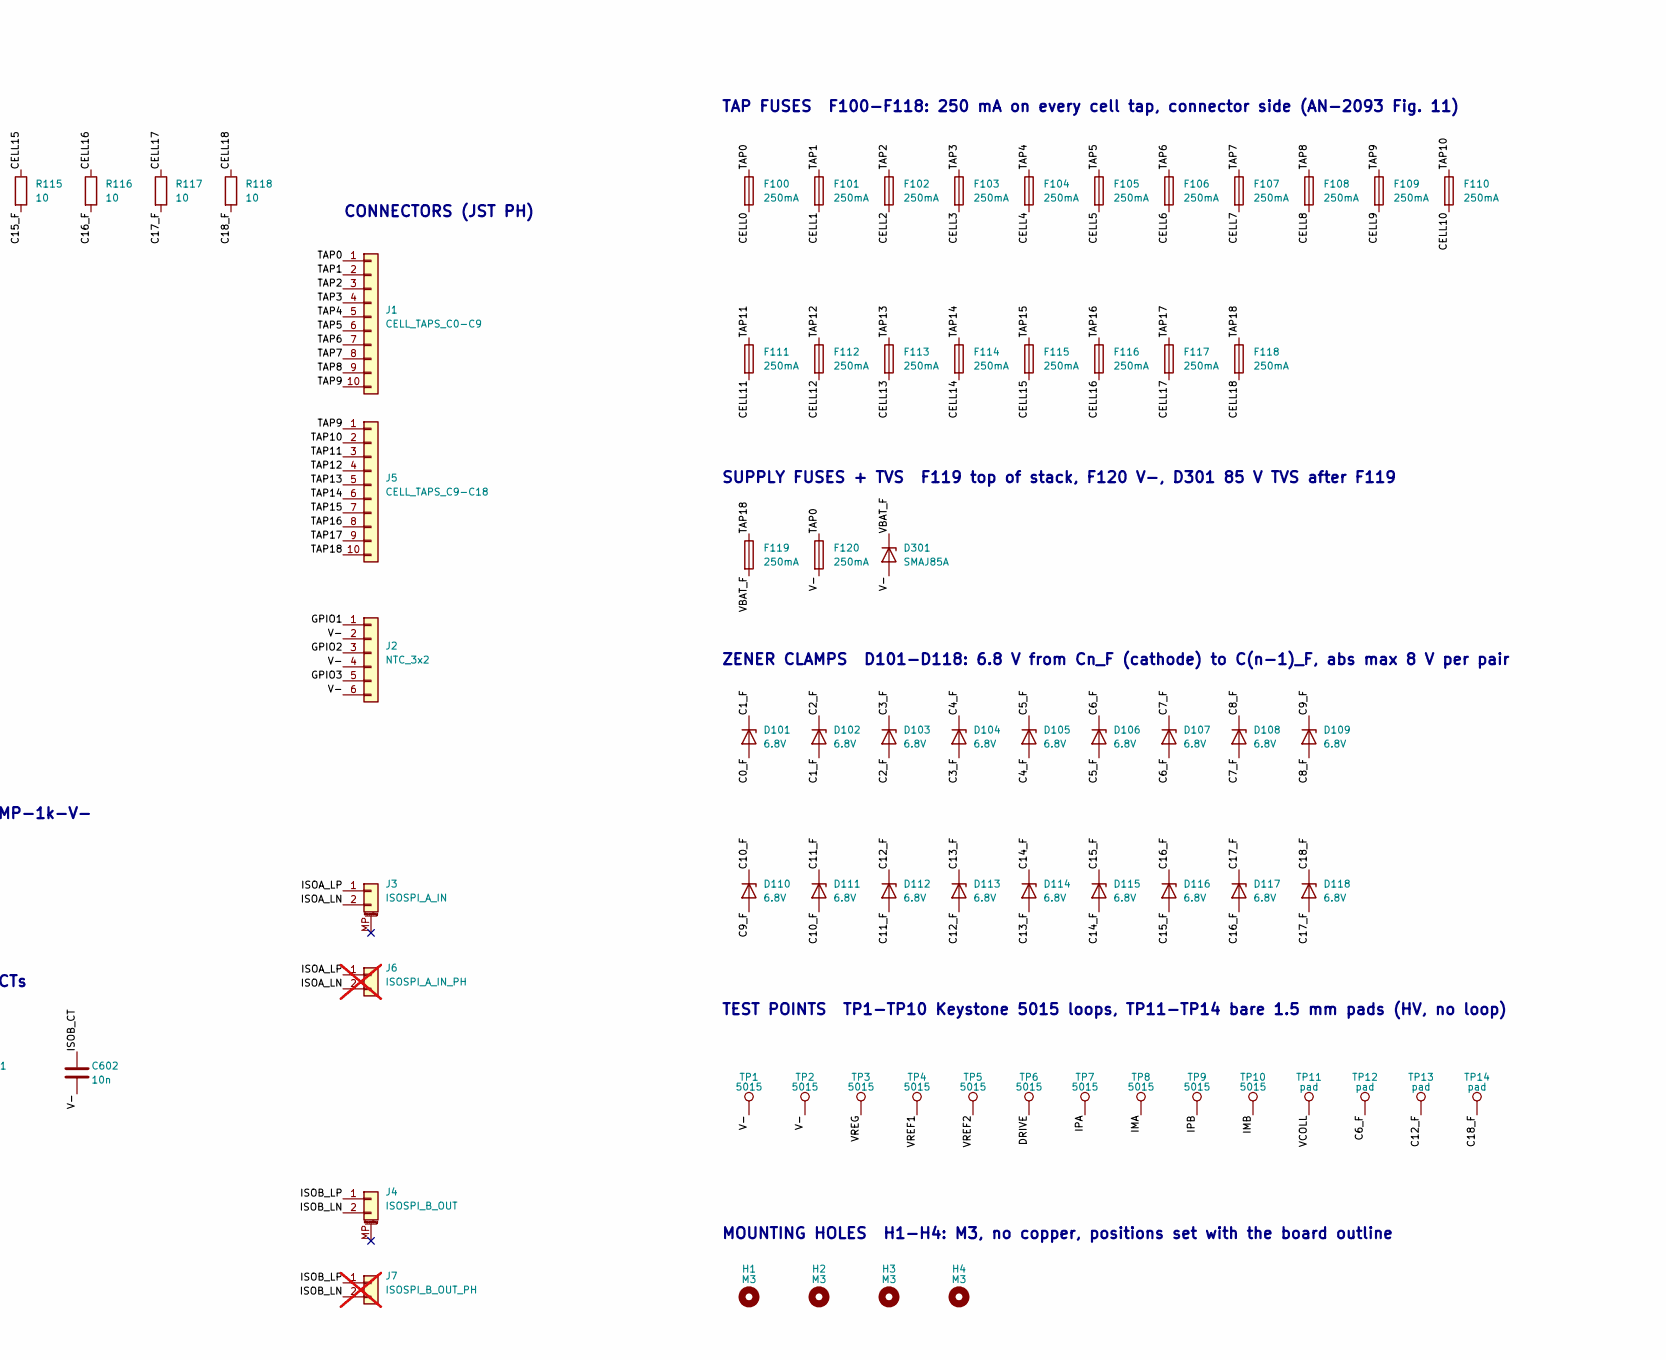
[picture p17: schematic adbms1818-slave-18s.kicad_sch, ADBMS1818 18S slave module, part in row 1, column 2]

Parts:
C101, C102, C103, C104, C105, C106, C107, C108, C109, C110, C111, C112, C113, C114, C115, C116, C117, C118, C301, C302: 100n 100V; C_0805_2012Metric; MPN CL21B104KCFNNNE; LCSC C28233
C303, C304, C305: 1u; C_0603_1608Metric; MPN CL10A105KB8NNNC; LCSC C15849
C501, C502, C601, C602: 10n; C_0603_1608Metric; MPN 0603B103K500NT; LCSC C57112
C701, C702, C703, C704: 100n; C_0603_1608Metric; MPN CC0603KRX7R9BB104; LCSC C14663
D101, D102, D103, D104, D105, D106, D107, D108, D109, D110, D111, D112, D113, D114, D115, D116, D117, D118: 6.8V; D_SOD-123; MPN BZT52C6V8; LCSC C2120
D301: SMAJ85A; D_SMA; MPN SMAJ85A; LCSC C698956
F100, F101, F102, F103, F104, F105, F106, F107, F108, F109, F110, F111, F112, F113, F114, F115, F116, F117, F118, F119, F120: 250mA; Fuse_1206_3216Metric; MPN 0466.250NRHF; LCSC C83557
H1, H2, H3, H4: M3; MountingHole_3.2mm_M3
J1: CELL_TAPS_C0-C9; JST_PH_B10B-PH-K_1x10_P2.00mm_Vertical; MPN B10B-PH-K-S(LF)(SN); LCSC C158038
J2: NTC_3x2; JST_PH_B6B-PH-K_1x06_P2.00mm_Vertical; MPN B6B-PH-K-S(LF)(SN); LCSC C131342
J3: ISOSPI_A_IN; JST_GH_BM02B-GHS-TBT_1x02-1MP_P1.25mm_Vertical; MPN BM02B-GHS-TBT(LF)(SN); LCSC C161690
J4: ISOSPI_B_OUT; JST_GH_BM02B-GHS-TBT_1x02-1MP_P1.25mm_Vertical; MPN BM02B-GHS-TBT(LF)(SN); LCSC C161690
J5: CELL_TAPS_C9-C18; JST_PH_B10B-PH-K_1x10_P2.00mm_Vertical; MPN B10B-PH-K-S(LF)(SN); LCSC C158038
J6: ISOSPI_A_IN_PH; JST_PH_B2B-PH-K_1x02_P2.00mm_Vertical; MPN B2B-PH-K-S(LF)(SN); LCSC C131337; not fitted
J7: ISOSPI_B_OUT_PH; JST_PH_B2B-PH-K_1x02_P2.00mm_Vertical; MPN B2B-PH-K-S(LF)(SN); LCSC C131337; not fitted
Q301: FZT853; SOT-223-3_TabPin2; MPN FZT853TA; LCSC C435890
R100, R101, R102, R103, R104, R105, R106, R107, R108, R109, R110, R111, R112, R113, R114, R115, R116, R117, R118: 10; R_1206_3216Metric; MPN 1206W4F100JT5E; LCSC C17903
R201, R202, R203, R204, R205, R206, R207, R208, R209, R210, R211, R212, R213, R214, R215, R216, R217, R218: 33 1W; R_2512_6332Metric; MPN 25121WF330JT4E; LCSC C53728
R301: 100; R_0603_1608Metric; MPN 0603WAF1000T5E; LCSC C22775
R302: 100; R_0805_2012Metric; MPN 0805W8F1000T5E; LCSC C17408
R401, R402: 1k; R_0603_1608Metric; MPN 0603WAF1001T5E; LCSC C21190
R501, R502, R601, R602: 51; R_0603_1608Metric; MPN 0603WAF510JT5E; LCSC C23197
R701, R702, R703, R704: 100k; R_0603_1608Metric; MPN 0603WAF1003T5E; LCSC C25803
T501, T601: HM2113ZNL; Pulse_HM2113ZNL; MPN HM2113ZNLT; LCSC C5730533
TH701: 100k NTC; R_0603_1608Metric; MPN NCP18WF104F12RB; LCSC C71280
TP1, TP2, TP3, TP4, TP5, TP6, TP7, TP8, TP9, TP10: 5015; TestPoint_Keystone_5015_Micro_Mini; MPN 5015; LCSC C2906768
TP11, TP12, TP13, TP14: pad; TestPoint_Pad_D1.5mm
U1: ADBMS1818; LQFP-64-1EP_10x10mm_P0.5mm_EP5x5mm_ThermalVias; MPN ADBMS1818ASWAZ-RL; LCSC C5372802

Connections:
/C0_F: D101.2 (A), R100.2, U1.38 (C0)
/C1_F: C101.1, D101.1 (K), D102.2 (A), R101.2, U1.36 (C1)
/C2_F: C102.1, D102.1 (K), D103.2 (A), R102.2, U1.34 (C2)
/C3_F: C103.1, D103.1 (K), D104.2 (A), R103.2, U1.32 (C3)
/C4_F: C104.1, D104.1 (K), D105.2 (A), R104.2, U1.30 (C4)
/C5_F: C105.1, D105.1 (K), D106.2 (A), R105.2, U1.28 (C5)
/C6_F: C106.1, D106.1 (K), D107.2 (A), R106.2, TP12.1 (1_1), U1.26 (C6)
/C7_F: C107.1, D107.1 (K), D108.2 (A), R107.2, U1.24 (C7)
/C8_F: C108.1, D108.1 (K), D109.2 (A), R108.2, U1.22 (C8)
/C9_F: C109.1, D109.1 (K), D110.2 (A), R109.2, U1.20 (C9)
/C10_F: C110.1, D110.1 (K), D111.2 (A), R110.2, U1.18 (C10)
/C11_F: C111.1, D111.1 (K), D112.2 (A), R111.2, U1.16 (C11)
/C12_F: C112.1, D112.1 (K), D113.2 (A), R112.2, TP13.1 (1_1), U1.14 (C12)
/C13_F: C113.1, D113.1 (K), D114.2 (A), R113.2, U1.12 (C13)
/C14_F: C114.1, D114.1 (K), D115.2 (A), R114.2, U1.10 (C14)
/C15_F: C115.1, D115.1 (K), D116.2 (A), R115.2, U1.8 (C15)
/C16_F: C116.1, D116.1 (K), D117.2 (A), R116.2, U1.6 (C16)
/C17_F: C117.1, D117.1 (K), D118.2 (A), R117.2, U1.4 (C17)
/C18_F: C118.1, D118.1 (K), R118.2, TP14.1 (1_1), U1.2 (C18)
/CELL0: F100.2, R100.1
/CELL1: F101.2, R101.1, R201.1
/CELL2: F102.2, R102.1, R202.1
/CELL3: F103.2, R103.1, R203.1
/CELL4: F104.2, R104.1, R204.1
/CELL5: F105.2, R105.1, R205.1
/CELL6: F106.2, R106.1, R206.1
/CELL7: F107.2, R107.1, R207.1
/CELL8: F108.2, R108.1, R208.1
/CELL9: F109.2, R109.1, R209.1
/CELL10: F110.2, R110.1, R210.1
/CELL11: F111.2, R111.1, R211.1
/CELL12: F112.2, R112.1, R212.1
/CELL13: F113.2, R113.1, R213.1
/CELL14: F114.2, R114.1, R214.1
/CELL15: F115.2, R115.1, R215.1
/CELL16: F116.2, R116.1, R216.1
/CELL17: F117.2, R117.1, R217.1
/CELL18: F118.2, R118.1, R218.1
/DRIVE: Q301.1 (B), TP6.1 (1_1), U1.49 (DRIVE)
/GPIO1: C701.1, J2.1, R701.2, U1.39 (GPIO1)
/GPIO2: C702.1, J2.3, R702.2, U1.40 (GPIO2)
/GPIO3: C703.1, J2.5, R703.2, U1.41 (GPIO3)
/GPIO4: C704.1, R704.2, TH701.1, U1.42 (GPIO4)
/IBIAS: R401.1, U1.57 (IBIAS)
/ICMP: R401.2, R402.1, U1.58 (ICMP)
/IMA: R502.2, T501.3 (PHY-), TP8.1 (1_1), U1.61 (IMA/CSB)
/IMB: R602.2, T601.3 (PHY-), TP10.1 (1_1), U1.63 (IMB)
/IPA: R501.1, T501.1 (PHY+), TP7.1 (1_1), U1.62 (IPA/SCK)
/IPB: R601.1, T601.1 (PHY+), TP9.1 (1_1), U1.64 (IPB)
/ISOA_CM: C501.1, R501.2, R502.1
/ISOA_CT: C502.1, T501.2 (PHY_CT)
/ISOA_LN: J3.2, J6.2, T501.4 (LINE-)
/ISOA_LP: J3.1, J6.1, T501.6 (LINE+)
/ISOB_CM: C601.1, R601.2, R602.1
/ISOB_CT: C602.1, T601.2 (PHY_CT)
/ISOB_LN: J4.2, J7.2, T601.4 (LINE-)
/ISOB_LP: J4.1, J7.1, T601.6 (LINE+)
/S1: R201.2, U1.37 (S1)
/S2: R202.2, U1.35 (S2)
/S3: R203.2, U1.33 (S3)
/S4: R204.2, U1.31 (S4)
/S5: R205.2, U1.29 (S5)
/S6: R206.2, U1.27 (S6)
/S7: R207.2, U1.25 (S7)
/S8: R208.2, U1.23 (S8)
/S9: R209.2, U1.21 (S9)
/S10: R210.2, U1.19 (S10)
/S11: R211.2, U1.17 (S11)
/S12: R212.2, U1.15 (S12)
/S13: R213.2, U1.13 (S13)
/S14: R214.2, U1.11 (S14)
/S15: R215.2, U1.9 (S15)
/S16: R216.2, U1.7 (S16)
/S17: R217.2, U1.5 (S17)
/S18: R218.2, U1.3 (S18)
/TAP0: F100.1, F120.1, J1.1
/TAP1: F101.1, J1.2
/TAP2: F102.1, J1.3
/TAP3: F103.1, J1.4
/TAP4: F104.1, J1.5
/TAP5: F105.1, J1.6
/TAP6: F106.1, J1.7
/TAP7: F107.1, J1.8
/TAP8: F108.1, J1.9
/TAP9: F109.1, J1.10, J5.1
/TAP10: F110.1, J5.2
/TAP11: F111.1, J5.3
/TAP12: F112.1, J5.4
/TAP13: F113.1, J5.5
/TAP14: F114.1, J5.6
/TAP15: F115.1, J5.7
/TAP16: F116.1, J5.8
/TAP17: F117.1, J5.9
/TAP18: F118.1, F119.1, J5.10
/V-: C101.2, C102.2, C103.2, C104.2, C105.2, C106.2, C107.2, C108.2, C109.2, C110.2, C111.2, C112.2, C113.2, C114.2, C115.2, C116.2, C117.2, C118.2, C301.2, C302.2, C303.2, C304.2, C305.2, C501.2, C502.2, C601.2, C602.2, C701.2, C702.2, C703.2, C704.2, D301.2 (A), F120.2, J2.2, J2.4, J2.6, R402.2, TH701.2, TP1.1 (1_1), TP2.1 (1_1), U1.43 (GPIO5), U1.44 (GPIO6), U1.45 (GPIO7), U1.46 (GPIO8), U1.47 (GPIO9), U1.52 (DTEN), U1.59 (V-), U1.60 (V-), U1.65 (V-)
/VBAT_F: D301.1 (K), F119.2, R301.1, R302.1
/VCOLL: C302.1, Q301.2 (C), R302.2, TP11.1 (1_1)
/VP_F: C301.1, R301.2, U1.1 (V+)
/VREF1: C304.1, TP4.1 (1_1), U1.51 (VREF1)
/VREF2: C305.1, R701.1, R702.1, R703.1, R704.1, TP5.1 (1_1), U1.50 (VREF2)
/VREG: C303.1, Q301.3 (E), TP3.1 (1_1), U1.48 (VREG), U1.55 (ISOMD)

Notes on the sheet:
ZENER CLAMPS D101-D118: 6.8 V from Cn_F (cathode) to C(n-1)_F, abs max 8 V per pair
TAP FUSES F100-F118: 250 mA on every cell tap, connector side (AN-2093 Fig. 11)
R201-R218: 33 ohm 1 W balance, cell n node (before 10 ohm) to Sn
CONNECTORS (JST PH)
CELL INPUTS R100-R118: 10 ohm series on C0-C18
C101-C118: 100 nF 100 V, Cn (after 10 ohm) to V-
Wired with net labels: labels with the same name are one net. TAPn = connector side of fuse F1nn, CELLn = after it. V- (chip ground) has its own fuse F120. ADBMS1818 Figure 112, isoSPI filtering per Fig. 104(B). See ../docs/slave-18s-design-basis.md.
TEST POINTS TP1-TP10 Keystone 5015 loops, TP11-TP14 bare 1.5 mm pads (HV, no loop)
THERMISTORS: 100k to VREF2 + 100 nF, GPIO1-3 cell NTC, GPIO4 onboard
isoSPI BIAS: IBIAS-1k-ICMP-1k-V-
U1 ADBMS1818 (64-LQFP_EP, EP = V-)
SUPPLY FUSES + TVS F119 top of stack, F120 V-, D301 85 V TVS after F119
MOUNTING HOLES H1-H4: M3, no copper, positions set with the board outline
isoSPI PORT A: 2x51 ohm split term + 10 nF CTs
isoSPI PORT B: 2x51 ohm split term + 10 nF CTs
SUPPLY: V+ filter, DRIVE NPN -> VREG, VREF1/2

Board: 2 copper layers, 150 parts (0 on the bottom side), 101 nets, no tracks yet.
