Focerqc/testing-BMS-designs/_tools/kicad_sch/pcb_move.py

"""Move PCB footprints by editing only their `(at x y [rot])` line in the .kicad_pcb.

Pads, text and graphics inside a footprint are stored relative to it, so a translation
needs no other change, and the diff stays one line per moved part (the MCP board tools
rewrite the whole file). Rotation is kept unless the map gives one; a new rotation is
also added to the pad and text angles (the file stores those including the footprint's).

usage: python _tools/kicad_sch/pcb_move.py MOVES.json [--variant guard|lean | --pcb FILE] [--dry]
MOVES.json: {"U1": [75, 40], "J1": [8, 5, 90], ...}   (mm, board coordinates)
Close KiCad first: an open PCB Editor will not see the change and saving from it
overwrites it.
"""
import argparse
import json
import re
import sys

from kisch import VARIANTS

AT = re.compile(r"^(\t\t\(at )([-\d.]+) ([-\d.]+)(?: ([-\d.]+))?\)(?=\r?$)", re.M)


INNER_AT = re.compile(r"^(\t\t\t\(at )([-\d.]+) ([-\d.]+)(?: ([-\d.]+))?\)(?=\r?$)", re.M)


def turn(q, delta):
    a = (float(q.group(4) or 0) + delta) % 360
    return f"{q.group(1)}{q.group(2)} {q.group(3)}{' ' + fmt(a) if a else ''})"


def fmt(v):
    return f"{round(float(v), 4):g}"


def apply_moves(text, moves):
    """Return (new text, set of refs moved). moves: {"REF": [x, y(, rot)]}."""
    starts = [m.start() for m in re.finditer(r"^\t\(footprint ", text, re.M)] + [len(text)]
    out, last, done = [], 0, set()
    for s, e in zip(starts, starts[1:]):
        block = text[s:e]
        ref = re.search(r'\(property "Reference" "([^"]+)"', block).group(1)
        if ref not in moves:
            continue
        m = AT.search(block)
        x, y, *rot = moves[ref]
        r = fmt(rot[0]) if rot else m.group(4)
        new = f"{m.group(1)}{fmt(x)} {fmt(y)}{' ' + r if r and float(r) else ''})"
        rest = block[m.end():]
        delta = (float(r or 0) - float(m.group(4) or 0)) % 360
        if delta:
            # pad and text angles in the file include the footprint's own rotation
            rest = INNER_AT.sub(lambda q: turn(q, delta), rest)
        out.append(text[last:s + m.start()] + new + rest)
        last = e
        done.add(ref)
    out.append(text[last:])
    return "".join(out), done


def main():
    ap = argparse.ArgumentParser()
    ap.add_argument("moves")
    ap.add_argument("--variant", choices=tuple(VARIANTS), default="guard",
                    help="guard = slave-18s, lean = slave-18s-lean (ignored with --pcb)")
    ap.add_argument("--pcb", default=None)
    ap.add_argument("--dry", action="store_true")
    a = ap.parse_args()
    a.pcb = a.pcb or str(VARIANTS[a.variant].with_suffix(".kicad_pcb"))
    print(a.pcb)
    moves = json.load(open(a.moves, encoding="utf-8"))
    text = open(a.pcb, encoding="utf-8", newline="").read()
    new, done = apply_moves(text, moves)
    missing = sorted(set(moves) - done)
    if missing:
        sys.exit(f"not on the board: {missing}")
    print(f"moved {len(done)} footprints" + (" (dry run)" if a.dry else ""))
    if not a.dry:
        open(a.pcb, "w", encoding="utf-8", newline="").write(new)


if __name__ == "__main__":
    main()
