Focerqc/testing-BMS-designs/(commit log)

2026-11-05 Start testing-BMS-designs: ADBMS1818 18S slave, Board Boxes dashboard, News
    - Clean-slate KiCad 10 project for the 18S slave (placeholder outline, blank sheet)
    - Design basis from ADBMS1818 Fig. 112 plus Racc's isoSPI/thermistor deviations
    - Board Boxes dashboard and GitHub Pages export carried over and made generic
    - KiCad MCP config and tips for this repo; private _reference/racc/ is gitignored
    [adbms1818-slave-18s.kicad_pcb, adbms1818-slave-18s.kicad_sch]
2026-11-05 Place all 18S slave parts unwired with footprints and JLC numbers
    - ADBMS1818 symbol from datasheet Rev. B Fig. 2 / Table 14 (65 pins,
    EP = V-), checked against the exported netlist.
    - Pulse HM2113ZNL isoSPI transformer symbol and footprint from the
    Pulse BM101.C pinout and land pattern.
    - 89 parts on the root sheet, grouped by function, with Value,
    Footprint, LCSC and MPN; connectors J1-J4 are TBD placeholders.
    - slave-18s/bom.csv in JLC format (Comment, Designator, Footprint, LCSC).
    - Site re-exported (schematic PDF, dashboard data).
    [adbms1818-slave-18s.kicad_sch, bom.csv]
2026-11-05 Design basis: pinout, part picks, Cn-to-V- cap fix, open items
    - Correct the filter cap note: 100 nF goes from Cn to V- (100 V parts),
    not C-to-S; V+ cap is 100 nF per Fig. 112.
    - Record package (LQFP-64 EP, two outlines), pin map, switch Ron,
    VREG current, NPN and transformer selection, verified LCSC table,
    connector candidates and updated open items.
    - Ignore _reference/datasheets/ (vendor PDFs stay local).
2026-11-05 C302 collector cap: 100 nF 100 V 0805 Basic (C28233)
    Per the ADBMS1818 datasheet text (100 ohm / 100 nF collector RC)
    instead of the 10 nF shown in Fig. 112. Drops Extended C282516.
    [adbms1818-slave-18s.kicad_sch, bom.csv]
2026-11-05 Connectors: JST PH, split cell taps into J1 + J5 (1x10 each)
    J1 C0-C9 and J5 C9-C18 (B10B-PH-K-S, C158038), J2 NTCs (B6B, C131342),
    J3/J4 isoSPI (B2B, C131337). BOM lines added; site re-exported.
    [adbms1818-slave-18s.kicad_sch, bom.csv]
2026-11-05 Design basis: JST PH connector pick, pinout and risks
2026-11-06 Design basis: isoSPI filtering matches datasheet Fig. 104(B), 10 nF max
2026-11-06 Schematic block 1: power, references, bias, config pins
    Net labels on pin ends for the V+ filter (R301/C301 -> VP_F), DRIVE
    regulator (R302/C302 -> VCOLL, Q301 B=DRIVE C=VCOLL E=VREG), C303-C305
    on VREG/VREF1/VREF2, IBIAS-1k-ICMP-1k-V-, ISOMD=VREG, DTEN=V-, and
    U1 59/60/65 on V-. No-connect flags on SDI, SDO, WDT and GPIO5-9.
    PWR_FLAGs on VP_F, VREG and V-.
    Q301 moved 5.08 mm right so the DRIVE label clears C305's text; the
    SUPPLY and isoSPI BIAS headings moved up one grid step.
    File re-saved with kicad-cli sch upgrade --force (KiCad's own format),
    so this diff also reformats the whole file. Netlist unchanged by the
    re-save.
    [adbms1818-slave-18s.kicad_sch]
2026-11-06 Schematic block 2: cell inputs C0-C18 and balance S1-S18
    R100-R118 (10R): CELLn -> Cn_F, U1 Cn (pin 38-2n) on Cn_F.
    C101-C118 (100n 100V): Cn_F -> V-.
    R201-R218 (33R): CELLn -> Sn, U1 Sn (pin 39-2n) on Sn.
    CELL0 is V- (R100 pin 1 labelled V-). Netlist checked: C0 = pin 38,
    C18 = pin 2, S1 = pin 37, S18 = pin 3.
    R210-R218 row moved down 5.08 mm (labels with it) so S1..S9 and
    CELL10..CELL18 no longer read as one string; U1 heading moved left
    off C101's label; CELL INPUTS heading up one step.
    [adbms1818-slave-18s.kicad_sch]
2026-11-06 Schematic block 3: isoSPI ports A and B (Fig. 104(B))
    Per port: 2 x 51R split termination IP -> ISOx_CM -> IM, 10n from
    ISOx_CM to V-, 10n from the chip-side centre tap (T pin 2) to V-.
    Transformer PHY+ (1) -> IPx, PHY- (3) -> IMx, LINE+ (6) -> Jx.1,
    LINE- (4) -> Jx.2, LINE_CT (5) no-connect. Same polarity on both ports.
    Port A: U1 62/61, T501, J3. Port B: U1 64/63, T601, J4.
    isoSPI headings moved up 5.08 mm to clear the CM/CT labels.
    [adbms1818-slave-18s.kicad_sch]
2026-11-06 Schematic block 4: thermistor inputs GPIO1-4
    R701-R704 (100k) VREF2 -> GPIO1..4, C701-C704 (100n) GPIOn -> V-.
    U1 39-42 on GPIO1..4. J2: 1/3/5 = GPIO1/2/3, 2/4/6 = V-.
    TH701 (onboard 100k NTC) GPIO4 -> V-.
    THERMISTORS heading moved up 2.54 mm to clear the labels.
    [adbms1818-slave-18s.kicad_sch]
2026-11-06 Schematic block 5: cell-tap connectors J1 and J5
    J1 pin k -> CELL(k-1): pin 1 = V- (CELL0) ... pin 10 = CELL9.
    J5 pin k -> CELL(k+8): pin 1 = CELL9 ... pin 10 = CELL18.
    Full sheet: kicad-cli ERC 0 errors, 0 warnings.
    [adbms1818-slave-18s.kicad_sch]
2026-11-06 Schematic: sheet note and date for the wired state
    The note said "Parts placed UNWIRED". It now says the sheet is wired
    with net labels and that CELL0 is the V- net. Date 2026-11-05.
    [adbms1818-slave-18s.kicad_sch]
2026-11-06 Site: re-export schematic PDF for the wired sheet
    python _tools/pcb_dashboard/export_site.py; check_hosted.cjs passes
    (snapshots, renders, schematics, browser saves, assets, News, no
    private files).
2026-11-06 Design basis: schematic wired, net names, PWR_FLAGs, check results
    Status now "schematic wired". New "Schematic nets" section lists the
    label names (CELL0 is the V- net), PWR_FLAG placement, no-connects
    and the netlist check (272/272 pins). ERC open item closed. The
    HM2113ZNL footprint and FZT853 numbering items stay open.
2026-11-06 Tools: schematic helpers in _tools/kicad_sch
    check_slave18s.py: kicad-cli netlist + ERC check of the slave against
    its wiring table (all 272 pins, NC flags, U1 1-65, one-pin nets).
    Exit 0 = pass; a negative test with one wrong label fails it.
    orient_labels.py: turns MCP batch_connect labels to face outward.
    shift_group.py: moves parts with their labels and NC flags.
    render_sch.py: PNG of the sheet or a region via kicad-cli + PyMuPDF.
    kisch.py: shared reader (symbols, pin end points, labels).
    [check_slave18s.py, kisch.py, orient_labels.py, render_sch.py, shift_group.py]
2026-11-06 AGENTS.md: KiCad MCP lessons from wiring the slave, helper scripts
    Records what broke with MCP v2.7.0 and the workarounds: labels facing
    into parts (batch_connect double-flips the outward angle), 30 s
    timeout while the worker keeps rewriting the file, whole-file
    rewrites (use kicad-cli sch upgrade --force), y-flipped fields on new
    symbols, labels left behind by moves, open Eeschema overwriting
    edits. Adds the wiring recipe that worked and lists the scripts.
    README lists _tools/kicad_sch.
2026-11-06 Tools: PCB parity check and footprint mover in _tools/kicad_sch
2026-11-06 PCB: import 90 footprints from the schematic (F8), group by block
    Parity 0, 272 pads 0 net mismatches (check_pcb_parity.py). Rough grouping
    only, no routing. 3D renders refreshed.
    [adbms1818-slave-18s.kicad_pcb]
2026-11-06 Site: re-export with the populated PCB; skip KiCad .history boards
2026-11-06 Docs: footprint checks closed, PCB import and grouping, PCB lessons
2026-11-06 PCB: move placeholder outline text off U1, refresh 3D renders
    [adbms1818-slave-18s.kicad_pcb]
2026-11-06 Board Boxes: re-fit when the stage resizes; export stable render copies for News
2026-11-06 Site: redesigned News page (status, board, parts, review asks, mascots), re-export
    [app.js]
2026-11-06 Project: net classes, HV stack and isoSPI barrier rules, 0.2 mm min hole
    make_rules.py writes six net classes into the .kicad_pro (JSON
    read-modify-write) and generates the .kicad_dru from the board's nets:
    0.6 mm between nets two or more 3-tap banks apart (IPC-2221B B2
    31-150 V), 2.0 mm clearance/creepage around each isoSPI line side, and
    the datasheet p. 86 courtyard rules for T501/J3 and T601/J4. Board
    minimums: clearance 0.16 mm (JLC 2 oz), hole 0.2 mm (U1 thermal vias).
    --check confirms kicad-cli loads the rules with a canary.
    DRC: 16 drill_out_of_range -> 0, no new items; parity 0.
    [make_rules.py]
2026-11-06 Docs: net classes and clearance rules with sources, U1 thermal-via decision
    Design basis: track width basis per class, IPC-2221B B2 rows used,
    stack banks, isoSPI barrier reasoning, JLC via limits (2026-11-06),
    DRC before/after. AGENTS.md: make_rules.py and the silent .kicad_dru
    failure mode.
2026-11-06 Schematic: hot-plug protection, test points, mounting holes
    - F100-F118 250 mA tap fuses (TAPn -> CELLn), F119/F120 supply branch fuses
    (TAP18 -> VBAT_F, TAP0 -> V-), per AN-2093 Fig. 11
    - D101-D118 6.8 V zeners Cn_F -> C(n-1)_F (abs max 8 V, Table 11)
    - D301 SMAJ85A TVS VBAT_F -> V- after F119
    - R100-R118 to 1206 (Fig. 99: balance current returns through them)
    - TP1-TP10 Keystone 5015 loops, TP11-TP14 bare pads on HV nets, H1-H4 M3
    - Sheet widened to 594 x 297 for the new section
    - check_slave18s.py: block 6 and the TAP/CELL0/VBAT_F nets; 366 pins, ERC 0/0
    [adbms1818-slave-18s.kicad_sch]
2026-11-06 PCB: protection parts and test points imported (F8), grouped; hole keep-out rule
    - F8 import: 148 footprints, 366 pads, 0 parity items (check_pcb_parity.py PASS)
    - R100-R118 rows respaced to 5 mm for the 1206 footprints; C1xx and the
    zeners D101-D118 aligned under them; fuses F100-F120 and D301 below
    - TP1-TP10 loops along the bottom edge, TP11-TP14 HV pads beside Q301,
    H1-H4 at three corners and the right edge (placeholder positions)
    - 0 courtyard overlaps, 0 clearance/creepage errors; DRC left: 256 unrouted,
    61 silk_overlap + 80 silk_over_copper warnings
    - make_rules.py: rules regenerated for TAP*/CELL0/VBAT_F; new 2.9 mm
    hole_clearance keep-out around H1-H4 (tested: fires on a cop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
    [adbms1818-slave-18s.kicad_pcb, bom.csv]
2026-11-06 Docs: protection and test points, corrected balance current, placement checklist
    - Design basis: deviations 7-11 (tap and supply fuses, zener clamps, TVS,
    R1xx in 1206, test points and holes) with datasheet/AN-2093 sources; new
    "Protection and test points" and "Placement checklist" sections; nets
    TAP*/CELL0/VBAT_F; parts table; PCB check 148 footprints, 366 pads
    - Balance current corrected to ~89 mA (Fig. 99 path includes the 10 ohm),
    0.26 W per 33 ohm, ~6.7 W total; firmware DCP and 80 mA notes
    - AGENTS.md: lessons from adding the parts; helper table updated
2026-11-06 Site: News for protection and test points, fresh 3D renders, re-export
    - News: hero, stats (148 parts, 366/366 pins), timeline (Nov 6 rules done,
    protection added, placement now), board-today legend and status,
    hot-plug protection part row, corrected balance current (~89 mA)
    - 3D top/iso re-rendered with render_board_3d(); export_site.py re-run;
    check_hosted.cjs passes (no private files). Cows and penguins untouched.
2026-11-07 Docs: ENNOID firmware supports the ADBMS1818 as LTC6813-1; GPIO5-9 float
    The public ENNOID-BMS-Firmware LTC6813-1 driver sends only command codes
    that match ADBMS1818 Table 52. It writes GPIO1-9 pull-downs off, so the
    unused GPIO5-9 would float: propose tying them to V-. NTC count 4 reads
    GPIO1-4. Firmware binary kept locally under _reference/firmware/ (gitignored).
2026-11-07 Schematic: J3/J4 JST GH 2P, J3B/J4B JST PH 2P alternates (DNP), GPIO5-9 to V-
    - J3/J4: Conn_01x02_MountingPin, JST SM02B-GHS-TB(LF)(SN) (C189893), stock
    KiCad footprint JST_GH_SM02B-GHS-TB_1x02-1MP; MP (hold-down tabs) no-connect
    - J3B/J4B: JST B2B-PH-K-S (C131337), DNP, pins on the same ISOx_LP/LN nets
    - U1 GPIO5-9 tied to V-: the ENNOID firmware leaves the internal pull-downs off
    - ERC pin map: bidirectional <-> power output = OK (GPIO5-9 on V-, PWR_FLAG)
    - check_slave18s.py: new pins; 365 pin->net rows + 7 no-connects, 0 problems,
    ERC 0 errors 0 warnings
    [adbms1818-slave-18s.kicad_sch]
2026-11-07 Schematic: rename J3B/J4B to J6/J7 (KiCad needs a trailing number to annotate)
    check_slave18s.py: 0 problems, ERC 0 errors 0 warnings.
    [adbms1818-slave-18s.kicad_sch]
2026-11-07 PCB: J3/J4 JST GH 2P and J6/J7 PH alternates imported (F8); rules for GH tabs
    - F8: 150 footprints, 372 numbered pads, 0 mismatches, 0 parity items
    (check_pcb_parity.py PASS)
    - check_pcb_parity.py: a no-connect pin with two pads (GH MP tabs) gets one
    unconnected net per pad (X, X_1); compare them as one
    - make_rules.py: GH tabs (unconnected-(J3/J4-...)) count as isoSPI line side;
    J6/J7 inside the no-pour / only-isoSPI courtyard rules. --check OK
    - bom.csv: J3/J4 SM02B-GHS-TB C189893; J6/J7 DNP, not in the BOM
    - DRC: 0 errors (the 4 clearance/creepage hits on the GH tabs are gone with
    the rules); placement of J3/J4/J6/J7 follows in the next commit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
    [adbms1818-slave-18s.kicad_pcb, bom.csv]
2026-11-07 PCB: connector row centred on the top edge, transformers at their ports, 4 corner holes
    - Top row, centred on x = 60 (courtyards 12.5-107.5): J3 GH (IN) + J6 PH |
    J1 | J5 | J2 | J7 PH + J4 GH (OUT). GH turned 180 so the plug enters from
    the top edge. J1 pin 10 to J5 pin 1: 5.5 mm. Silk "IN" / "OUT"
    - T501 / T601 turned 90 (line side up) under their connectors, line pads
    about 5 mm from the connector pads; R5xx/C5xx and R6xx/C6xx under them
    - Balance resistors R201-R218 shifted right to x 29.5-74.5; NTC parts
    (R70x, C70x, TH701) moved beside U1, away from the balance resistors
    - H4 to the top-left corner: holes at (3.5, 3.5), (116.5, 3.5), (3.5, 66.5),
    (116.5, 66.5). Right edge empt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
    [adbms1818-slave-18s.kicad_pcb]
2026-11-07 Docs: connector row, transformers and corner holes placed; GH/PH connector notes in PCB and checklist
2026-11-07 Site: News for the GH isoSPI connectors, firmware check and connector row; fresh 3D renders, re-export
    - News: hero and stats (150 parts, 372/372 pins), timeline (firmware checked,
    isoSPI on JST GH + connector row placed), board legend and honest status
    (265 unrouted, port A 5 cm from U1), new J3/J4 GH part row, isoSPI review item;
    fixed the connector-section link after the heading rename
    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
2026-11-07 Schematic: J3/J4 to vertical JST GH 2P BM02B-GHS-TBT (C161690)
    Footprint JST_GH_BM02B-GHS-TBT_1x02-1MP_P1.25mm_Vertical (pads checked
    against JST eGH.pdf p. 2 top-entry land pattern), LCSC, MPN, description.
    check_slave18s.py: 372/372 pins, 0 problems, ERC 0/0.
    [adbms1818-slave-18s.kicad_sch]
2026-11-07 Docs: J3/J4 vertical JST GH BM02B-GHS-TBT (C161690), footprint checked against eGH p. 2
    Deviation 12, parts table, connector notes (stock thin: LCSC 130), master doc row.
2026-11-07 PCB: J3/J4 vertical JST GH BM02B-GHS-TBT imported (F8), BOM C161690
    Same positions for now. check_pcb_parity.py PASS (150/150, 372 pads, 0 mismatches),
    make_rules.py --check OK, DRC 0 errors, 0 courtyard overlaps, all inside the outline.
    [adbms1818-slave-18s.kicad_pcb, bom.csv]
2026-11-07 PCB: isoSPI ports on the right edge next to U1 (U1 at 270 deg)
    U1 turned 270 so pins 61-64 face right. Port B (OUT: T601/J4/J7) upper, port A
    (IN: T501/J3/J6) lower, so the PHY pairs don't cross. Connector to transformer ~3.4 mm,
    transformer chip pads ~1.5 cm from U1 pins. NTC parts moved below U1. U1 3D model
    linked to KiCad's LQFP-64 EP6.5 body (same package outline).
    Parity PASS, rules OK, DRC 0 errors, 0 courtyard overlaps.
    [adbms1818-slave-18s.kicad_pcb]
2026-11-07 PCB: Pulse HM2113ZNL STEP model on T501/T601 and library footprint
    Manufacturer STEP (ZNL = ZNLT body; ZNLT link 404s). Rotation -90 0 -90,
    pin-1 dot on pad 1, body centred, sits on the board. Parity PASS.
    [HM2113ZNL_3D.STEP, adbms1818-slave-18s.kicad_pcb]
2026-11-07 PCB: fresh 3D renders with HM2113ZNL models on T501/T601
2026-11-07 PCB: lift HM2113ZNL model 3.25 mm onto the board (was sunk), re-render
    [adbms1818-slave-18s.kicad_pcb]
2026-11-07 Dashboard: group labels outside the board edge with dashed leaders, spread to avoid overlap
    [app.js]
2026-11-07 Dashboard: group names in the nearest free spot by their box (avoids parts, silk text, other names); edge callout only as fallback
    [app.js]
2026-11-07 Schematic: add 18S Lean variant (no hot-plug protection), generated from Guard
    slave-18s-lean/ drops the tap and supply fuses (F100-F120), zener clamps
    (D101-D118), the V+ TVS (D301) and the C-pin filter caps (C101-C118).
    make_lean.py derives its schematic from slave-18s; check_slave18s.py gains
    --variant lean. Both variants: 0 netlist problems, 0 ERC. The Lean PCB is a
    copy of Guard's board and still needs Update PCB (F8) in KiCad.
    [adbms1818-slave-18s-lean.kicad_pcb, adbms1818-slave-18s-lean.kicad_sch]
2026-11-07 Tools: --variant guard|lean for make_rules, pcb_move and check_pcb_parity; front-side check
    kisch.py holds the variant -> schematic map (the .kicad_pcb/.kicad_pro/.kicad_dru sit
    next to it). make_rules.py was hard-wired to Guard; it now writes and checks Lean's
    rules with --variant lean. check_pcb_parity.py and pcb_move.py keep --sch/--pcb and
    gain --variant as a shortcut. check_pcb_parity.py also fails if any footprint is not
    on F.Cu (the slave is single-sided so it can sit flat on a carrier).
    Guard: parity PASS (150 footprints, all on F.Cu), make_rules --check OK. Lean fails
    parity until F8 is run on its board.
    [check_pcb_parity.py, kisch.py, make_rules.py, pcb_move.py]
2026-11-07 Schematic (Lean): net tie NT1 replaces F120, so CELL0 stays its own net
    make_lean.py no longer merges CELL0 into V-. F120 (V- supply fuse) becomes NT1
    (Device:NetTie_2, NetTie-2_SMD_Pad0.5mm, not in the BOM) at the same spot, with the
    two labels moved onto its pins. On the PCB, NT1 sits next to J1.1 and is the only
    place CELL0 (J1.1, R100: the C0 sense) may touch V-, so DRC flags supply current
    sharing the sense trace as a short.
    check_slave18s.py --variant lean: 251 pin rows + 7 no-connects, 0 problems, ERC 0/0.
    Guard unchanged (365 rows, 0 problems, ERC 0/0). make_lean.py output is reproducible.
    [adbms1818-slave-18s-lean.kicad_sch]
2026-11-07 Docs: 18S Lean layout plan, net tie NT1, --variant options
    docs/slave-18s-lean-layout-plan.md: step-by-step placement and routing plan for the
    Lean PCB (channel L around U1, one channel then a script-generated repeat, C0 sense
    via NT1, 2-layer routing rules, checkpoints, later shrink pass). Design basis
    "Variants": CELL0 and NT1. AGENTS.md helper table: --variant and the front-side
    check. README links the plan.
2026-11-07 PCB (Lean): F8 drops the protection parts and adds net tie NT1; Lean's own rules
    Update PCB (F8) in KiCad applied the net changes (J1.1 and R100.1 on CELL0, tap pins
    on CELLn) and added NT1. F8's "Delete footprints with no symbols" was off (KiCad's
    default), so the 58 removed parts (F100-F120, D101-D118, D301, C101-C118) were
    deleted from the unrouted board file afterwards; no tracks, zones or groups referred
    to them. Line endings back to LF (KiCad had saved CRLF).
    make_rules.py --variant lean: .kicad_dru regenerated from Lean's 90 nets (Guard's
    copy listed TAPn and VBAT_F), --check OK (canary fires).
    check_pcb_parity.py --variant lean: 93/93 footprints, 258 pads, 0 mismatches, all on
    F.Cu,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
    [adbms1818-slave-18s-lean.kicad_pcb]
2026-11-07 Docs: Lean step 0 done; F8's "Delete footprints with no symbols" is off by default
2026-11-07 PCB (Lean): NT1 beside J1.1, fixed parts locked
    NT1 at (27.2, 5) rotated 180: CELL0 pad (27.7, 5) faces J1.1 (31, 5), V- pad on the
    outside, clear of J1's courtyard (x >= 28.5). Locked J1-J7, T501, T601, U1, H1-H4 and
    NT1 (placement step 1 of docs/slave-18s-lean-layout-plan.md).
    check_pcb_parity.py --variant lean: PASS. DRC: 0 errors.
    [adbms1818-slave-18s-lean.kicad_pcb]
2026-11-07 PCB (Lean): step 2, park the 78 unlocked parts in a staging grid below the board
    pcb_move.py --variant lean, one line per part, rotations kept. Rows from y = 78 mm
    (8 mm below the outline), numeric order, 2 mm between courtyards: balance R201-R218
    (2 x 9), cell series R100-R118 (2 rows), supply (Q301, R301/C301, R302/C302,
    C303-C305, R401/R402), isoSPI A then B, NTC pairs + TH701, TP1-TP10 then TP11-TP14.
    The 15 locked parts (connectors, T501/T601, U1, H1-H4, NT1) are unchanged.
    Checks: 0 courtyard overlaps (pcbnew courtyard boxes, all 93), check_pcb_parity.py
    --variant lean PASS, DRC 0 errors (2 silk_edge_clearance, 171 unconnected).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
    [adbms1818-slave-18s-lean.kicad_pcb]
2026-11-07 Dashboard: layout practice card (channel-L boxes + step guide), Save/Open .txt, 2512 chip
    - "Lay out the 18-channel L" draws R2xx/R1xx boxes as linked patterns from U1's
    /Sn pads (layout plan steps 3-4): top arm ch 18 down, left arm the rest + R100.
    Pitch, top-arm count and R2 package are inputs; pressing again replaces the L.
    - Pattern boxes carry part labels (R218 ...), kept when broken out, and listed
    in Copy Prompt.
    - Step guide for plan steps 3-7 with ticks saved in the boxes doc.
    - Save .txt / Open .txt: download and reload a board's boxes as plain text, so
    work done on the hosted site can be carried back.
    [app.js]
2026-11-07 Render (Lean): top-down 3D of the board area
    Rendered from a temporary copy without the 78 staged parts, so the image
    matches the 120 x 70 outline the dashboard stretches it over.
2026-11-07 Site: re-export with the Lean board and the layout practice card
2026-11-07 Dashboard: open on 18S Lean, plain board names, practice card only on Lean
    The hosted site opened on Guard (first in the list), and the L button drew
    Lean's plan over Guard's old placement. Now a first visit opens on Lean, the
    menu says "18S Lean · layout practice" / "18S Guard · full protection", and on
    Guard the card only says to pick Lean.
2026-11-07 Site: re-export (opens on 18S Lean, board names, card only on Lean)
2026-11-08 Dashboard: practice card lays out one staggered row; draw Dwgs.User lines
    The layout-practice button now draws the 18 channels as one straight row
    under J1/J5 (R1 row half a pitch right of the R2 row, in U1 pin order)
    instead of an L around U1. Defaults: pitch 4.2 mm, balance row outer,
    with an "Outer row: 10 ohm" option for Racc's order.
    kicad_bridge.py reads lines and text on Dwgs.User, and the board view
    draws them dashed with their labels (the XR slot overlay).
2026-11-08 PCB (Lean): XR slot overlay (long-term) on Dwgs.User
    Planning outline only, grouped as "XR slot overlay (long-term)". No
    footprints, copper or nets changed.
    [adbms1818-slave-18s-lean.kicad_pcb]
2026-11-08 Docs: Lean layout plan steps 3-4 use one staggered row
    Channel 14 done properly (balance outer, 10 ohm inner half a pitch right,
    pitch 4.2 mm from the 2512 envelope), then the 18-channel row placed by
    script. Notes that Racc's 12S board puts the 10 ohm on the plug side.
2026-11-08 Site: re-export (practice row, XR slot overlay)
2026-11-08 Docs: drop the done board-name item; hosted-site saving is its own bullet
2026-11-08 Tools: Lean part swaps, lean_place.py trial placement, pcb_move.apply_moves
    make_lean.py: Lean-only part swaps (SWAP table; the Guard value must match):
    R201-R218 33 ohm 2512 -> 2010 (UNI-ROYAL 201007F330JT4E, C421858) and
    T501/T601 Pulse HM2113ZNL -> Bourns SM91502AL (C915690), same pin functions.
    lean_place.py: places the whole Lean board from a few knobs (outline W x H,
    pitch, row shift, tap/fan gaps, U1 x, isoSPI port spots), by courtyard centre,
    then reports courtyard overlaps and parts off the outline; --drc runs
    kicad-cli DRC. pcbnew only reads; the file is edited as text like pcb_move.py.
    pcb_move.py: the text edit is now apply_moves(), reused by lean_place.py.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
    [lean_place.py, make_lean.py, pcb_move.py]
2026-11-08 Schematic (Lean): 2010 balance resistors, Bourns SM91502AL isoSPI transformers
    Regenerated by make_lean.py. New footprint slave18s:Bourns_SM91502AL drawn
    from the Bourns datasheet (rev. 07/25) recommended layout: pads 0.76 x 1.27,
    2.54 pitch, rows 7.11/9.65 mm, pins 1-2-3 down the left column like the
    HM2113ZNL footprint. check_slave18s --variant lean: 0 problems, ERC clean.
    [adbms1818-slave-18s-lean.kicad_sch]
2026-11-08 PCB (Lean): F8 part swaps; try 1 at 70 x 50 mm from lean_place.py
    F8 swapped R201-R218 to 2010 and T501/T601 to SM91502AL (both were unlocked
    for it). Outline 70 x 50; J1/J5 centred on the top edge, J2 on the right edge,
    the 18-channel row at 3.3 mm pitch (61.8 mm), U1 under it, isoSPI port B
    right of U1. Port A (T501, J3, J6, R501/R502, C501/C502) is parked right of
    the board: it doesn't fit at 50 mm. 0 courtyard overlaps; parity PASS; DRC
    only silk warnings and unrouted nets.
    [adbms1818-slave-18s-lean.kicad_pcb]
2026-11-08 Docs: Lean shrink trial (70 x 50, 2010 R2s, SM91502AL); lean_place.py; F8 skips locked parts
    Design basis: Lean variant rows and the reasons for both swaps (pitch 3.3 mm,
    0.26 W of 0.75 W; SM91502AL with choke, 1000 VDC working, rejected LAN parts).
    Layout plan: the shrink trial and where the 120 x 70 plan lives now.
    AGENTS.md: lean_place.py in the helper table; lessons from the first F8 and
    the parts database.
2026-11-08 Site: News for the Lean shrink (70 x 50 try 1, 2010 R2s, SM91502AL), re-export
    News: Nov 8 update. Hero and "The board today" show 18S Lean try 1 at
    70 x 50 mm; timeline adds the Lean variant, the layout practice row and the
    shrink; parts list adds the Lean swaps (Guard rows labelled); review asks
    updated for a small board (Q301 heat, balancing heat, where port A goes);
    the stale side-entry GH text fixed. Re-exported without the local practice
    boxes; check_hosted passes.
2026-11-08 Dashboard: top render lines up with parked parts; practice card for the shrink trial
    The top render is cropped to everything opaque, which includes parts that
    lean_place.py parks off the outline (try 1: isoSPI port A). Stretching that
    onto the board outline squashed the Lean render sideways. Find the board in
    the image instead (long unbroken opaque runs), map that onto the outline and
    draw the rest around it at the same scale.
    The layout practice card follows the shrink trial: seven steps (read the try,
    ch 14, the row, supply parts at their pins, port A onto the board, toward
    35 mm, route ch 14 and C0), each with a check measured from the board. The
    row tool previews another pitch, R2 packa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
2026-11-08 Dashboard: site export stamps content hashes on script, style and render URLs
    The live site kept running the old app.js after the render fix was
    published: index.html loaded app.js?v=full-schematic1, the same URL as
    before, and Pages lets browsers cache it for 10 minutes. The Lean render
    was drawn by the pre-fix code, squeezed onto the outline with its parked
    parts.
    export_site.py now writes style.css, hosted.js and app.js into index.html
    as name?v=<sha256 of the published file>, so every change is a new URL.
    Render images in data/ are named by content instead of path, and images
    no longer used are removed. check_hosted.cjs fails if a stamp doesn't
    match its file.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
2026-11-08 Site: re-export with content-hashed script, style and render URLs
    hosted.js asks Pages each load whether dashboard.json changed, so the
    board snapshot is never older than app.js.
2026-11-10 Tools: Lean drops the PH alternates J6/J7; lean_place.py puts both isoSPI ports on the board
    make_lean.py removes J6/J7 (both ports only fit the 70 mm board without them),
    check_slave18s.py and make_rules.py follow. lean_place.py places each port as one
    strip right of U1 (R/C column, transformer, GH plug), port A under port B.
2026-11-10 Schematic (Lean): regenerate without the PH alternates J6/J7
    [adbms1818-slave-18s-lean.kicad_sch]
2026-11-10 PCB (Lean): shrink try 2, both isoSPI ports on the 70 x 50 board, J6/J7 removed
    91 footprints, nothing parked. Parity PASS, rules regenerated, no clearance errors.
    [adbms1818-slave-18s-lean.kicad_pcb]
2026-11-10 Docs: Lean shrink try 2 (J6/J7 removed, both isoSPI ports on the board, height budget)
2026-11-10 Tools: Lean test points become bare pads on the back; dashboard shows the back
    make_lean.py swaps TP1-TP10 to the TP11 pad, flip_back.py moves footprints to B.Cu
    by splicing only their blocks, lean_place.py runs it, the parity check expects Lean's
    TP<n> on B.Cu, and Board Boxes gets a Bottom view with its own mirrored 3D render.
    [app.js, check_pcb_parity.py, flip_back.py, lean_place.py, make_lean.py]
2026-11-10 Schematic (Lean): TP1-TP10 are bare pads, like TP11-TP14
    [adbms1818-slave-18s-lean.kicad_sch]
2026-11-10 PCB (Lean): all test points are bare pads on the back; rules and renders refreshed
    [adbms1818-slave-18s-lean.kicad_pcb]
2026-11-10 Dashboard: practice card and part notes describe Lean try 2
    Both isoSPI ports beside U1, test pads on the back, the 41.5 mm height budget.
    Text only, plus J6 dropped from the port A list.
2026-11-10 Site: News for Lean try 2 and the back test pads, re-export with the bottom render
    News: both isoSPI ports on the 70 x 50 board, J6/J7 Guard only, TP1-TP14 bare
    pads on the back (front and back pictures), transformer distance and height as
    the open items. Re-exported without the local practice boxes; check_hosted passes.
2026-11-10 Site: News for the try 3 plan (120 ohm 1206, 0603 series, M2, 4 layers, no test points)
2026-11-10 Tools: make_lean.py try 3 parts (120 ohm 1206, 10 ohm 0603, M2 holes, no test points)
2026-11-10 Schematic (Lean): try 3 parts, 77 footprints (regenerated by make_lean.py)
    Netlist and ERC check pass. The Lean PCB still needs F8.
    [adbms1818-slave-18s-lean.kicad_sch]
2026-11-10 Docs: try 3 decisions for Lean (balance value, sizes, holes, layers, no test points)
2026-11-10 Tools: lean_place.py try 3 floorplan (70 x 37); make_rules.py hole keep-out per variant (M2 on Lean)
2026-11-10 PCB (Lean): try 3 placed at 70 x 37, 77 footprints, M2 holes, no test pads
    Parity PASS, 0 courtyard overlaps, rules regenerated. Not routed.
    [adbms1818-slave-18s-lean.kicad_pcb]
2026-11-11 PCB (Lean): your placement edits - J2 on the left edge, U1 up, isoSPI ports down; H3 back in its corner
    Saved from KiCad by the user (H3 had been deleted); H3 restored from the previous commit at the
    top-right corner and both isoSPI ports nudged 0.6 mm down to clear it. Parity PASS, 0 courtyard
    overlaps. Not routed.
    [adbms1818-slave-18s-lean.kicad_pcb]
2026-11-11 Tools: lean_place.py try 3b floorplan (user's connector spots, rest placed for routing)
2026-11-11 PCB (Lean): try 3b placement - connectors kept, U1 centred under ch 11-18, supply at its pins
    Parity PASS, 0 courtyard overlaps, rules OK. Not routed.
    [adbms1818-slave-18s-lean.kicad_pcb]
2026-11-11 Tools: make_lean.py swaps R302 to 1 kohm 2512 on Lean (takes about 0.5 W off Q301)
    [make_lean.py]
2026-11-11 Schematic (Lean): R302 100 ohm 0805 -> 1 kohm 2512 1 W, C54315 (regenerated by make_lean.py)
    [adbms1818-slave-18s-lean.kicad_sch]
2026-11-11 PCB (Lean): F8 for R302 (2512) and your placement sketch - U1 near the middle, Q301 and R302 right of it
    [adbms1818-slave-18s-lean.kicad_pcb]
2026-11-11 Tools: lean_place.py try 3c - U1 5.5 mm further left, V+ filter lying at pin 1, R302 right of Q301
2026-11-11 PCB (Lean): try 3c - 4 copper layers, U1 at x 37, Q301 + R302 right of it, VCOLL zones on all layers with 43 vias
    [adbms1818-slave-18s-lean.kicad_pcb]
2026-11-11 Tools: make_lean.py swaps R100-R118 to 0402 on Lean (try 4, 70 x 32)
    [make_lean.py]
2026-11-11 Schematic (Lean): R100-R118 10 ohm 0603 -> 0402, C25077 (regenerated by make_lean.py)
    [adbms1818-slave-18s-lean.kicad_sch]
2026-11-11 Tools: lean_place.py try 4 floorplan (70 x 32): 0402 series row lying, U1 1.3 mm from the bottom edge, Q301 standing, one VCOLL zone on four layers
2026-11-11 PCB (Lean): try 4 placed at 70 x 32 - F8 for the 0402 series resistors, U1 at the bottom edge, Q301 standing, VCOLL zone on four layers
    [adbms1818-slave-18s-lean.kicad_pcb]
2026-11-11 Docs: Lean try 4 (70 x 32, 0402 series resistors) and what its routing still has to prove
2026-11-11 Tools: lean_route.py - scripted routing of the ch 11-18 fan-in and U1's bottom pins on Lean try 4
2026-11-11 PCB (Lean): first routing on try 4 - ch 11-18 fan-in (F + In1), U1 bottom pins (via row + In2), V+ filter, VREG; 29 nets, DRC clean
    [adbms1818-slave-18s-lean.kicad_pcb]
2026-11-11 Docs: first routing on Lean try 4 (fan-in on F + In1, bottom pins through a via row and In2) and how lean_route.py works
2026-11-11 PCB (Lean): 3D renders of try 4 with the first routing
2026-11-11 Site: re-export for Lean try 4 (snapshot, renders, schematic PDFs, dashboard without the practice card), News with the 3D render
2026-11-11 Dashboard: In1.Cu and In2.Cu buttons so inner-layer traces can be seen
2026-11-11 PCB (Lean): slot overlay with the slave on the slot's bottom edge, carrier connectors in the 5 mm above
    [adbms1818-slave-18s-lean.kicad_pcb]
2026-11-11 Docs: slave sits on the slot's bottom edge; Board Boxes shows inner layers
2026-11-11 Site: re-export with inner-layer copper buttons and the corrected slot overlay
    [app.js]
2026-11-11 Tools: lean_route.py routes the ch 3-10 bus on the front and S11 on In1
    Pins 32-24 nest inside S3/C2_F and turn left, S8/C8_F go straight up, pins
    21-18 turn right (outer lane highest). S11 cannot pass C10_F/S10/C11_F on the
    front, so it drops to a via inside the pin row and crosses on In1.
2026-11-11 PCB (Lean): ch 3-10 bus on the front, S11 on In1
    16 more nets; DRC with zones filled has no copper errors, unconnected 112 -> 96.
    [adbms1818-slave-18s-lean.kicad_pcb]
2026-11-11 Tools: lean_route.py routes the taps from the plugs to the resistor rows
2026-11-11 PCB (Lean): taps from J1/J5 to the R2 and R1 rows, CELL0 to R100 and NT1
    19 nets on the front; DRC with zones filled has no copper errors, unconnected 96 -> 57.
    [adbms1818-slave-18s-lean.kicad_pcb]
2026-11-12 Tools: lean_route.py routes VREG, DRIVE, Q301 pin 2 and CELL18 to R302
    VREG runs under Q301's body 0.6 mm from the VCOLL vias and through the column
    gap to C303; pin 55 joins it through In1. DRIVE hops over VREG on In1. CELL18
    reaches R302 on In2 under T601's courtyard and between the VCOLL via rows.
    lean_route only replaces its own 0.5 mm VCOLL vias, not lean_place's stitching.
    [lean_route.py]
2026-11-12 PCB (Lean): VREG, DRIVE, Q301 pin 2 via and CELL18 to R302
    DRC with zones filled has no copper errors; unconnected 57 -> 53.
    [adbms1818-slave-18s-lean.kicad_pcb]
2026-11-12 PCB (Lean): both isoSPI ports, chip side and line side
    DRC with zones filled: no copper or courtyard-rule errors (two V- vias dangle
    until the V- pour); unconnected 53 -> 33.
    [adbms1818-slave-18s-lean.kicad_pcb]
2026-11-12 Tools: lean_route.py routes VREF1/VREF2, IBIAS/ICMP and the rest of the NTC wiring
    VREF2 crosses to the NTC parts on In1 under U1's bottom-pin via row and feeds
    R701-R704 along the channels between the part rows. GPIO2 runs down the left
    edge on the front and to R702 on In1, GPIO3 down the edge on In2, GPIO4 to
    TH701 under the bottom row.
2026-11-12 PCB (Lean): VREF/bias parts and the NTC wiring
    Every net but V- is routed. DRC with zones filled: no copper errors (two V-
    vias dangle until the pour); unconnected 33 -> 20, all V-.
    [adbms1818-slave-18s-lean.kicad_pcb]
2026-11-12 Tools: lean_route.py adds the V- pour on B.Cu and a via at every V- pad
    The pour is notched round the isoSPI ports and yields to the VCOLL zone. The
    termination-row strip joins the rest through an In1 track to the R402 via.
    lean_route now owns every V- track and 0.5 mm V- via, and writes zones by name.
2026-11-12 PCB (Lean): V- pour on B.Cu, every net connected
    DRC with zones filled: 0 unconnected, no copper errors (silkscreen only).
    The zone is written unfilled; KiCad fills it when the board is opened.
    [adbms1818-slave-18s-lean.kicad_pcb]
2026-11-12 PCB (Lean): 3D renders of the fully routed board (zones filled)
2026-11-12 Site: News for the fully routed Lean board, re-export with new renders
    Copper plot of every layer but the back pour, timeline entry for the routing
    and the B.Cu V- pour, review items for the C0 line and port A's isoSPI length.
2026-11-12 PCB (Lean): VCOLL range rule and CELL18 lane clear of the VCOLL vias
    make_rules.py models VCOLL as stack minus 0-35.35 V (R302 1 kohm +1%, 35 mA)
    and adds a 0.6 mm rule against every net whose voltage difference can exceed
    30 V at either endpoint. Guard's 100 ohm R302 keeps its generated rules.
    lean_place.py: stitching vias next to R302's CELL18 pad and in the CELL18 lane
    removed (31 -> 25); lean_route.py: CELL18 lane moved from y 27.6 to 27.8.
    Checks: check_slave18s --variant lean passes, check_pcb_parity passes, rules
    --check OK for both variants, filled-zone DRC 0 unconnected, no copper errors.
    [adbms1818-slave-18s-lean.kicad_pcb]
2026-11-12 Docs: correct VCOLL bank model and the 2 cm isoSPI limit
    Dated corrections (2026-11-11): VCOLL range and the Lean range rule; p. 86's
    2 cm limit is transformer-to-connector, not chip-side length; C0_F carries
    balancing return; 0402 balance-series parts; trace fuses deferred (no fuse
    protection designed); open items for regulator thermal, U1 exposed-pad
    assembly and isoSPI foreign crossings. AGENTS.md: scratch-check pitfalls.
2026-11-12 Site: Review items for isoSPI crossings, regulator heat and U1 pad vias
2026-11-12 Tools: isoSPI shield crossing check and CELL18 detour probe (read-only)
2026-11-12 Site: news timeline newest first, five shown with expand
    The progress timeline now opens with the latest change, then the four
    before it. A button shows the full history and collapses it again. Now
    and Later stay below the list.
2026-11-12 Site: news timeline shows latest change and a half-visible second card
    The latest change opens in full, with the top half of the card before it
    showing under a fade. A button shows the full history and collapses it
    again. The first 16 hidden entries are now visible in the list, so the
    height limit does the cutting.
2026-11-12 Tools: Board Boxes part notes in Info and a Super info pad inspector
    Info now shows each part's purpose and possible open issues, from
    part_notes.json (Lean and Guard lists plus a shared list, matched by
    reference). The server and the site export add the notes to each board.
    Super info is a new toggle: click any single pad to see its net, what
    kind of net it is, whether it is ground (V-), and every other pad on
    that net. The selected pad is orange and its net's pads cyan.
    [app.js]
2026-11-12 Site: export Board Boxes with part notes and Super info
    Re-ran export_site.py so the published snapshot carries each part's
    purpose and possible issues (Guard 150, Lean 77) and the Super info pad
    inspector. check_hosted.cjs passes.
    [app.js]
2026-11-12 Tools: Super info active state, net pulse and Full length path
    The Super info button now shows when it is on. Clicking a pad dims the
    board and lights that net's traces, vias and pads; Pulse (on by default)
    runs a wave outward from the clicked pad along the copper. Full length
    (off by default) follows the net through series parts (R, F, L, FB, NT)
    and stops at ground, big rails and nets that reach the chip.
2026-11-12 Site: export Board Boxes with Super info pulse and Full length
2026-11-12 Ignore local third-party reference boards
2026-11-13 Schematic (Lean): J5 10-pin -> 9-pin PH, C10-C18; CELL9 on J1 only (regenerated by make_lean.py)
    J5 becomes B9B-PH-K-S (C157968) so the two cell plugs differ, and C9 comes
    in on one wire. Checker wiring table follows. ERC 0/0, 239 pins.
    [adbms1818-slave-18s-lean.kicad_sch]
2026-11-13 PCB (Lean): 9-pin J5 placed and routed, CELL9 from J1 only
    C10-C18 keep their positions; J5 sits 2 mm further right. Parity PASS,
    filled-zone DRC 0 unconnected, only the 153 existing silk warnings.
    [adbms1818-slave-18s-lean.kicad_pcb]
2026-11-13 Docs: cell plugs PH 10 + 9, single CELL9 wire, isoSPI crossings to be rerouted
2026-11-13 isoSPI check: group each port's chip-side pair with its own nets
    Port A is IPA, IMA and ISOA_*; port B is IPB, IMB and ISOB_*. Before,
    IPA/IMA/IPB/IMB were not port nets: they counted as foreign to their own
    port's centre tap and termination midpoint (two false crossings), and
    were never checked as isoSPI lines themselves. ISOx_CT and ISOx_CM are
    AC-grounded nodes of the same pair, so the port's own lines crossing them
    inject no outside signal (datasheet p. 86 bans other traces crossing the
    isoSPI lines). Also de-duplicate a pair found from both sides.
    Lean now reports 20 crossings (12 port A/port B, 8 CELL18), not 6.
2026-11-14 Docs: rewrite README for the routed 70 x 32 Lean and the isoSPI findings
    Status table for Guard and Lean, Lean at a glance (PH 10 + 9 cell plugs),
    what was learned (20 isoSPI crossings that rerouting cannot remove, ports
    to go at opposite ends, what shrank the board, regulator heat), the open
    items before ordering, and the check commands.
2026-11-14 Docs: isoSPI crossing count is 20, J5 PCB done, Option 1 plan
    - Review fixes: the shield check's 6 missed the chip-side pairs; the count is
    20 (12 port A vs port B, 8 CELL18 vs either port).
    - Lean cell plugs: the PCB was placed and routed in 7cea3ca; the isoSPI
    reroute is Option 1 (keep the floorplan, move the small parts).
    - Open items: connector line says Lean's PH 10 + 9.
2026-11-14 Schematic (Lean): port B termination in 0402 (regenerated by make_lean.py)
    R601/R602 51 ohm 0603 -> 0402 (0402WGF510JTCE, C25125) and C601/C602
    10 nF 0603 -> 0402 (CL05B103KB5NNNC, C15195), Lean only through the swap
    table. The isoSPI reroute puts port B's termination at the chip end
    between U1 and T601: four 0603 parts need 13.1 mm of the 10.08 mm there,
    four 0402 about 7.4 mm. Nets unchanged; checker 0 problems, ERC 0/0.
    [adbms1818-slave-18s-lean.kicad_sch]
2026-11-14 PCB (Lean): isoSPI Option 1, 0 foreign crossings
    Floorplan kept (U1, plugs, rows, NTC block, transformers, holes, outline).
    - Port B's 0402 termination sits at the chip end between its two lines:
    IPB low into T601 pin 1, IMB high over the pins into pin 3, one IMB hop
    under IPB on In1 by the chip. C602 lies just left of T601; CT passes
    under IMB on In1 inside T601's own courtyard.
    - Port A drops to In1 by its pins and runs through the strip under T601,
    freed by port B's old row. The In1 V- link and the IPB B.Cu hop are gone.
    - CELL18 reaches R302 on In2 down the gap between U1's exposed pad and its
    right pad column, then along the bottom edge. R302 is turned so its
    CELL18 pad is o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
    [adbms1818-slave-18s-lean.kicad_pcb]
2026-11-14 Docs: isoSPI Option 1 applied, foreign crossings closed
    Design basis: why port B's termination is 0402, the new port B/port A/
    CELL18 routes, VCOLL copper and track lengths before and after, the check
    results, and a new open item: the reviewer's OK for the termination at
    the chip end. "Lean isoSPI foreign crossings" is closed (0 crossings).
2026-11-14 Site: news for isoSPI Option 1 (0 crossings) and the Option 2 study
    News: Nov 13 entries (crossing check fixed, 20 not 6; cell plugs 10 + 9)
    and Nov 14 (Option 1, 0 crossings, 0402 termination at the chip end); Now
    is the Option 2 study, Next the pre-order review. New copper plot and 3D
    render, part row for the 0402 termination, review card for its placement.
    Board Boxes export refreshed for the rerouted Lean board; check_hosted
    passes.
2026-11-14 Tools: split-ends floorplan study (placement + lane count)
    split_ends_place.py places courtyards on a scratch copy with U1 turned
    90 deg clockwise from today and a port at each end (refuses the real Lean
    board). split_ends_render.py counts lanes per layer at the as-built
    pitches, checks the lane sketch for isoSPI crossings and draws it.
    --fan 4.9 --band 3.5 gives 70 x 34.2 mm, 0 overlaps, 0 crossings.
2026-11-14 Docs: isoSPI Option 2 feasibility, a port at each end
    As first drawn (U1 turned 180 deg) it needs 38.5 mm: the cell lanes wrap
    round the chip. With U1 turned 90 deg clockwise from today the cells
    enter three sides in row order and it fits 70 x 34.2 mm on a scratch
    copy, 0 isoSPI crossings, chip-side pairs 22-30 mm. Floorplan choice
    added to the open items; helper scripts added to AGENTS.md.
2026-11-14 Site: news for the Option 2 study (a port at each end, 70 x 34.2)
    New Nov 14 entry with the study picture, Now becomes the floorplan
    choice, hero and review card updated. Real board unchanged.
